pepocasella/Projeto-Mecatronico/Mecânica/Garra/Imagens/s-l1600-1.jpg

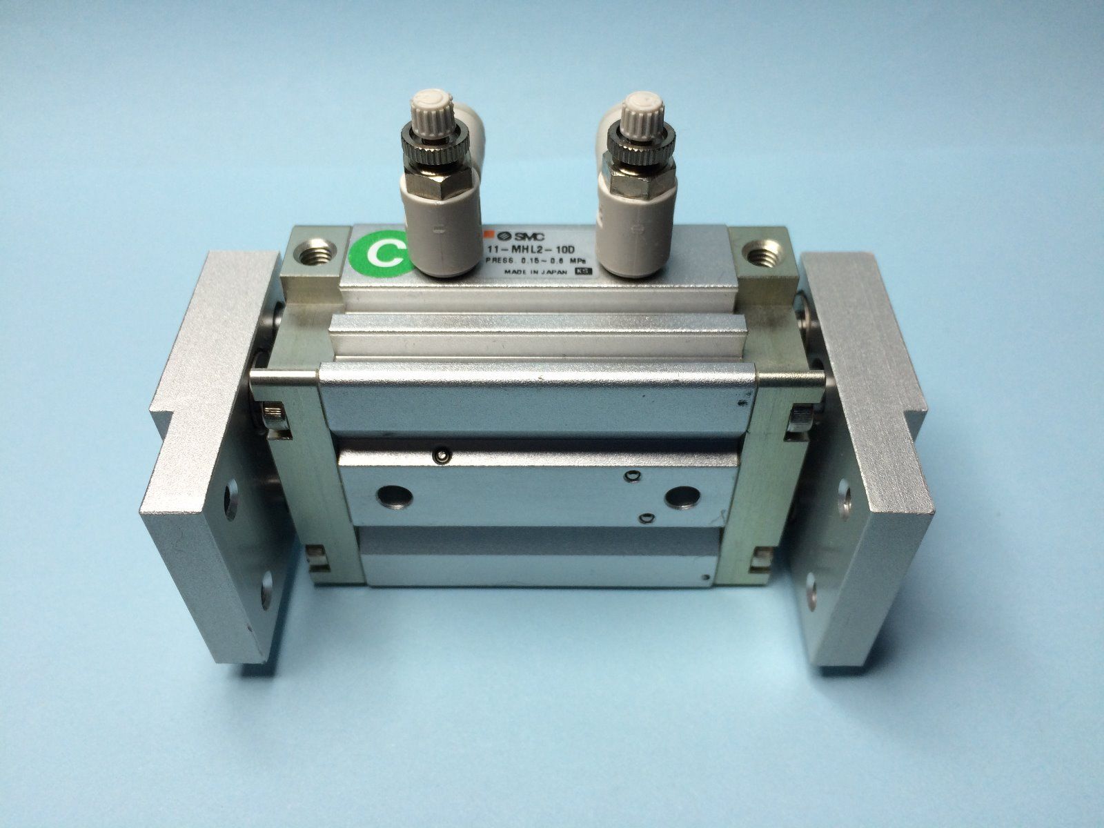
Mecânica/Garra/Imagens/s-l1600-1.jpg
