pepocasella/Projeto-Mecatronico/README.md

# Projeto-Mecatronico
sistema pórtico de eixos X,Y e Z, com função de seleção de peças por meio de certos parâmetros e um mecanismo para posicionamento e captura de peças em posições de pega (Pick) e solta (Place) definidas pelo usuário.


Full Assembly
THE REAL PAULERA v4
