pepocasella/Projeto-Mecatronico/Elétrica/Sensor de Distância/geometria.pptx

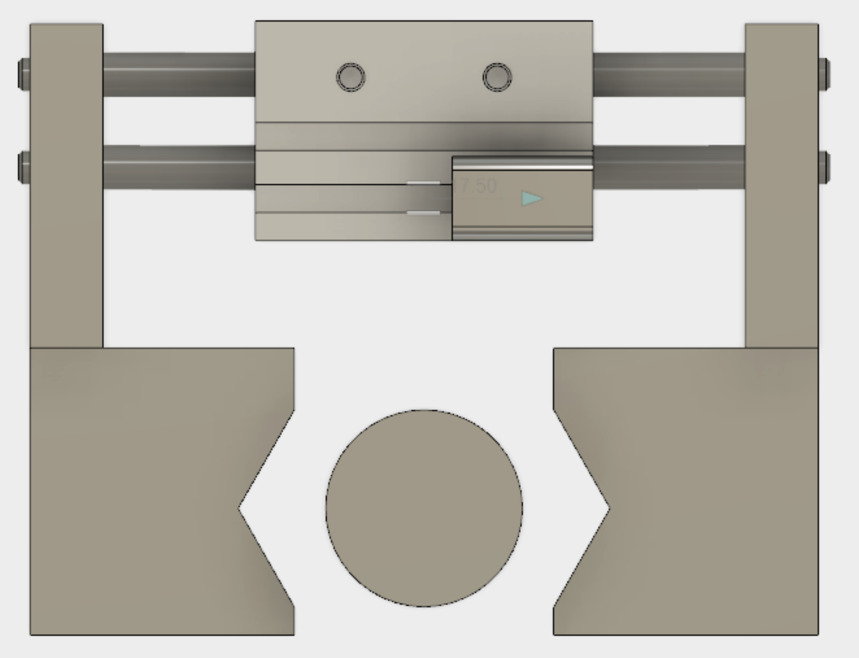
[picture p19: figure]

Bloco Garra

SensorTCRT5000

Haste da garra

Distância_(sensor_(centro))

Distancia_(sensor)

R

cosθ∙D

D

Ө

Centro_(tarugo)

Tarugo de polímero
