pepocasella/Projeto-Mecatronico/Documentos Gerais/Fluxogramas/FluxogramasGrupoDiametro.docx

Fluxogramas dos Algoritmos

Data da criação: 06/06/2017

Data da versão: 10/03/2017

Descrição: Este documento ilustra, por meio de fluxogramas, o funcionamento e as sequências lógicas do dispositivo a ser fabricado pelo grupo. Nele, contém quatro (4) esquemas de fluxogramas, um para cada parte dos algoritmos que serão confeccionados para as partes de: referenciamento; função JOG; capturar e salvar as posições de eixo e posicionamento de eixo.

Fluxograma de Referenciamento

Jog

Pick and Place

Posicionamento de Eixo
