pepocasella/Projeto-Mecatronico/Gates/Gate 1/Ementa GATE1.docx

Ementa GATE #1 21/03/2017

Carlos Magno

- NR aplicada no projeto estar presente no GATE #2;
- Esboço da solução tem que vir depois da matriz de soluções, junto com a interface e os esboços de outras partes do dispositivo;
- Especificar mais a função global;
- “Pegar Peça” na função global;
- Gant: projeto detalhado não tem que ter mais tempo?
- Gant: mais prototipação = menos erros;
- Estrutura de função com “- ruído”. Como minimizar isso?
- Estrutura de funções está confusa.

Arruda

- Estrutura de funções:
  - Traduzir para projeto;
  - Considerar homem-máquina.
- Anotar o budget;
- Gant: colocar tarefas paralelamente e com responsáveis;

Lourenço

- Acentos, gramática.

Sylvio

- Sem variantes = tomamos o risco;
- NR-12 depois, GATE #2;
- Colocar tampa no dispositivo.

Fabio

- Lista de requisitos tem que estar presente;
- Quem falou ruído? (NR, Usuário, etc)
- Ruído tem que virar sub-função;
- Conversar mais com o usuário;
- Função global com cores diferentes, atenção aos verbos e palavras;
- Nós sabemos PDP? TEM QUE ESTAR NA DOCUMENTAÇÃO.
