pepocasella/Projeto-Mecatronico/Gates/Gate 1/Função Global.pptx

Peça

Selecionar Tarugos de Polímero pelo Diâmetro

Peça

Informações

Energia Elétrica

Vibração

Informações

Ruído

Calor
