pepocasella/Projeto-Mecatronico/Mecânica/Guia Linear/GUIA ERRADA/Especificação das Guias Lineares.pdf

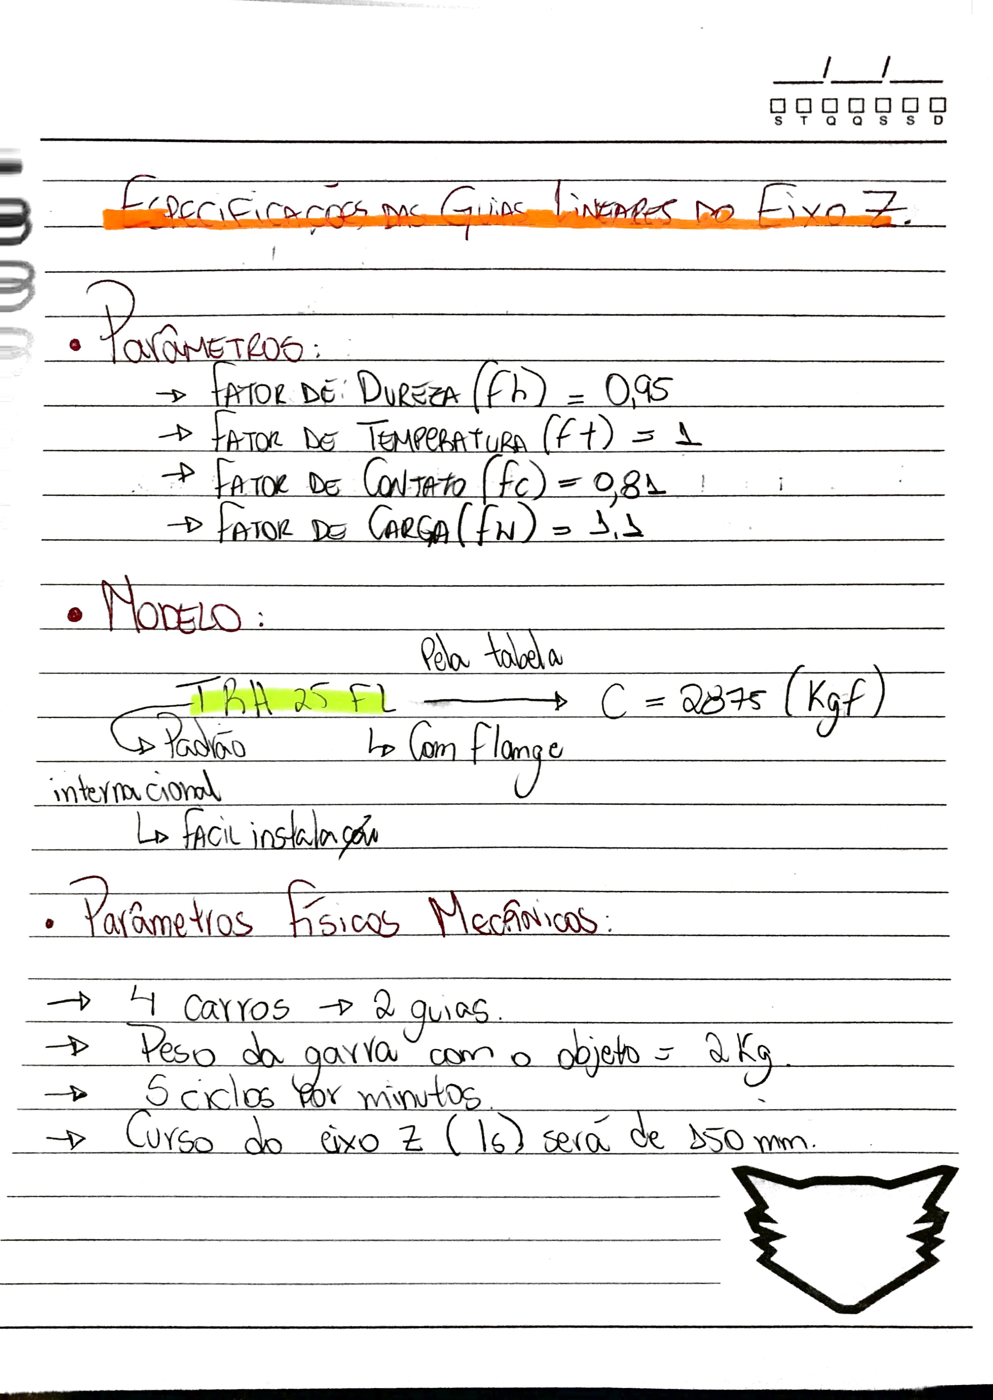
[picture p65: page 1]
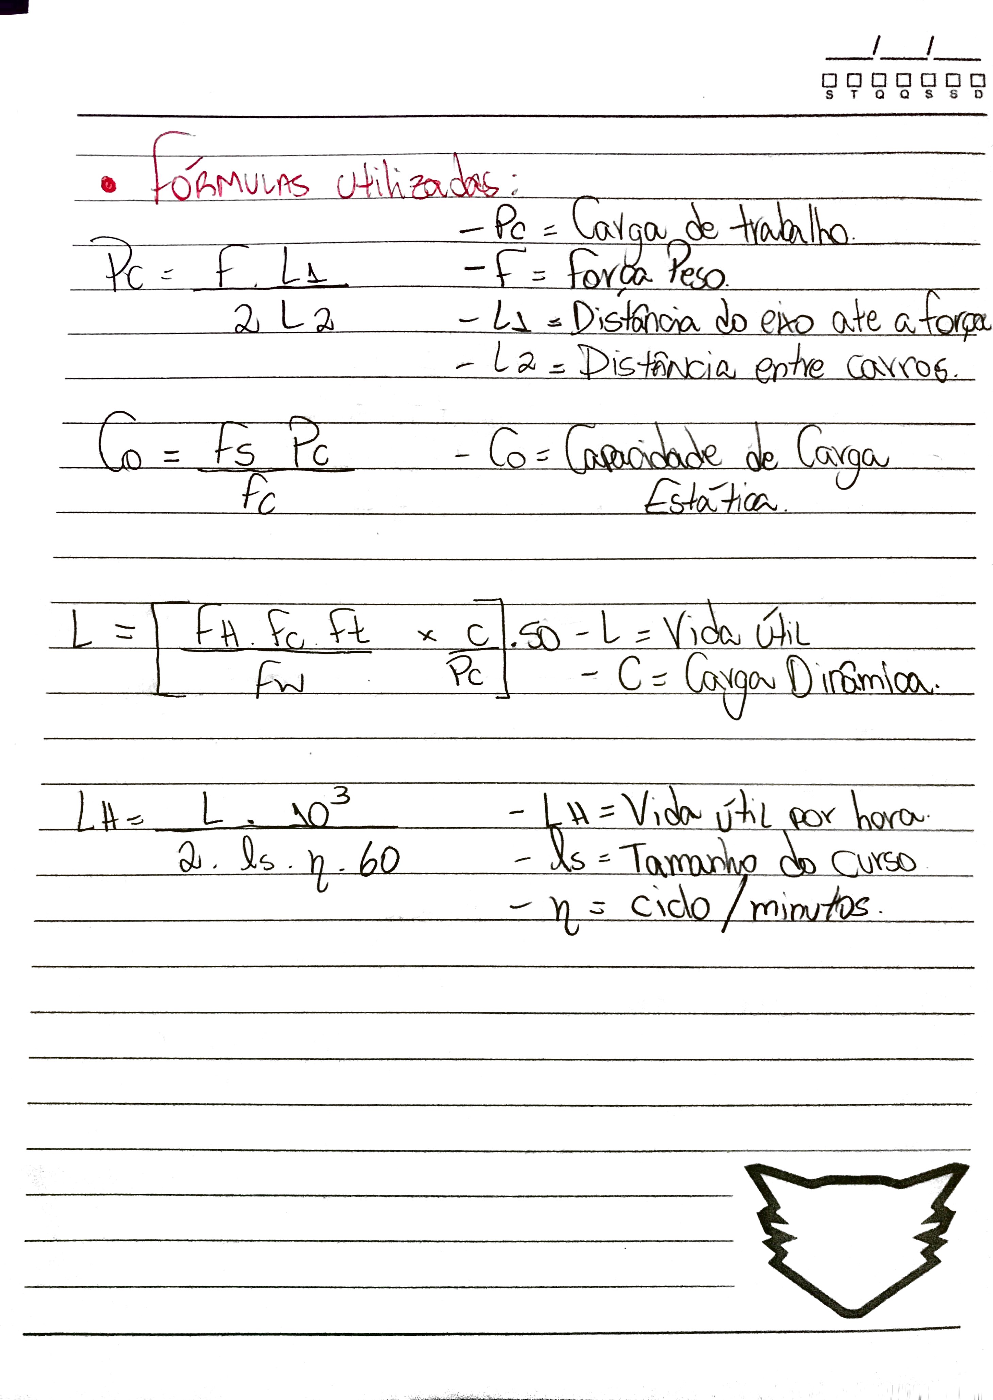
[picture p66: page 2]
