pepocasella/Projeto-Mecatronico/Elétrica/Sensor de Distância/geometria.PNG

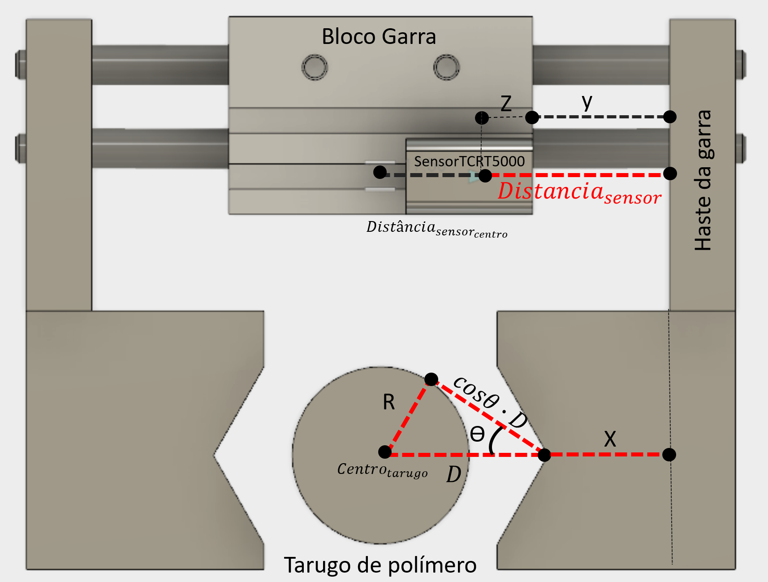
Elétrica/Sensor de Distância/geometria.PNG
