pepocasella/Projeto-Mecatronico/FOTOS_PROJETO_MECAT/20170602_114746.jpg

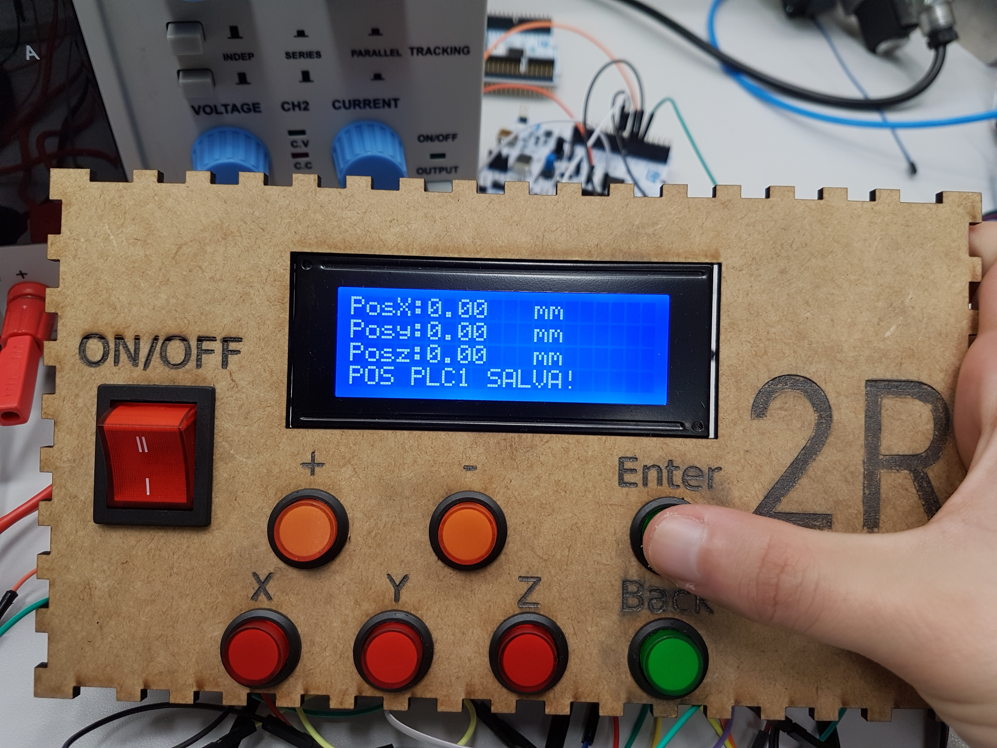
FOTOS_PROJETO_MECAT/20170602_114746.jpg
