pepocasella/Projeto-Mecatronico/FOTOS_PROJETO_MECAT/20170602_114902.jpg

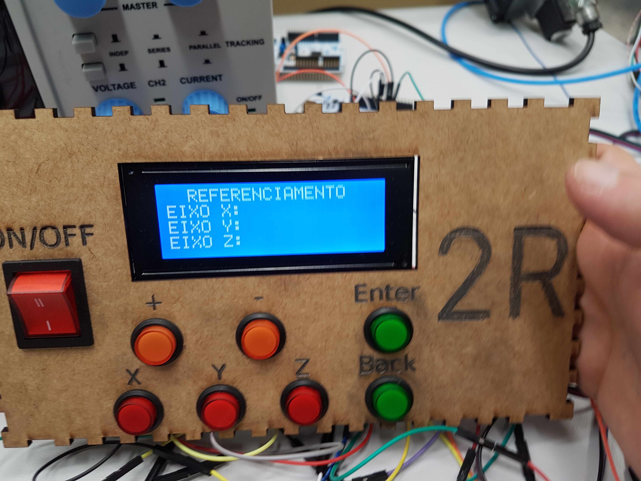
FOTOS_PROJETO_MECAT/20170602_114902.jpg
