pepocasella/Projeto-Mecatronico/FOTOS_PROJETO_MECAT/20170602_114916.jpg

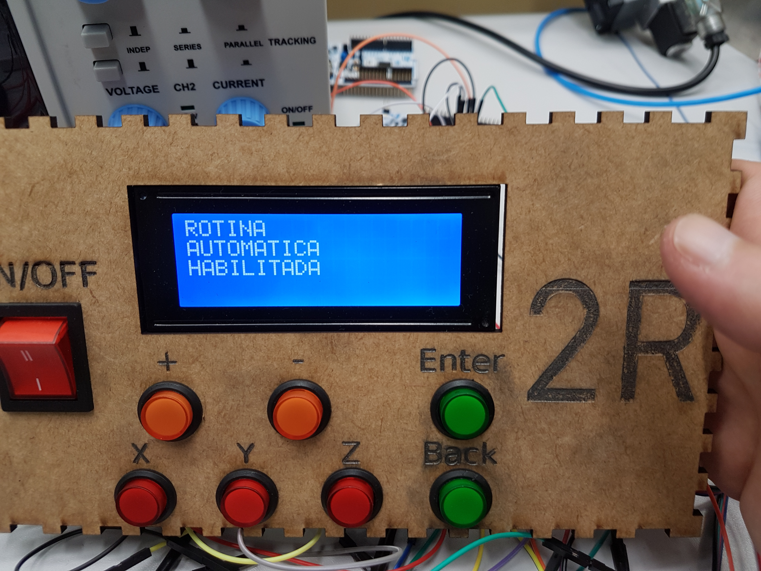
FOTOS_PROJETO_MECAT/20170602_114916.jpg
