pepocasella/Projeto-Mecatronico/FOTOS_PROJETO_MECAT/20170602_114933.jpg

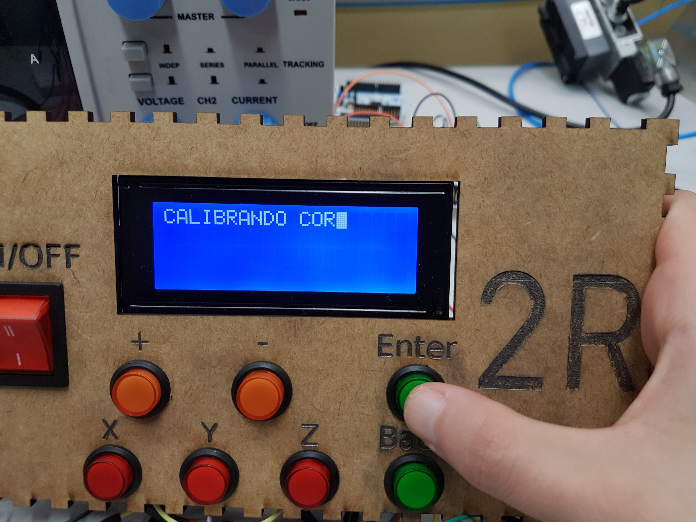
FOTOS_PROJETO_MECAT/20170602_114933.jpg
