pepocasella/Projeto-Mecatronico/FOTOS_PROJETO_MECAT/20170602_115433.jpg

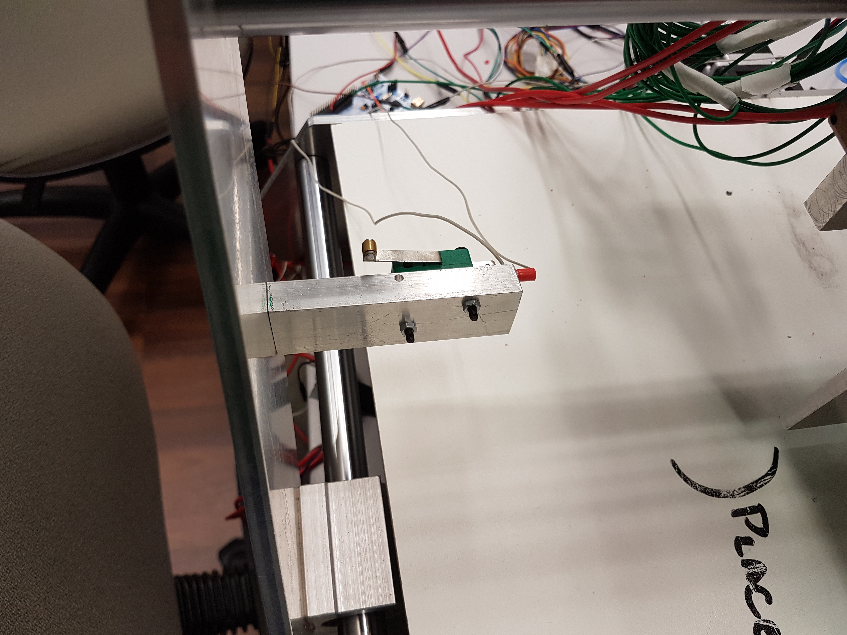
FOTOS_PROJETO_MECAT/20170602_115433.jpg
