pepocasella/Projeto-Mecatronico/FOTOS_PROJETO_MECAT/20170602_115439.jpg

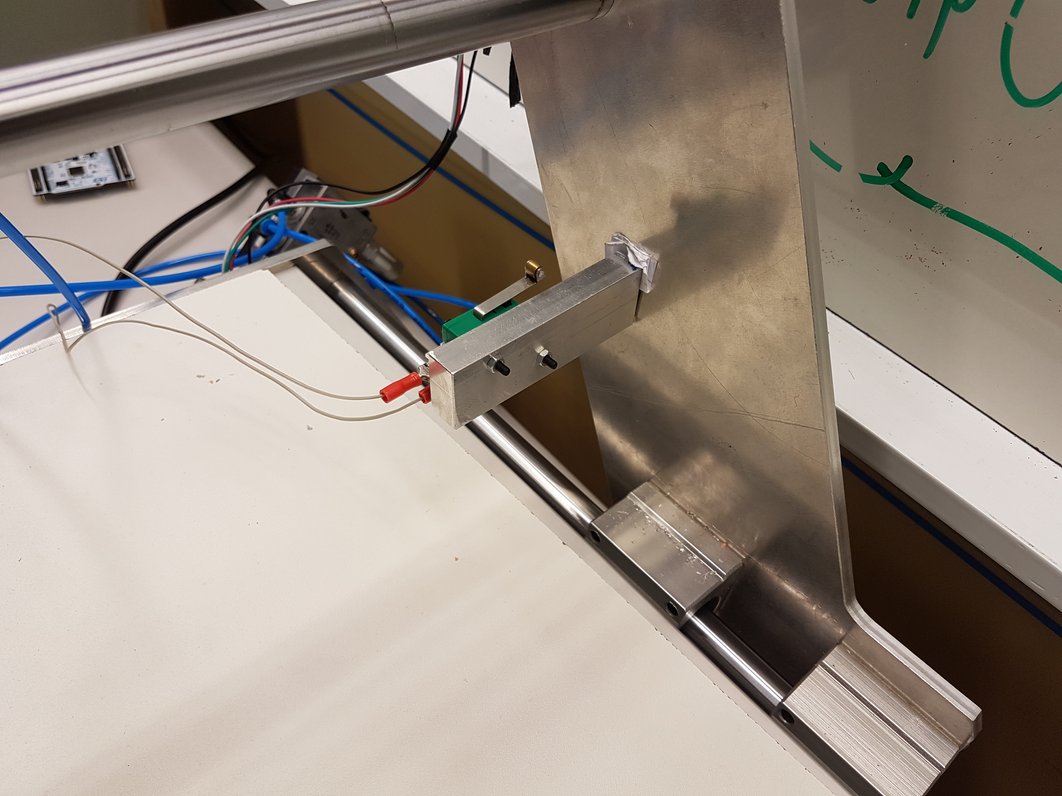
FOTOS_PROJETO_MECAT/20170602_115439.jpg
