pepocasella/Projeto-Mecatronico/FOTOS_PROJETO_MECAT/20170602_115500.jpg

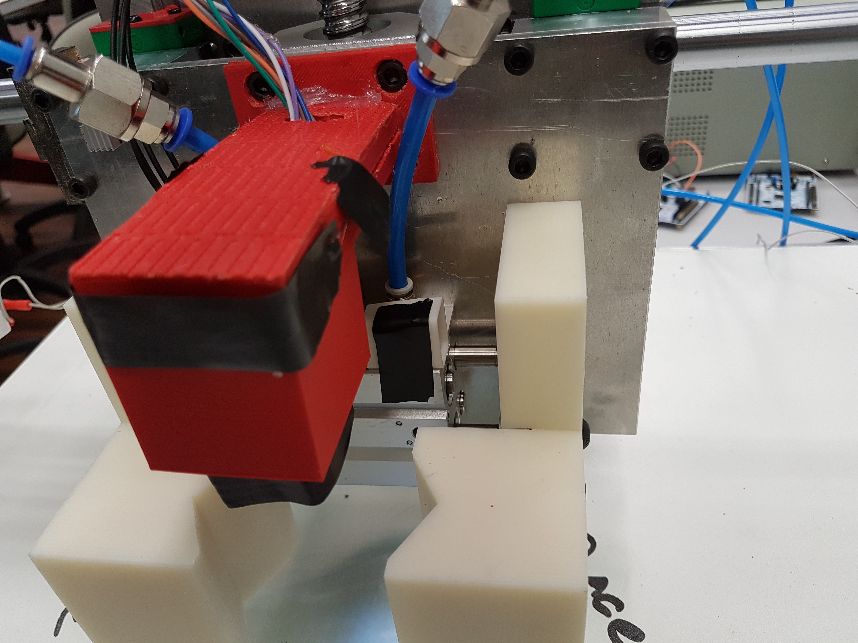
FOTOS_PROJETO_MECAT/20170602_115500.jpg
