pepocasella/Projeto-Mecatronico/FOTOS_PROJETO_MECAT/botao_x_on_off.PNG

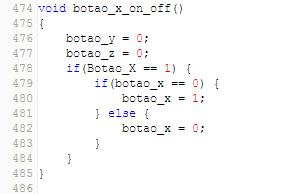
FOTOS_PROJETO_MECAT/botao_x_on_off.PNG
