pepocasella/Projeto-Mecatronico/FOTOS_PROJETO_MECAT/MOVIMENTACAO EIXO NEGATIVA.PNG

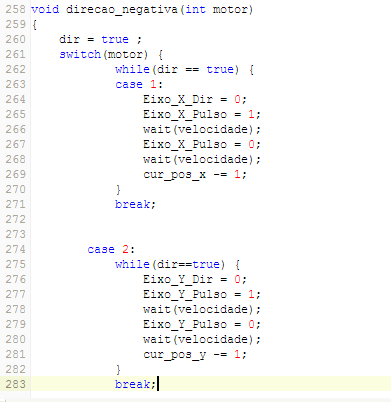
FOTOS_PROJETO_MECAT/MOVIMENTACAO EIXO NEGATIVA.PNG
