pepocasella/Projeto-Mecatronico/FOTOS_PROJETO_MECAT/MOVIMENTACAO EIXO.PNG

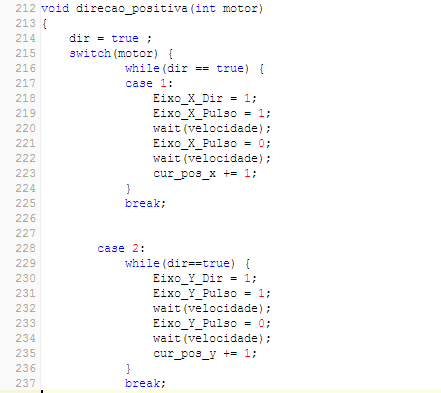
FOTOS_PROJETO_MECAT/MOVIMENTACAO EIXO.PNG
