pepocasella/Projeto-Mecatronico/Gates/Gate 1/Desenho Rascunho 1.jpg

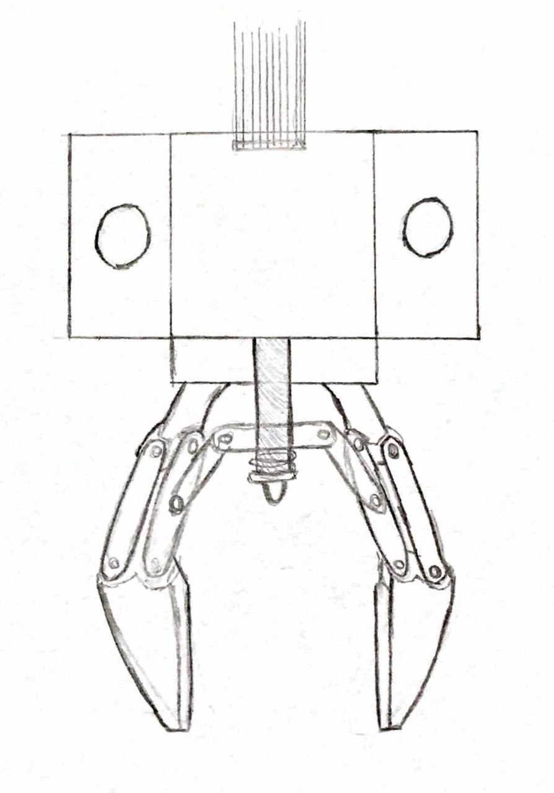
Gates/Gate 1/Desenho Rascunho 1.jpg
