pepocasella/Projeto-Mecatronico/Gates/Gate 1/Desenho Rascunho 2.jpg

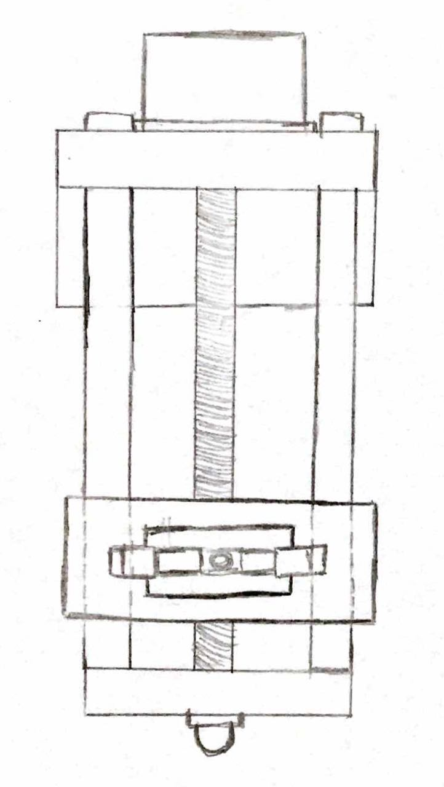
Gates/Gate 1/Desenho Rascunho 2.jpg
