pepocasella/Projeto-Mecatronico/Gates/Gate 1/Estrutura de Funções.jpeg

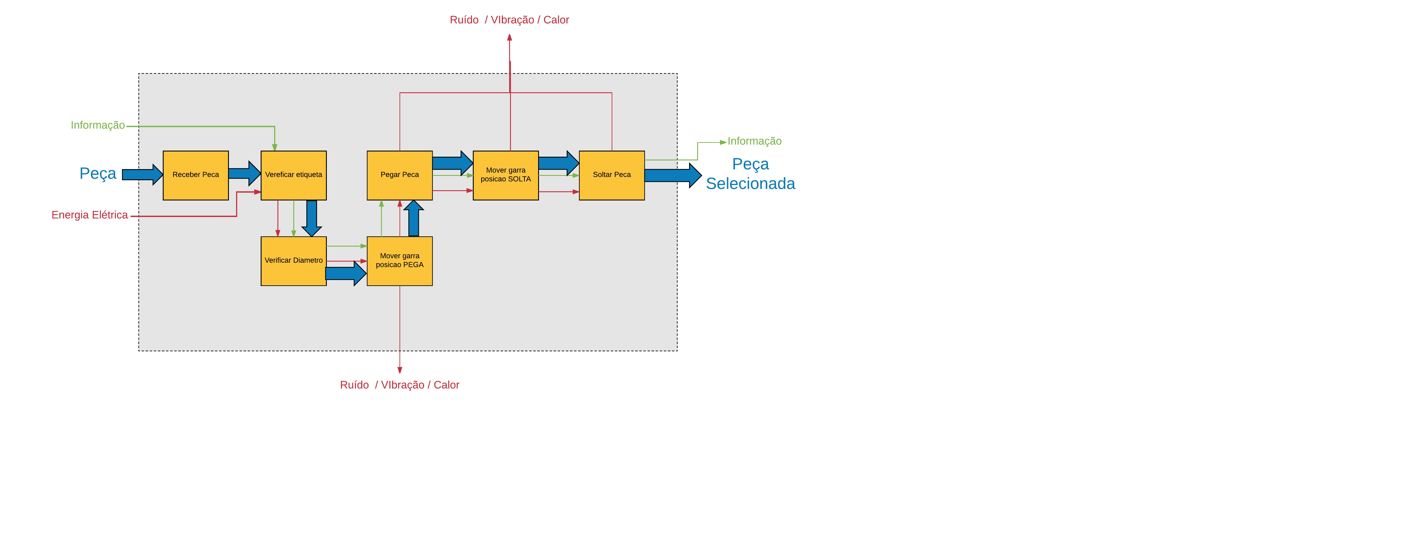
Gates/Gate 1/Estrutura de Funções.jpeg
