pepocasella/Projeto-Mecatronico/Gates/Gate 1/mover garra posiçao.PNG

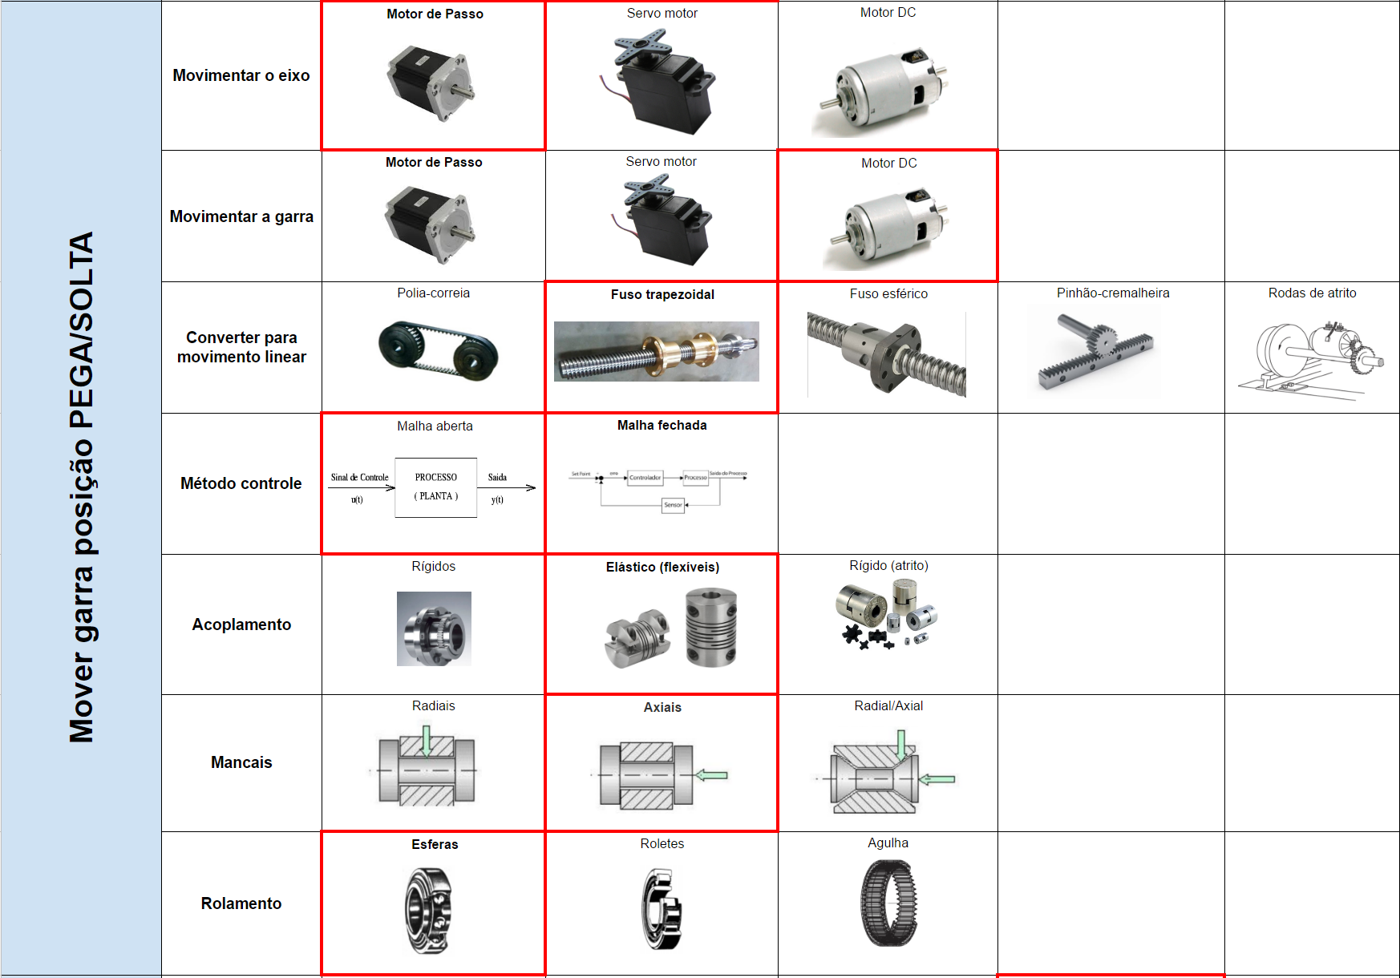
Gates/Gate 1/mover garra posiçao.PNG
