pepocasella/Projeto-Mecatronico/Gates/GATE 2/FOTOS/BF12.PNG

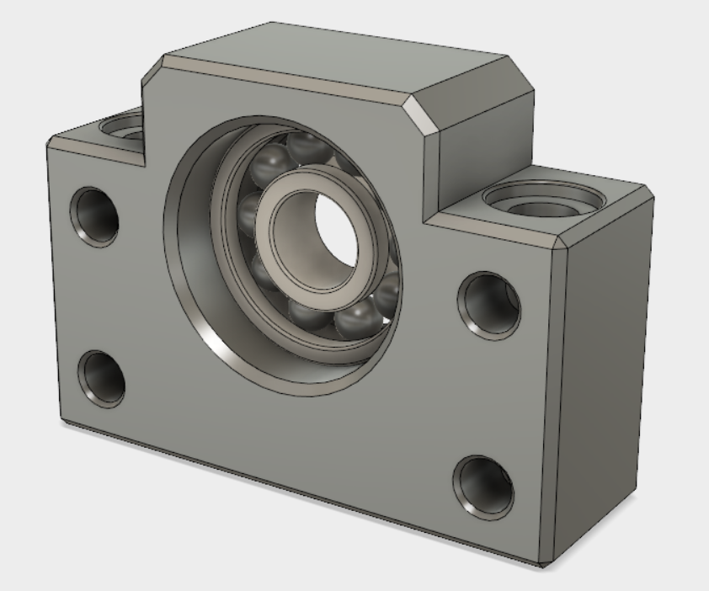
Gates/GATE 2/FOTOS/BF12.PNG
