pepocasella/Projeto-Mecatronico/Gates/GATE 2/FOTOS/BK12.PNG

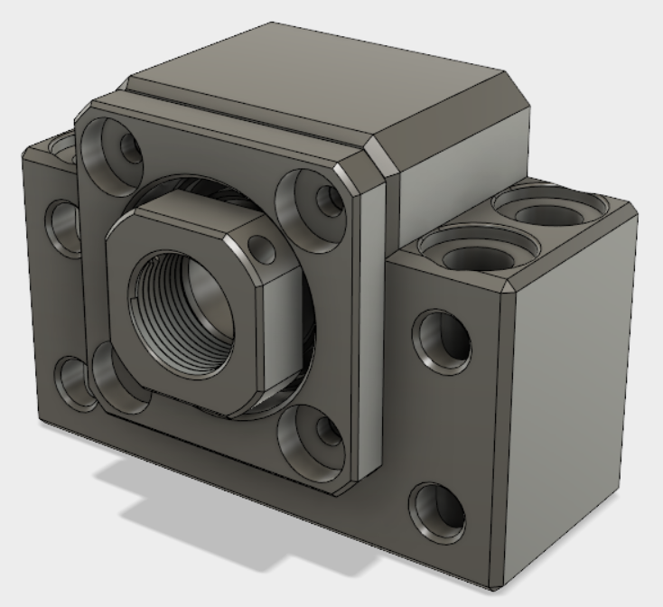
Gates/GATE 2/FOTOS/BK12.PNG
