pepocasella/Projeto-Mecatronico/Gates/GATE 2/FOTOS/Bloco Guia Linear.PNG

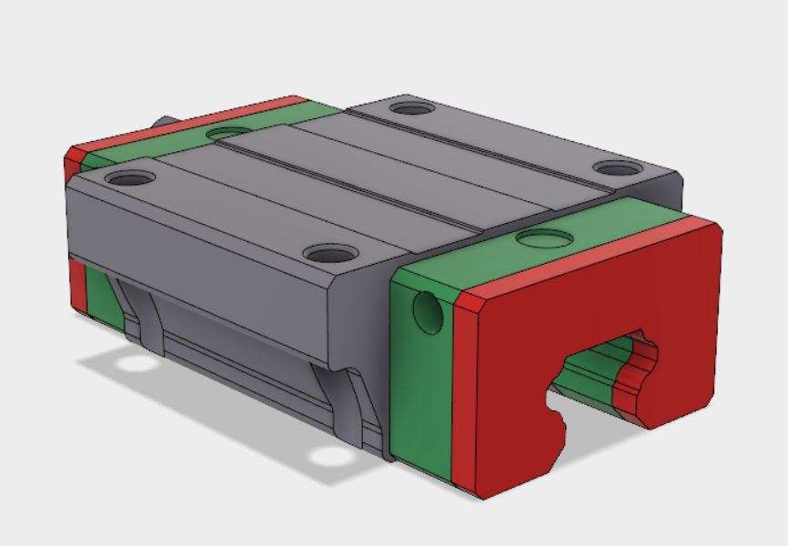
Gates/GATE 2/FOTOS/Bloco Guia Linear.PNG
