pepocasella/Projeto-Mecatronico/Gates/GATE 2/FOTOS/FUSO FINAL.PNG

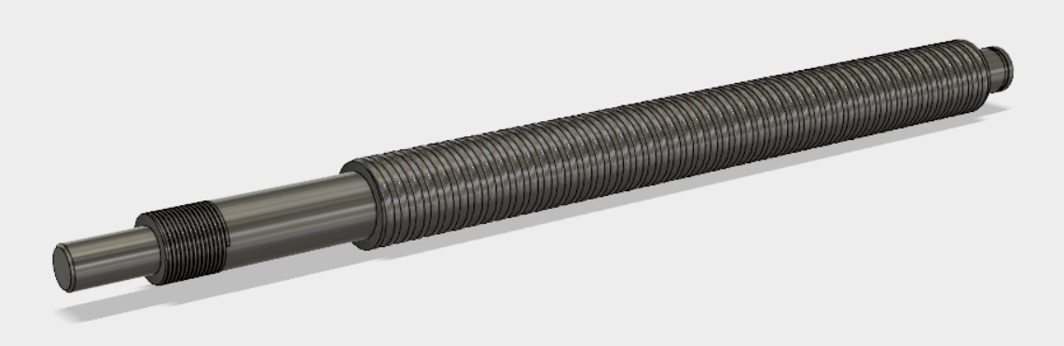
Gates/GATE 2/FOTOS/FUSO FINAL.PNG
