pepocasella/Projeto-Mecatronico/Gates/GATE 2/FOTOS/GARRA + HASTES.PNG

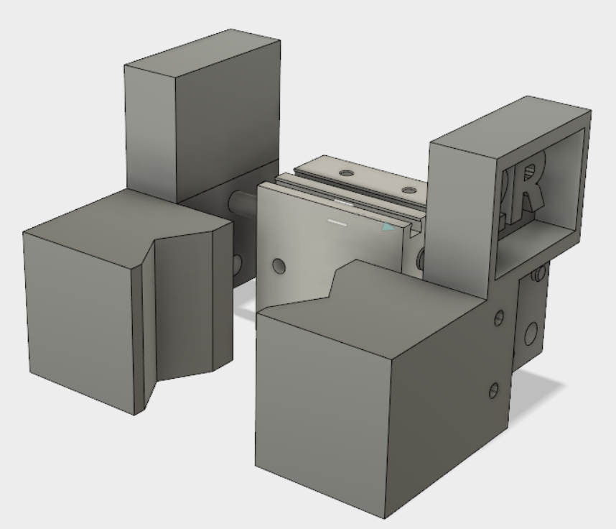
Gates/GATE 2/FOTOS/GARRA + HASTES.PNG
