pepocasella/Projeto-Mecatronico/Gates/GATE 2/FOTOS/Screen Shot 2017-06-05 at 18.27.19.png

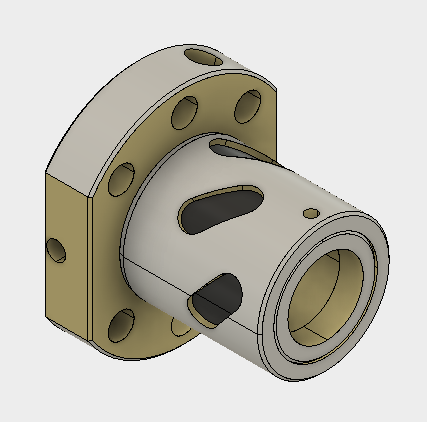
Gates/GATE 2/FOTOS/Screen Shot 2017-06-05 at 18.27.19.png
