pepocasella/Projeto-Mecatronico/Gates/GATE 2/FOTOS/THE REAL PAULERA v4.png

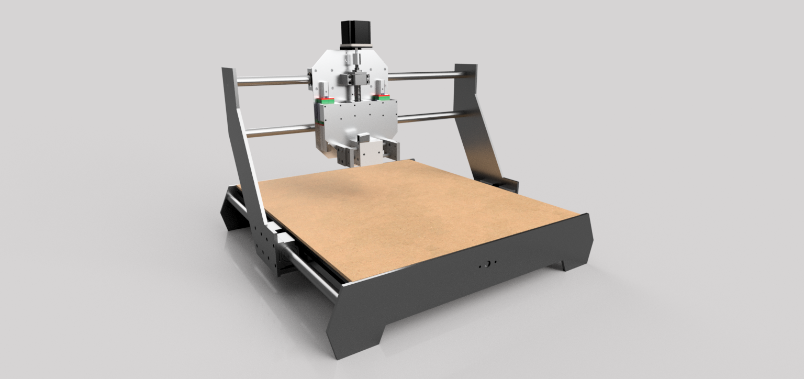
Gates/GATE 2/FOTOS/THE REAL PAULERA v4.png
