pepocasella/Projeto-Mecatronico/Mecânica/CADs/BF12/Renderings/rendering1.png

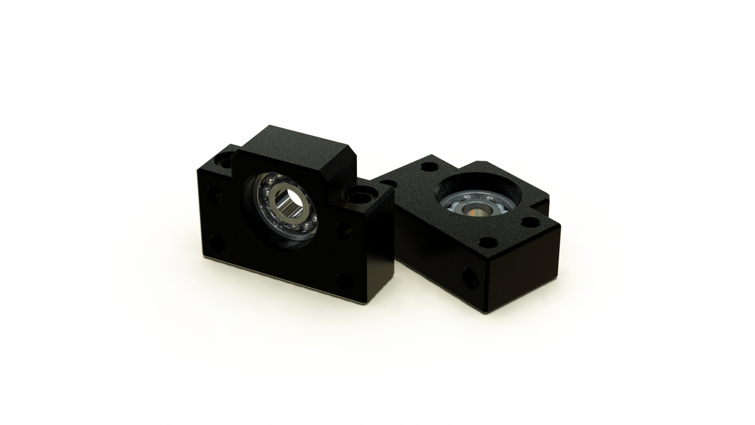
Mecânica/CADs/BF12/Renderings/rendering1.png
