pepocasella/Projeto-Mecatronico/Mecânica/CADs/BF12/Renderings/rendering3.png

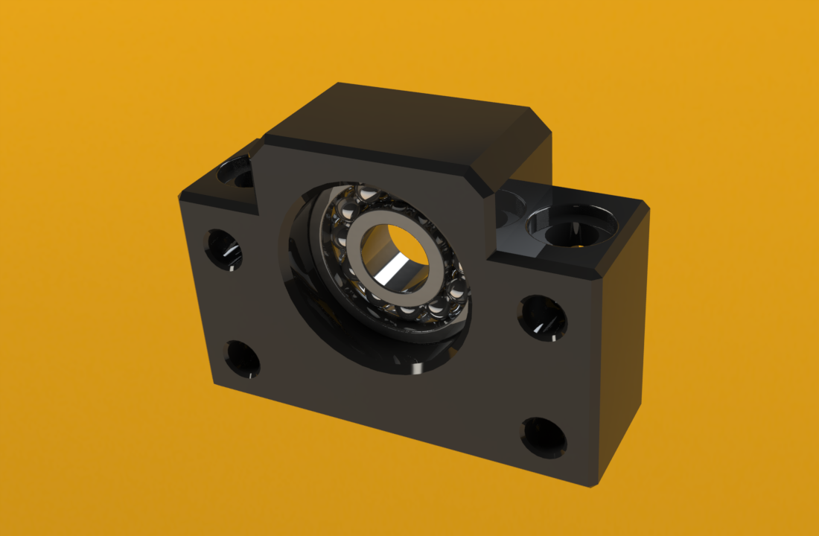
Mecânica/CADs/BF12/Renderings/rendering3.png
