pepocasella/Projeto-Mecatronico/Mecânica/CADs/BF12/Renderings/rendering4.png

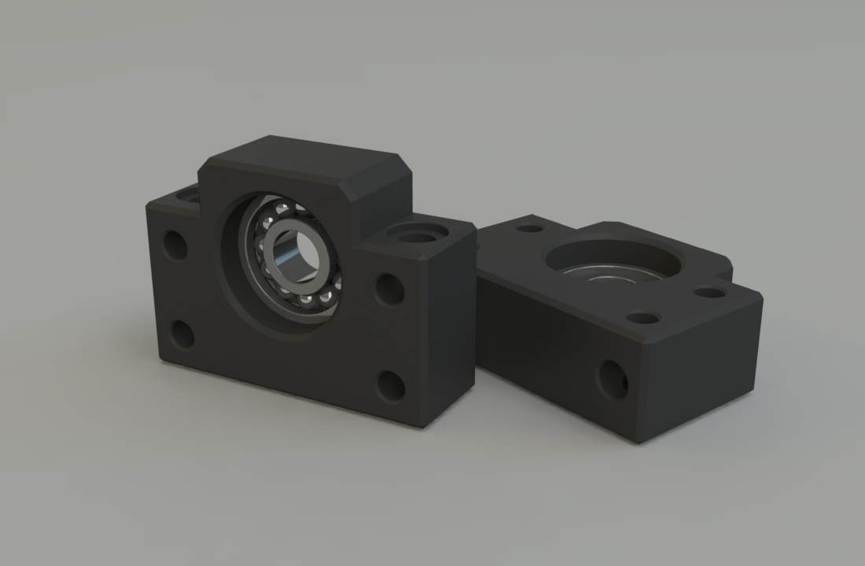
Mecânica/CADs/BF12/Renderings/rendering4.png
