pepocasella/Projeto-Mecatronico/Mecânica/CADs/BF12/Renderings/rendering5.png

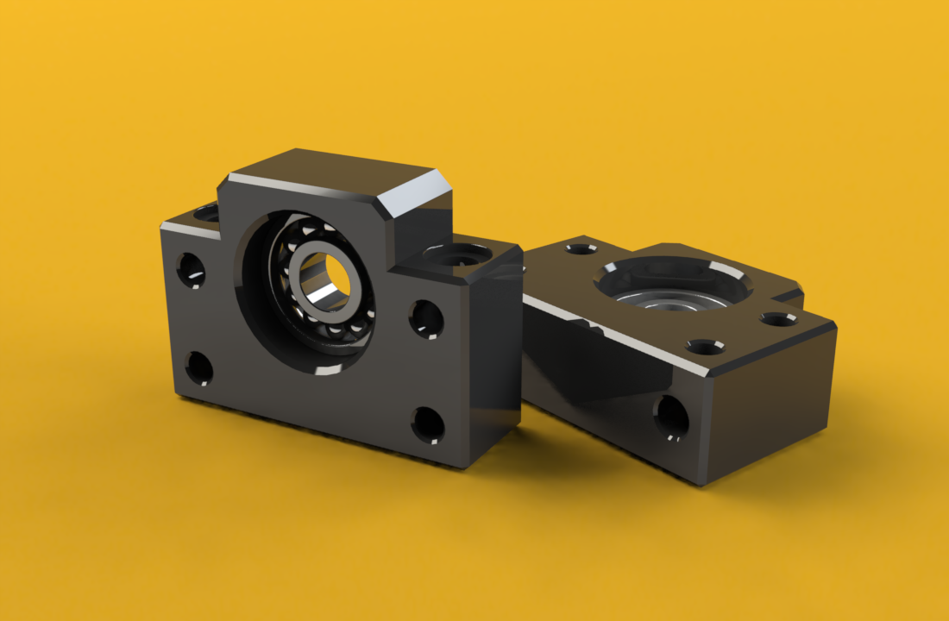
Mecânica/CADs/BF12/Renderings/rendering5.png
