pepocasella/Projeto-Mecatronico/Mecânica/CADs/BF12/Renderings/snapshot1.png

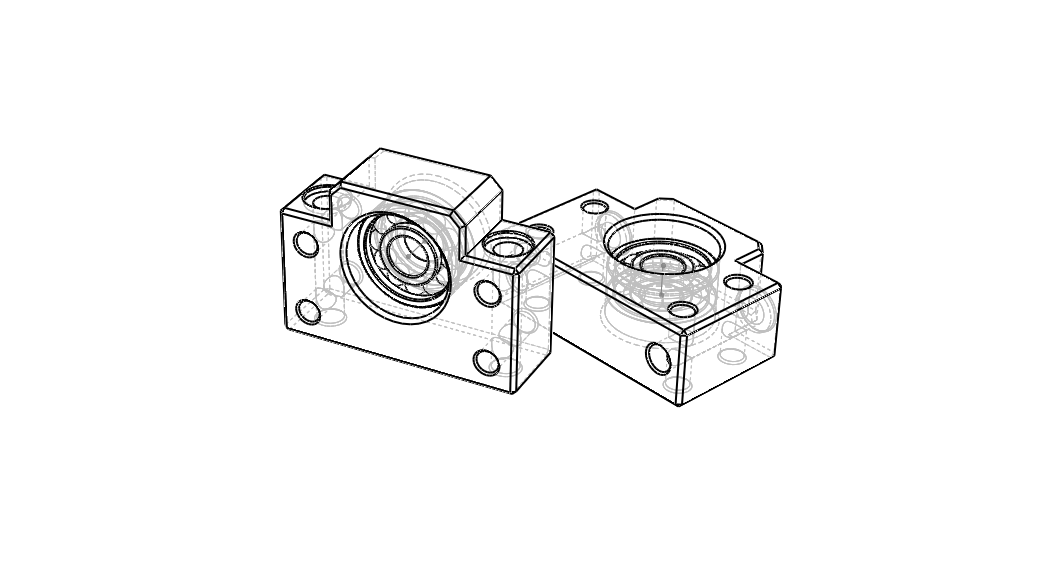
Mecânica/CADs/BF12/Renderings/snapshot1.png
