pepocasella/Projeto-Mecatronico/Mecânica/CADs/BF12/Renderings/snapshot3.png

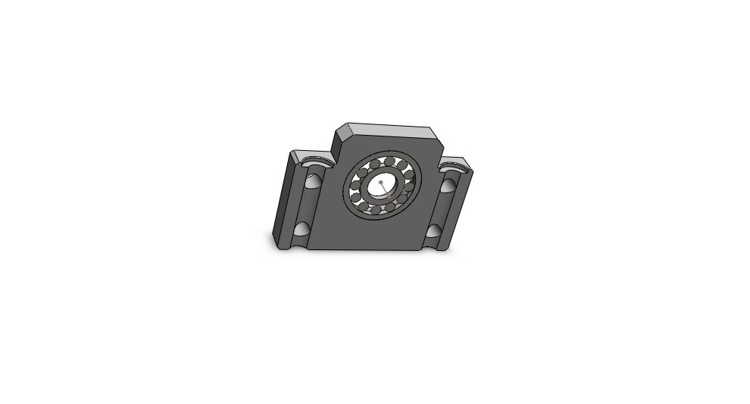
Mecânica/CADs/BF12/Renderings/snapshot3.png
