pepocasella/Projeto-Mecatronico/Mecânica/CADs/Suporte Castanha/render.gif

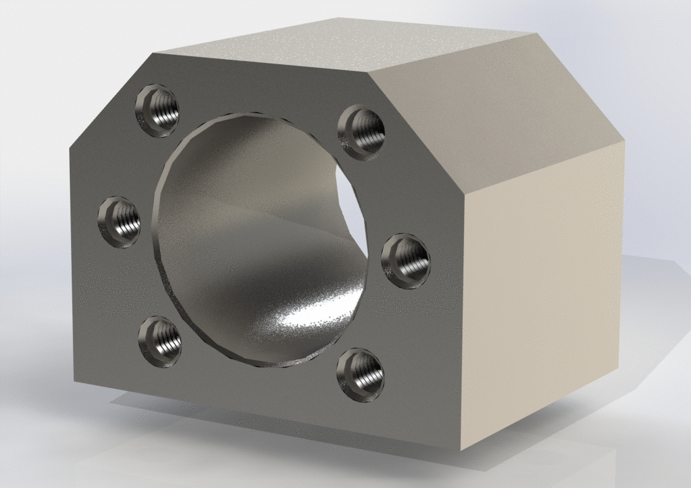
Mecânica/CADs/Suporte Castanha/render.gif
