pepocasella/Projeto-Mecatronico/Mecânica/Garra/Imagens/s-l1600-2.jpg

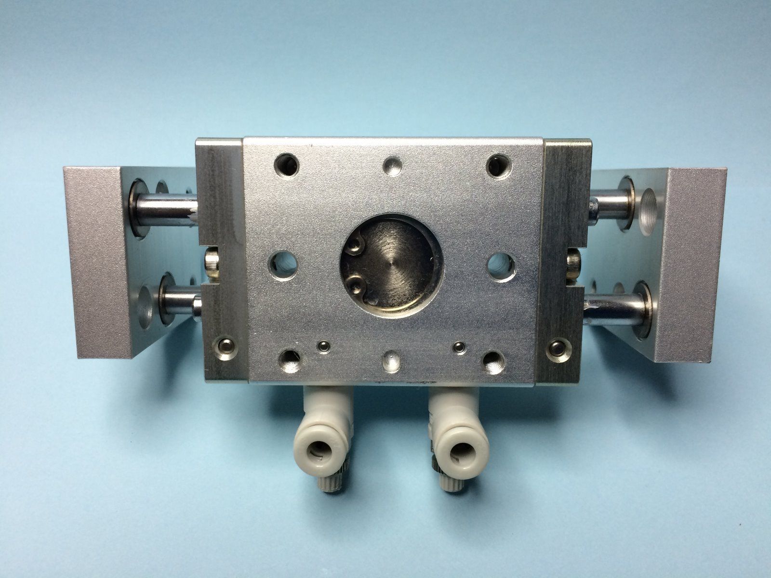
Mecânica/Garra/Imagens/s-l1600-2.jpg
