pepocasella/Projeto-Mecatronico/Mecânica/Garra/Imagens/s-l1600-3.jpg

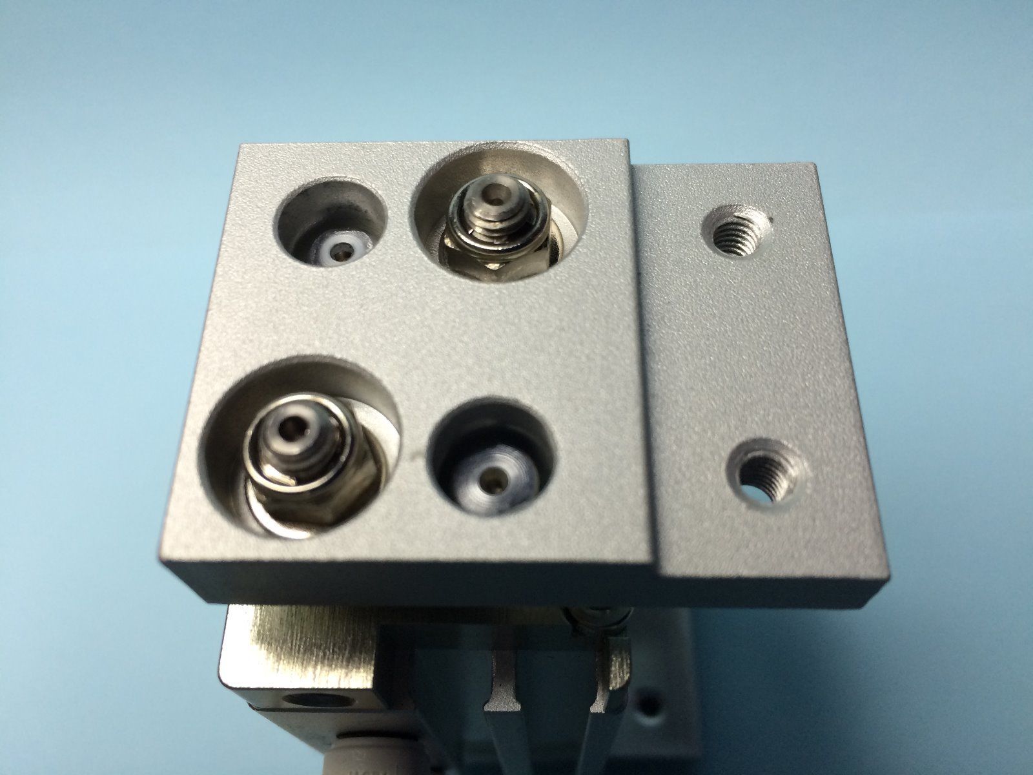
Mecânica/Garra/Imagens/s-l1600-3.jpg
