pepocasella/Projeto-Mecatronico/Mecânica/Garra/Imagens/s-l1600-4.jpg

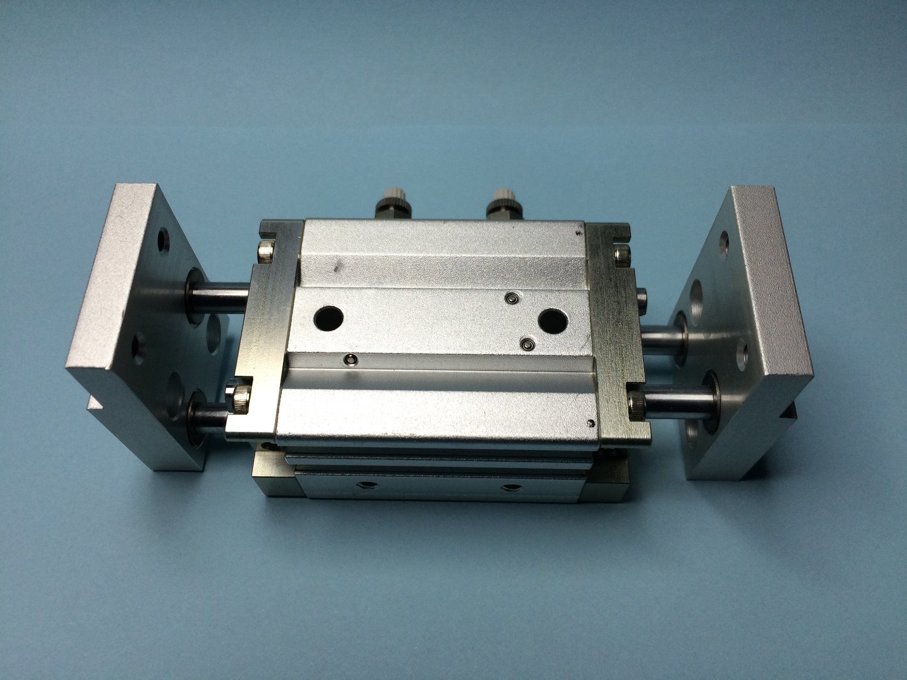
Mecânica/Garra/Imagens/s-l1600-4.jpg
