pepocasella/Projeto-Mecatronico/Mecânica/Orçamentos/Contato Orcamento Mectrol.jpg

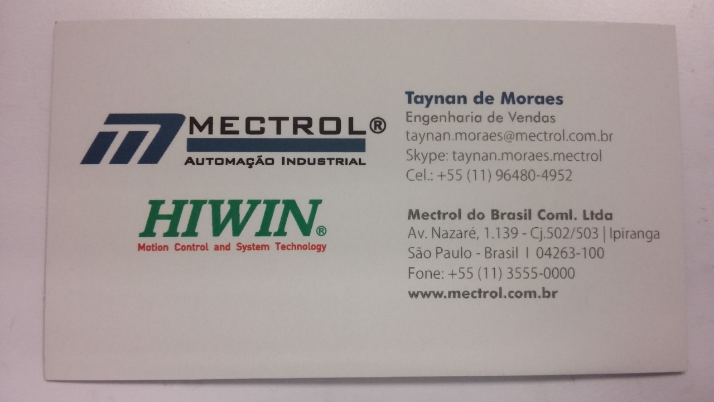
Mecânica/Orçamentos/Contato Orcamento Mectrol.jpg
