pepocasella/Projeto-Mecatronico/Gates/Gate 1/Cópia de Matriz de soluções.xlsx

Sheet: Matriz de soluções
 |  | Grupo | Data de criação: 24/10/2017
 |  |  | Data da versão: 21/03/2017
 |  |  | Versão: 2.0
 |  | Luca Facciolo Avy Pinto Nicolas Fonteyne Gabriel Avy | Resumo: A partir da norma de segurança do trabalho NR-12, este documento destaca os requisitos mínimos que devem ser adotados para garantir a integridade física dos futuros operadores do dispositivo a ser confeccionado na disciplina de Projeto Mecatrônico.
 |  | Função/Solução | Métodos
 |  |  | 1 | 2 | 3 | 4
Receber Peça | A | Zeramento | Chave de fim-de-curso | Sensor indutivo | Sensor capacitivo | Sensor magnético
 | B | Referenciamento de posição | Via software | LVDT | Encoder Absoluto | Potenciometro
Mover a ventosa de sucção para posição PEGA / ESTEIRA | C | Movimentar o eixo | Motor de Passo | Servo motor | Motor DC
 | D | Identificar presença de material | Sensor optico difuso | Ultrassönico | Encoder incremental
Soltar/Segurar Peça | E | Segurar peça | Ventosa de sucção
 | F | Acionamento Sucção | 5/2 Vias | 3/2 vias
 | o

Sheet: Respostas ao formulário 1
Carimbo de data/hora | Untitled Question

Sheet: Faccioli
Receber Peça | Referenciamento de posição relativa | Sensor optico difuso | LVDT | Potenciometro | Encoder incremental | Encoder Absoluto | Ultrassonico
Verificar etiqueta | Identificar cor | RGB sensor
Verificar diâmetro | Identificar as dimensões do objeto | Resolver | Sensor optico | sensor ultrassonico
Referenciamento de posição | Sensor optico difuso | LVDT | Potenciometro | Encoder incremental | Encoder Absoluto | Sensor Ultrassônico
Funcionamento | Emite e recebe um feixe de luz que possibilita o cálculo da distância do objeto refletor | funciona a partir de bobinas eletromagnéticas e a movimentação do objeto interno modifica o campo e consequentemente resulta numa saida analógica diferente de zero | Cada posição corresponde a uma determinada resistência , variada de acordo com o seu deslocamento | Gera pulsos de acordo com seu deslocamento angular | Cada posição do disco corresponde a uma leitura em código binário | Emite uma onda sonora e calcula o tempo de seu retorno
Custo | Baixo-Médio | Muito Alto | Baixo | Médio | Alto | Baixo-Médio
Precisão | Média | Muito Alta | Média | Alta | Muito Alta | Baixa - Alta
Maior Vantagem | Bom custo beneficio | Alta durabilidade e Alta precisão | Excelente custo beneficio | Melhor custo beneficio do que o Encoder Absoluto | Não perde seu referenciamento | Sensores baratos
Maior desvantagem | Limitação de objetos alvo(POUCA PRECISÃO PARA OBJETOS OPACOS) / Distancia de medição baixa | Vibrações e temperatura afetam sua precisão | Durabilidade baixa | Perde seu referenciamento apos desligamento da máquina | Suscetivel a vários tipos de interferencia | Há uma variação muito grande na qualidade destes sensores
Referenciamento da altura | Sensor optico difuso | Sensor Ultrassônico | Sensor indutivo
Funcionamento | Emite e recebe um feixe de luz que possibilita o cálculo da distância do objeto refletor | Emite uma onda sonora e calcula o tempo de seu retorno | Funciona a partir de alterações de campo magnético ao seu redor , o que afeta o seu output
Custo | Baixo-Médio | Baixo-Médio | Baixo
Precisão | Média | Baixa - Alta | Alta
Maior Vantagem | Bom custo beneficio | Sensores baratos | Excelente Custo beneficio
Maior desvantagem | Limitação de objetos alvo(POUCA PRECISÃO PARA OBJETOS OPACOS) / Distancia de medição baixa | Há uma variação muito grande na qualidade destes sensores | Funciona bem só com materiais ferro magneticos
Identificar cor | Sensor de cor RGB
Funcionamento | Cada cor representa uma porta e cada porta tem uma variação em sua tensão de acordo com a cor captada pelo sensor
Custo | Baixo
Precisão | Alta
Maior Vantagem | -
Maior desvantagem | -
Identificar as dimensões do objeto | Resolver | Sensor optico difuso | sensor ultrassonico | Medição pela Garra
Funcionamento | Funcionamento eletromagnético que consegue medir deslocamentos angulares , gerando uma tensão senoidal de acordo com a variação do angulo | Emite e recebe um feixe de luz que possibilita o cálculo da distância do objeto refletor | Emite uma onda sonora e calcula o tempo de seu retorno | -
Custo | Alto | Baixo-Médio | Baixo-Médio | -
Precisão | Alto | Média | Baixa - Alta | -
Maior Vantagem | Durabilidade e precisão | Bom custo beneficio | Sensores baratos | -
Maior desvantagem | Implementação complexa | Limitação de objetos alvo(POUCA PRECISÃO PARA OBJETOS OPACOS) / Distancia de medição baixa | Há uma variação muito grande na qualidade destes sensores | -

Sheet: Rod
Soltar/Pegar Peça | Segurar peça | Garra Pneumática | Pinça mecanica | Ventosa de sucção
 | Abrir e fechar garra | cremalheira | Fuso trapezoidal | Fuso esferico | Ar comprimido ?????
 | Cuidados com a peça (sensores de força) | Sensor piezoeletrico | Sensor com mola | Extensômetro | sensor de corrente
Segurar peça | Garra Pneumática/mecanica | Pinça mecanica | Ventosa de sucção | A pinça mecanica foi a escolhida, apesar dos seus defeitos, pois a sua implementaçao é mais simples que a ventosa. Obs uma garra pneumatica possui é capaz de realziar elevado nuemro de forca e torque, o que nao é necessario nesse peojeto | Ventosa com fole, o tipo mais adequado de ventosa para o sistema estudado
Funcionamento | hastes com parte inferior metálica para medir e parte superior com suporte emborrachadas para aderência | Haste com suporte de borracha para prender a peça, graças ao atrito. | cones que manipulam a pressao do ar para se manter fixado e outras superficies | https://www.passeidireto.com/arquivo/17727552/pneumatica-e-tecnicas-de-comando/19 | https://www.passeidireto.com/arquivo/17727552/pneumatica-e-tecnicas-de-comando/19
Dificuldade na implementacao | media | baixa | grande
Danifica a peça | sim | sim | nao
Baixo custo | nao | sim | sim
velocidade | media | media | alta
Abrir e fechar garra | cremalheira | Fuso trapezoidal | Fuso esferico | Ar comprimido | O fuso de esfera é o mais indicado, pois possui uma alta velocidade, pacuracia, além de ser o que menos consome energia dos tres, o que a longo prazo pode fazer equivaler com seu alto custo. | "Em casos onde precisa de movimentos muito longos, cremalheira é uma ótima opção, mas é claro que, se voce precisa de exatidão digamos centesimal sempre, fuso de esferas passa a ser a melhor opção em detrimento do investimento..."
funcionamento | Transforma movimento angular em movimento linear | Trabalha acoplado a uma porca trapezoidal | Trabalha acoplado a uma porca esferica( angular em angular) | http://lista.mercadolivre.com.br/ | https://www.youtube.com/watch?v=9xSvRSg7VZA | https://www.youtube.com/watch?v=9xSvRSg7VZA
Custo | baixo | medio | alto |  | http://www.guiacnc.com.br/mecanica-geral-207/sistema-de-tracao-comparacao-entre-(fuso-cremalheira-e-polia)/
Velocidade | media | baixa | alta
Acuracia | baixa | media | alta
Rendimento | baixo | baixo | alto
Cuidados com a peça (sensores de força) | Sensor piezoelétrico | Sensor com mola (fim de curso) | Extensômetro | Sensor de corrente | O melhor sensor para essa aplicacao é o sensor de corrente, apesar de nao possuir o melhor preco, é muito facil de ser implementado no circuito |  | AUTO TRAVAMENTO DO MOTOR(PERGUNTAR PARA FABIO)
Funcionamento | algnus materias conseguem transformar deformacao em tensao devido a pressao | A garra vai apertar o material ate as molas estarem 100%comprimidas, quando isso acontecer o circuito "abre" | É um transdutor que converte deformações mecânicas (flexão e/ou torção) em sinais de resistência elétrica proporcionais | Detecta variacoes na corrente, para isso utiliza o efeito hall
Dificuldade de implementacao | media | baixa | media | Baixa
nome | transdutores piezoelétricos | Push-Button | Strain Gage | ACS712
Preco | 2,20, necessario utilizar mais de 1) | 3,20. | 8.99 | 22.87 |  | (http://lista.mercadolivre.com.br/)

Sheet: Pepo
Mover garra posição PEGA/SOLTA | Movimentar o eixo | Motor de passo | Servo motor | Motor DC
 | Converter para movimento linear | Polia-correia | Fuso trapezoidal | Fuso esferico | pinhão-cremalheira | Rodas de atrito
 | Método controle | Malha aberta | Malha fechada
 | Acoplamento | Rígidos | Elástico (flexíveis) | rígido (atrito)
 | Mancais | Radiais (mancal de apoio) | Axiais (mancal de escora) | Radial/Axial
 | Rolamento | Esferas | Roletes | Agulha
 | Movimentar o eixo | Motor de passo | Servo motor | Motor DC (com escova) | Motor Brushless trifasico
 | custo | Médio | Alto | Baixo | Alto
 | manutenção | Baixa | Alto | Alto | Baixo
 | Circuito Driver Complexidade | Baixa | Alta | Alta | Alta
 | Vibração | Média | Baixa | Alta
 | Torque | Alto | Médio | Alto (caixa de redução)
 | Precisão | Alto | Alto | Baixa
 | Velocidade | Baixa (1000-2000rpm) | Média (3000-5000rpm) | Alta (6000-12000rpm)
 | Resolução | Alta | Alta | Baixa
 | Funcionamento | motores de passo são motores elétricos que possuem pólos fixos para precisão e diferente dos motores de corrente contínua não contém escovas e comutadores. E diferente dos motores de corrente contínua e servomotores é que o motores de passo contém precisão e força. | ervomotores são parecidos com motores de passo, porém contém um sistema de controle interno o qual verifica a posição de entrada com a posição de saída e um motor de corrente contínua. E apesar de terem precisão, o servos não tem muita força como motores de passo. | O motor utiliza imã para se movimentar, isto é, utiliza o magnetismo. Ao aplicar uma tensão de corrente contínua, a corrente passa pelas escovas e depois pelo comutador, o qual faz o eixo girar.
 | Converter para movimento linear | Polia-correia | Fuso trapezoidal | Fuso esférico | pinhão-cremalheira | Rodas de atrito
 | custo | baixo | baixo | médio | baixo | alto
 | vibração | baixo | médio | baixa | alto | baixo
 | exatião no posicionamento | média | baixa | alta | baixo | muito alta
 | capacidade de transmissão de torque | baixa | alta | alta | alta | baixa
 | manutenção | alta | média | média | alta | média
 | atrito | baixo | alto | baixa | baixo | alto
 | vida últil | alta | média | alta | média | média
 | Funcionamento |  | conversão de movimento rotacional em linear. É possivel obter um posicionamento bastante preciso. Autotravamento
 | Acoplamento | Rígidos | Elástico (flexíveis) | rígido (atrito) | Obs; acoplamento elastico é necessario uma vez que a compensação de desalinhamento de eixo é indispensavel para aplicaçao de CNC
 | Custo | alto | médio | médio
 | Rigidez | alto | alto | alto
 | Erro de segmento | alto | alto | médio
 | Compensação do desalinhamento | baixo | alto | baixo
 | Funcionamento | acoplar como se fosse uma unica peça | tornam mais suave a transmissão do movimento. Permitem o funcionamento do conjunto com desalinhamento paralelo, angular e axial | acoplar como se fosse uma unica peça
 | Mancais | Radiais (mancal de apoio) | Axiais (mancal de escora) | Radial/Axial | os mancais serao axiais para segurarem o fuso do eixo Z /Obs: mancal radial para inibir movimentaçoes na direçao do raio permitir rotação
 | Custo | baixo | baixo | baixo
 | Direção | segura forças radias e permite rotação entorno do eixo axial | segura forças da direção do eixo axial
 | Rolamento | Esferas | Roletes | Agulha | Linear | Obs: Rolamentos de esferas para os mancais de apoio e rolamentos lineares para movimentaçao da ferramenta
 | Velocidades | Alta | Baixa | Baixa
 | Carga | Baixa | Altas | Alta
 | Custo | Baixo | Baixo | Baixo
 | Método controle | Malha aberta | Malha fechada |  | malha aberta para abaixar bastante os custos
 | Estrutura | Simples | Complexa
 | Controle | Simples | Complexo
 | Ruido do driver | Alto | Baixo
 | Precisão | Baixa | Alta
 | Custo | Baixo | Alto
 | Mover garra posição PEGA/SOLTA | Movimentar o eixo | Motor de passo | Servo motor | Motor DC
 |  | Converter para movimento linear | Polia-correia | Fuso trapezoidal | Fuso esferico | pinhão-cremalheira | Rodas de atrito
 |  | Método controle | Malha aberta | Malha fechada
 |  | Acoplamento | Rígidos | Elástico (flexíveis) | rígido (atrito)
 |  | Mancais | Radiais (mancal de apoio) | Axiais (mancal de escora) | Radial/Axial
 |  | Rolamento | Esferas | Roletes | Agulha

Sheet: matriz_pedro
 |  | Função/Solução | Métodos
 |  |  | 1 | 2 | 3 | 4 | 5 | 6 | 7
Receber Peça | A | Zeramento | Chave de fim-de-curso | Sensor indutivo | Sensor capacitivo | Sensor magnético
 | B | Referenciamento de posição | Sensor optico difuso | LVDT | Potenciometro | Encoder incremental | Encoder Absoluto | Ultrassönico | Via software
Verificar etiqueta | C | Identificar cor | RGB sensor
Verificar diâmetro | D | Identificar as dimensões do objeto | Resolver | Sensor IR | sensor ultrassônico | Medição pela garra
Mover garra posição PEGA/SOLTA | e | Movimentar o eixo Z | Motor de Passo | Servo motor | Motor DC
 | f | Movimentar a garra | Motor de Passo | Servo motor | Compressor | Motor DC
 | g | Converter para movimento linear | Polia-correia | Fuso esférico | Fuso trapezoidal | Pinhão-cremalheira | Rodas de atrito
 | h | Método controle | Malha aberta | Malha fechada
 | i | Acoplamento | Rígidos | Elástico (flexíveis) | Rígido (atrito)
 | j | Mancais | Radiais | Axiais | Radial/Axial
 | k | Rolamento | Esferas | Roletes | Agulha
Soltar/Pegar Peça | l | Segurar peça | Garra mecânica com hastes triangulares | Pinça mecânica | Ventosa de sucção | Garra pneumática
 |  |  |  |  |  |  |  |  |  | ___

Sheet: Fatiole's Matriz de soluções
 |  | Grupo | Data de criação: 19/03/2017
 |  |  | Data da versão: 21/03/2017
 |  |  | Versão: 1.0
 |  | 2R | Resumo: A partir da norma de segurança do trabalho NR-12, este documento destaca os requisitos mínimos que devem ser adotados para garantir a integridade física dos futuros operadores do dispositivo a ser confeccionado na disciplina de Projeto Mecatrônico.
 |  | Função/Solução | Métodos
 |  |  | 1 | 2 | 3 | 4 | 5 | 6 | 7 | Fonte | Preço Unitário(R$) | Quantidade
Receber Peça | A | Zeramento | Chave de fim-de-curso | Sensor indutivo | Sensor capacitivo | Sensor magnético | NÃO TEM |  |  | http://produto.mercadolivre.com.br/MLB-770981682-chave-fim-de-curso-alavanca-reg-c-roldana-me-8108-_JM | 3.25 | 3
 | B | Referenciamento de posição | Sensor optico difuso | LVDT | Potenciometro | Encoder incremental | Encoder Absoluto | Ultrassönico | Via software |  | - | -
Verificar etiqueta | C | Identificar cor | RGB sensor |  |  |  |  |  |  | http://www.baudaeletronica.com.br/sensor-de-cor-tcs3200-dfrobot.html | 20 | 1
Verificar diâmetro | D | Identificar as dimensões do objeto | Resolver | Sensor óptico difuso | sensor ultrassônico | Medição pela garra |  |  |  | http://produto.mercadolivre.com.br/MLB-770020828-sensor-fotoeletrico-optico-difuso-12-24vcc-na-nf-saida-rele-_JM | 355 | 1
Mover garra posição PEGA/SOLTA | e | Movimentar o eixo | Motor de Passo | Servo motor | Motor DC |  |  |  |  | https://www.submarino.com.br/produto/16504045/motor-de-passo-nema-23-12-kgf.cm-2-8a-action?WT.srch=1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 | 134.9 | 3
 | f | Movimentar a garra | Motor de Passo | Servo motor | Motor DC | NAO POSSUI |  |  |  | https://www.submarino.com.br/produto/12712353/micro-motor-dc-12v-18200rpm?WT.srch=1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 | 17.9 | 1
 | g | Converter para movimento linear | Polia-correia | Fuso trapezoidal | Fuso esférico | Pinhão-cremalheira | Rodas de atrito |  |  | http://produto.mercadolivre.com.br/MLB-803873139-fuso-trapezoidal-em-aco-macico-1045-tr20x1000mm-passo-4mm-_JM | 49.9
 | h | Método controle | Malha aberta | Malha fechada |  |  |  |  |  |  | -
 | i | Acoplamento | Rígidos | Elástico (flexíveis) | Rígido (atrito) |  |  |  |  | http://produto.mercadolivre.com.br/MLB-815111217-acoplamento-elastico-tipo-normex-e-67-consulte-outros-_JM | 45 | 1
 | j | Mancais | Radiais | Axiais | Radial/Axial |  |  |  |  | http://produto.mercadolivre.com.br/MLB-702799986-mancal-kp08-para-eixo-8mm-com-rolamento-automaco-cnc-3d-_JM | 18 | 1
 | k | Rolamento | Esferas | Roletes | Agulha |  |  |  |  | http://produto.mercadolivre.com.br/MLB-785935500-rolamento-de-esfera-6201-zz-1-pecas-promocao-_JM | 2.4 | 1
Soltar/Pegar Peça | l | Segurar peça | Garra Pneumática | Pinça mecânica | Ventosa de sucção | Garra mecânica com hastes triangulares |  |  |  | http://produto.mercadolivre.com.br/MLB-711373003-garra-robotica-em-aluminio-com-2-servos-mg995-arduino-_JM | 270 | 1
 | m | Abrir e fechar garra | Cremalheira | Fuso trapezoidal | Fuso esférico | NAO POSSUI |  |  |  | http://produto.mercadolivre.com.br/MLB-803873139-fuso-trapezoidal-em-aco-macico-1045-tr20x1000mm-passo-4mm-_JM | 129 | 1
 | n | Cuidados com a peça (sensores de força) | Sensor de corrente | Sensor com mola | Extensômetro | Sensor de corrente | Circuito Analógico | Via Software | NAO POSSUI |  | - | 0
 | o | Compressor de ar | PERGUNTAR PARA O FABIO QUAL COMPRESSOR O INSPER VAI DISPONIBILIZAR
 |  |  |  |  |  |  |  |  |  | SOMA | 1045.35
 |  |  |  |  |  |  |  |  |  |  |  |  |  |  | ___
V2 | a5 | b5 | c1 | d2 | e1 | f1 | g2 | h1 | i2 | j2 | k1 | l2 | m2 | n2

Sheet: Orcamento
Componentes | Fonte | Preço Unitário(R$) | Quantidade
Chave fim de curso | http://produto.mercadolivre.com.br/MLB-770981682-chave-fim-de-curso-alavanca-reg-c-roldana-me-8108-_JM | 3.25 | 3
Sensor RGB | http://www.baudaeletronica.com.br/sensor-de-cor-tcs3200-dfrobot.html | 20 | 1
Sensor Optico Difuso | http://produto.mercadolivre.com.br/MLB-770020828-sensor-fotoeletrico-optico-difuso-12-24vcc-na-nf-saida-rele-_JM | 355 | 1
Motor de Passo | https://www.submarino.com.br/produto/16504045/motor-de-passo-nema-23-12-kgf.cm-2-8a-action?WT.srch=1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 | 134.9 | 3
Motor DC | https://www.submarino.com.br/produto/12712353/micro-motor-dc-12v-18200rpm?WT.srch=1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 | 17.9 | 1
Fuso Trapezoidal | http://produto.mercadolivre.com.br/MLB-803873139-fuso-trapezoidal-em-aco-macico-1045-tr20x1000mm-passo-4mm-_JM | 49.9
Acoplmemnto elastico | http://produto.mercadolivre.com.br/MLB-815111217-acoplamento-elastico-tipo-normex-e-67-consulte-outros-_JM | 45 | 1
Mancal Axial | http://produto.mercadolivre.com.br/MLB-702799986-mancal-kp08-para-eixo-8mm-com-rolamento-automaco-cnc-3d-_JM | 18 | 1
Rolamento Esferico | http://produto.mercadolivre.com.br/MLB-785935500-rolamento-de-esfera-6201-zz-1-pecas-promocao-_JM | 2.4 | 1
Garra pneumatica(o compressor sera dado pelo insper) | http://produto.mercadolivre.com.br/MLB-711373003-garra-robotica-em-aluminio-com-2-servos-mg995-arduino-_JM | 270 | 1
Fuso trapezoidal | http://produto.mercadolivre.com.br/MLB-803873139-fuso-trapezoidal-em-aco-macico-1045-tr20x1000mm-passo-4mm-_JM | 129 | 1
 | SOMA | 1045.35

Sheet: Cópia de Orcamento
Componentes | Fonte | Preço Unitário(R$) | Quantidade
Chave fim de curso | http://produto.mercadolivre.com.br/MLB-770981682-chave-fim-de-curso-alavanca-reg-c-roldana-me-8108-_JM | 3.25 | 3
Sensor RGB | http://www.baudaeletronica.com.br/sensor-de-cor-tcs3200-dfrobot.html | 20 | 1
Sensor Optico Difuso | http://produto.mercadolivre.com.br/MLB-770020828-sensor-fotoeletrico-optico-difuso-12-24vcc-na-nf-saida-rele-_JM | 355 | 1
Motor de Passo | https://www.submarino.com.br/produto/16504045/motor-de-passo-nema-23-12-kgf.cm-2-8a-action?WT.srch=1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 | 134.9 | 3
Motor DC | https://www.submarino.com.br/produto/12712353/micro-motor-dc-12v-18200rpm?WT.srch=1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 | 17.9 | 1
Fuso Trapezoidal | http://produto.mercadolivre.com.br/MLB-803873139-fuso-trapezoidal-em-aco-macico-1045-tr20x1000mm-passo-4mm-_JM | 49.9
Acoplmemnto elastico | http://produto.mercadolivre.com.br/MLB-815111217-acoplamento-elastico-tipo-normex-e-67-consulte-outros-_JM | 45 | 1
Mancal Axial | http://produto.mercadolivre.com.br/MLB-702799986-mancal-kp08-para-eixo-8mm-com-rolamento-automaco-cnc-3d-_JM | 18 | 1
Rolamento Esferico | http://produto.mercadolivre.com.br/MLB-785935500-rolamento-de-esfera-6201-zz-1-pecas-promocao-_JM | 2.4 | 1
Garra pneumatica(o compressor sera dado pelo insper) | http://produto.mercadolivre.com.br/MLB-711373003-garra-robotica-em-aluminio-com-2-servos-mg995-arduino-_JM | 270 | 1
Fuso trapezoidal | http://produto.mercadolivre.com.br/MLB-803873139-fuso-trapezoidal-em-aco-macico-1045-tr20x1000mm-passo-4mm-_JM | 129 | 1
 | SOMA | 1045.35
