pepocasella/Projeto-Mecatronico/Mecânica/Orçamentos/COTAÇÃO GABRIEL 04.05.2017(12).xlsx

 |  |  | C
 |  |  | Comércio e Acessórios Industriais Ltda.
 |  | FUSOS E
 |  | GUIAS
Cliente: |  | GABRIEL
Telefone: |  | 99676-7933
Contato: |  | GABRIEL |  | Data | 04.05.2017
Proposta: |  | COTAÇÃO 04/2017
ITEM | QUANT | DESCRIÇÃO |  | UNITARIO R$ | TOTAL R$ | IPI
1 | 1 | Conjunto fuso de esferas R16-5-300-300-0,05+ |  | 600.00 | 600.00 | 0%
2 |  | Castanha R16-5T3-FSI - Sem usinagem |  |  | 0.00 | 0%
3 | 4 | Guia linear Bloco HGW15 CC com aba |  | 170.00 | 680.00 | 0%
4 | 2 | Guia linear Trilho HGH15CA |  |  |  | 0%
5 |  |  |  |  | 0.00 | 0%
6 | 1 | Mancal BK12 |  | 200.00 | 200.00 | 0% | vendasp@mectrol.com.br
7 | 1 | Mancal BF12 |  | 500.00 | 500.00 | 0%
8 |  |  |  |  | 0.00 | 0%
9 |  |  |  |  | 0.00 | 0%
10 |  |  |  |  | 0.00 | 0%
11 |  |  |  |  | 0.00 | 0%
12 |  | IPI 0% |  |  | 0.00 | 0%
13 |  | Condição de pagamento 28 DD |  |  | 0.00 | 0%
14 |  | Prazo de entrega: Imediato |  |  | 0.00 | 0%
15 |  |  |  |  | 0.00 | 0%
16 |  |  |  |  | 0.00 | 0%
17 |  |  |  |  | 0.00 | 0%
18 |  |  |  |  | 0.00 | 0%
19 |  |  |  |  | 0.00 | 0%
20 |  |  |  |  | 0.00 | 0%
 |  |  | TOTAL |  | R$1980.00
ESTOQUE SUJEITO A CONFIRMAÇÃO
COND. PGTO: |  |  | FRETE:
ENTREGA: |  |  | TRANP:
Minimo para faturamento R$200,00 |  |  | PREÇOS LÍQUIDOS
Atenciosamente,
Henrique Azevedo - Depto Comercial
Pabx: (11) 3429-0600
Direto: (11) 3429-0602
Email: henrique@tinkroll.com.br
Skype: henriqueazevedoo
Visite nosso site: www.tinkroll.com.br
CNPJ: 65.074.932/0001-24 - IE: 113.012.059.112
