pepocasella/Projeto-Mecatronico/Mecânica/CADs/BF12/BF12/BF12.SLDASM

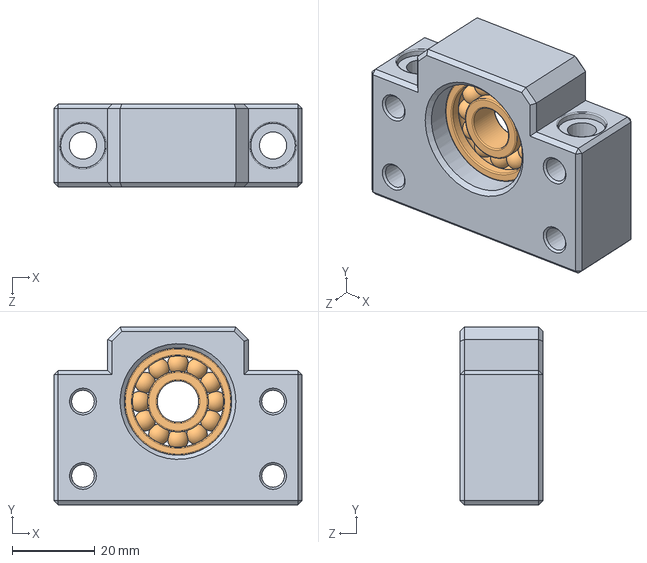
[picture p110: CAD file, 2019-07-07]
Mecânica/CADs/BF12/BF12/BF12.SLDASM
60.0 x 43.0 x 20.0 mm
BF12-1
6000-Bearing
