pepocasella/Projeto-Mecatronico/Elétrica/Sensor de Distância/Suporte Sensor TCRT.stl

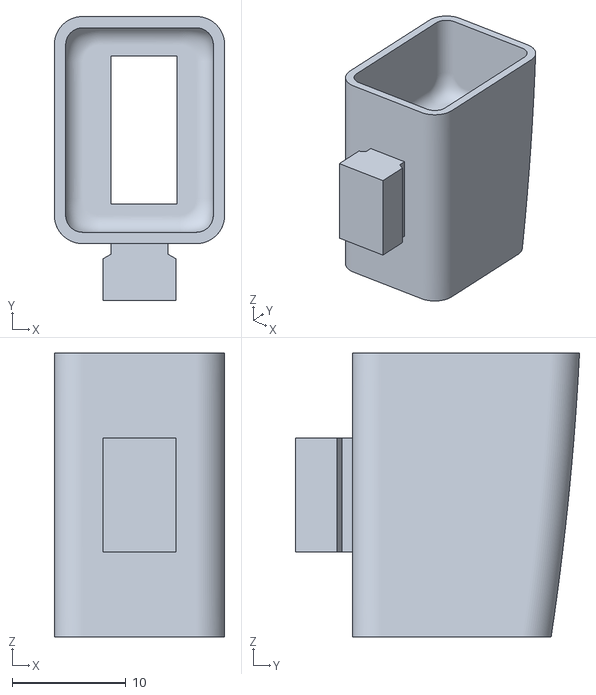
[picture p111: CAD file, 2019-07-07]
Elétrica/Sensor de Distância/Suporte Sensor TCRT.stl
15.0 x 25.0 x 25.0
