pepocasella/Projeto-Mecatronico/Mecânica/CADs/base2.stl

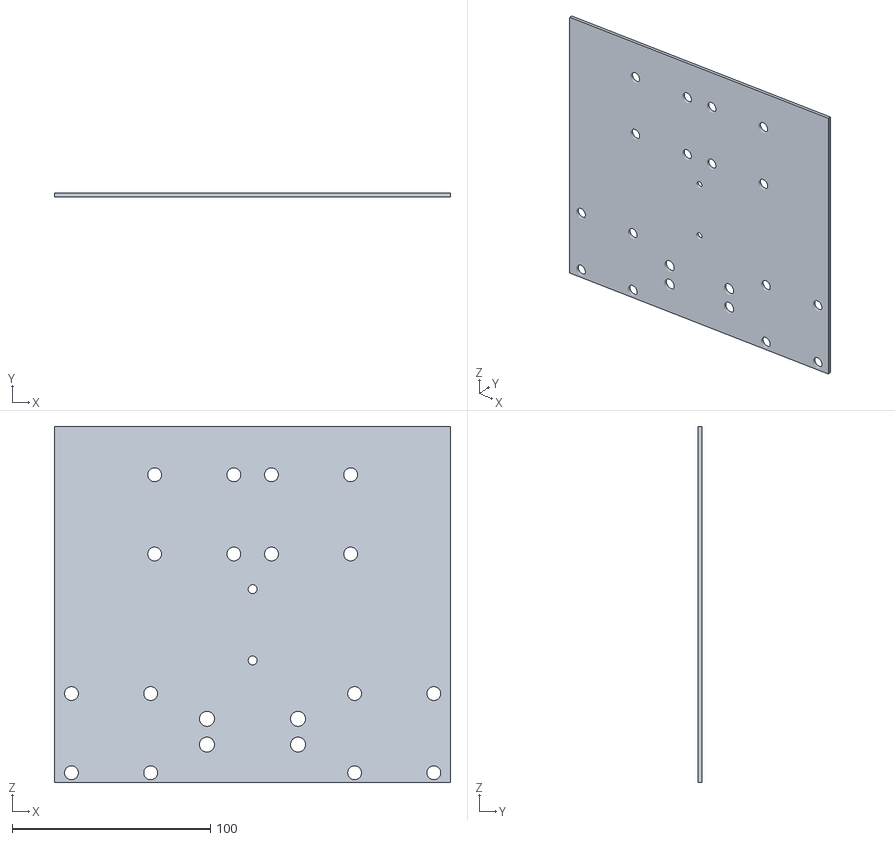
[picture p112: CAD file, 2019-07-07]
Mecânica/CADs/base2.stl
200.0 x 2.00 x 180.0
