pepocasella/Projeto-Mecatronico/Mecânica/CADs/BF12/BF12/6000 Bearing/6000-Bearing.SLDPRT

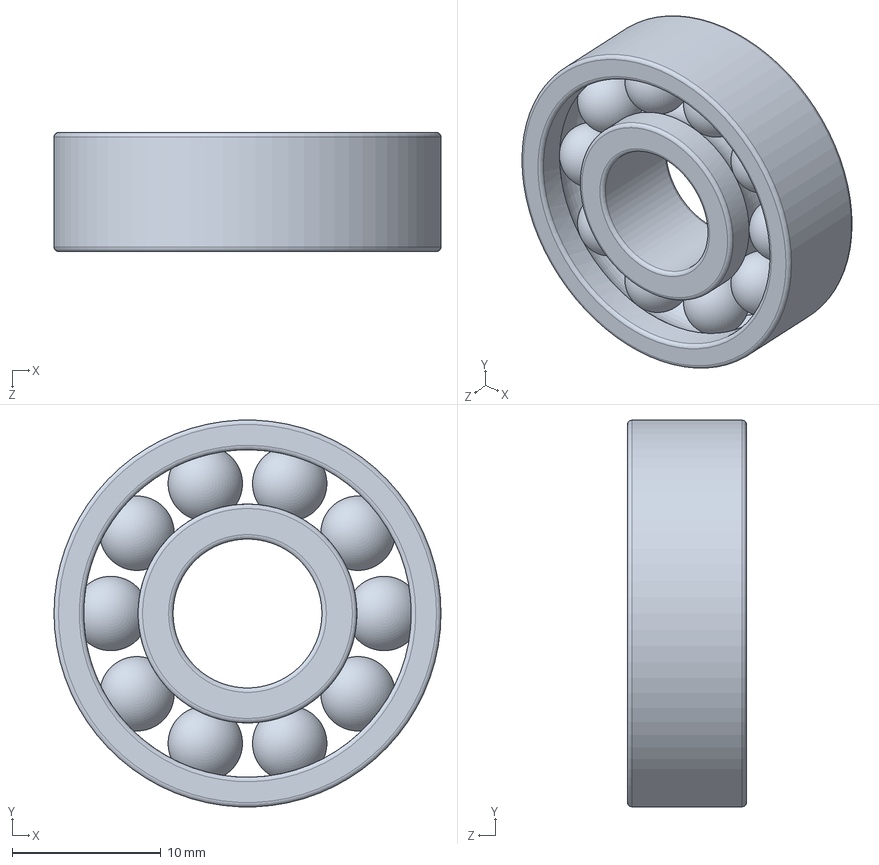
[picture p113: CAD file, 2019-07-07]
Mecânica/CADs/BF12/BF12/6000 Bearing/6000-Bearing.SLDPRT
26.0 x 26.0 x 8.00 mm
