pepocasella/Projeto-Mecatronico/Mecânica/CADs/BF12/BF12/parts/BF12-1.SLDPRT

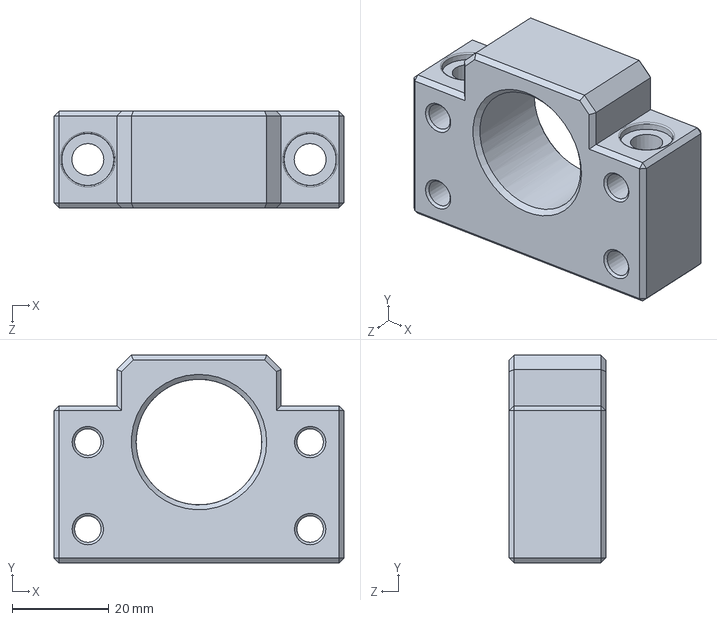
[picture p114: CAD file, 2019-07-07]
Mecânica/CADs/BF12/BF12/parts/BF12-1.SLDPRT
60.0 x 43.0 x 20.0 mm
