pepocasella/Projeto-Mecatronico/Mecânica/CADs/BK12/BF12.SLDPRT

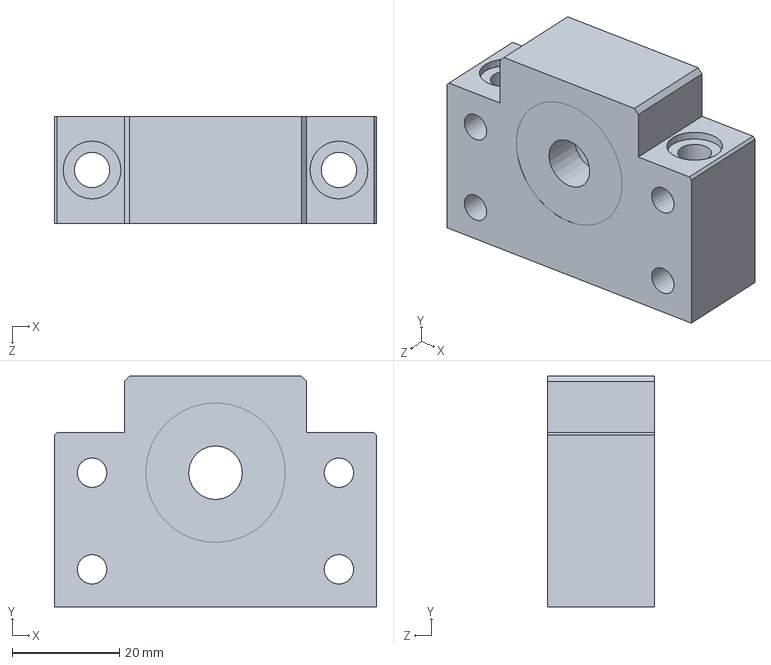
[picture p115: CAD file, 2019-07-07]
Mecânica/CADs/BK12/BF12.SLDPRT
60.0 x 43.0 x 20.0 mm
