pepocasella/Projeto-Mecatronico/Mecânica/CADs/R16-5T3-FSI/HIWIN Corporation-R16-5T3-FSI.SLDPRT

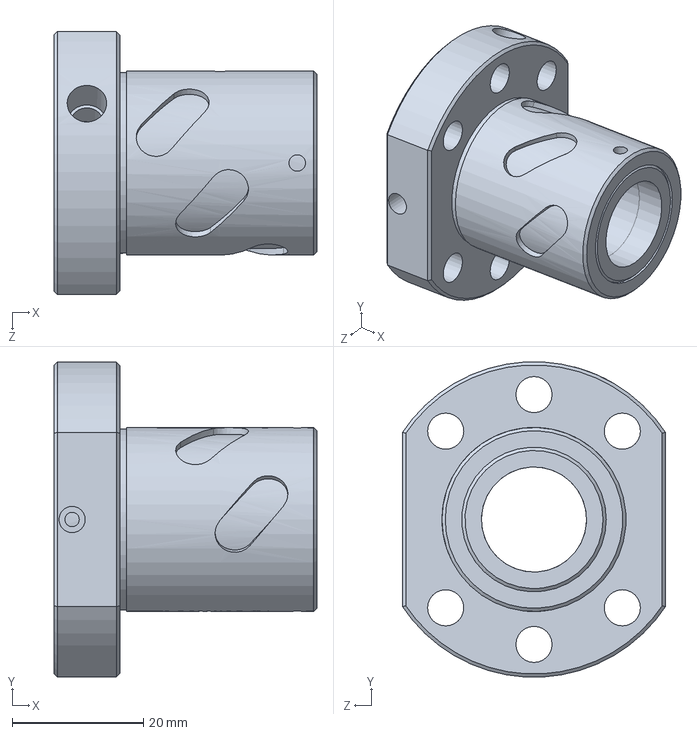
[picture p116: CAD file, 2019-07-07]
Mecânica/CADs/R16-5T3-FSI/HIWIN Corporation-R16-5T3-FSI.SLDPRT
40.0 x 47.9 x 40.0 mm
