pepocasella/Projeto-Mecatronico/Mecânica/CADs/Suporte Castanha/Bracket DSG50H.STEP

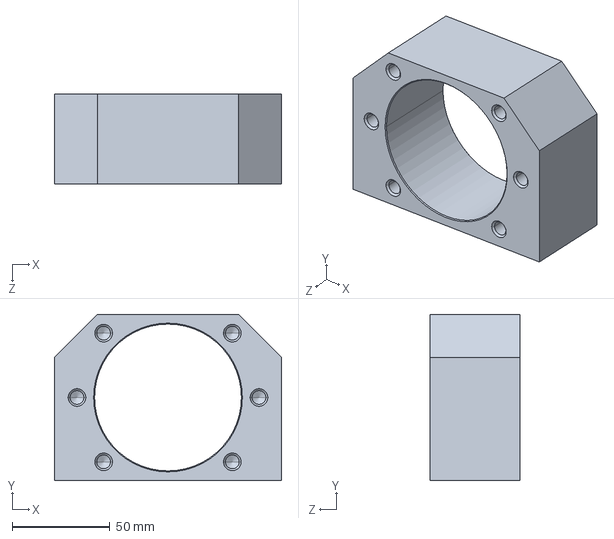
[picture p117: CAD file, 2019-07-07]
Mecânica/CADs/Suporte Castanha/Bracket DSG50H.STEP
116.0 x 85.0 x 46.0 mm
