pepocasella/Projeto-Mecatronico/Elétrica/Sensor de Distância/Haste esq.stl

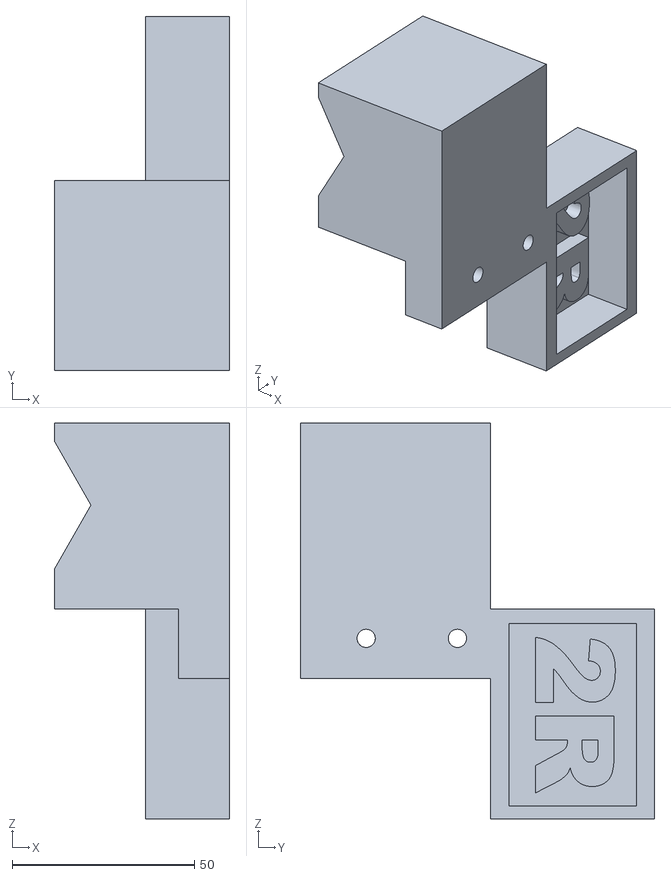
[picture p118: CAD file, 2019-07-07]
Elétrica/Sensor de Distância/Haste esq.stl
48.0 x 97.0 x 108.5
