pepocasella/Projeto-Mecatronico/Mecânica/CADs/Base.stl

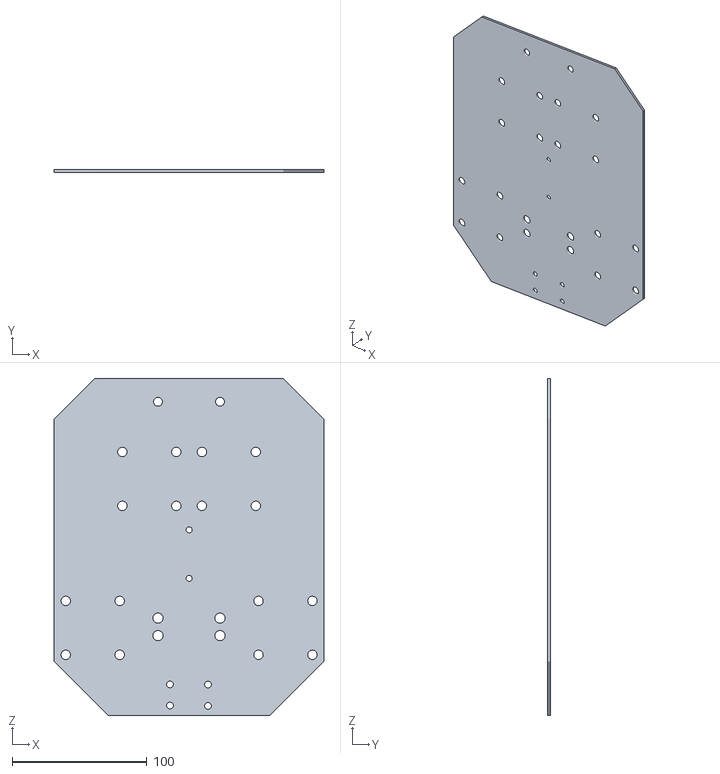
[picture p119: CAD file, 2019-07-07]
Mecânica/CADs/Base.stl
200.0 x 2.00 x 250.0
