pepocasella/Projeto-Mecatronico/Mecânica/CADs/BK12/BK12.SLDPRT

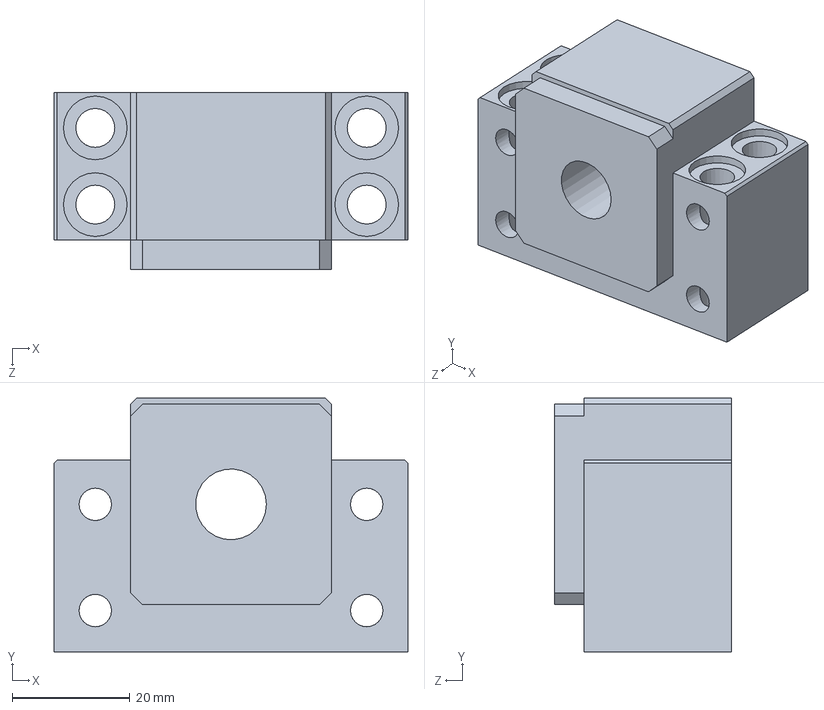
[picture p120: CAD file, 2019-07-07]
Mecânica/CADs/BK12/BK12.SLDPRT
60.0 x 43.0 x 30.0 mm
