pepocasella/Projeto-Mecatronico/Mecânica/CADs/Suporte Castanha/Bracket DSG2020.STEP

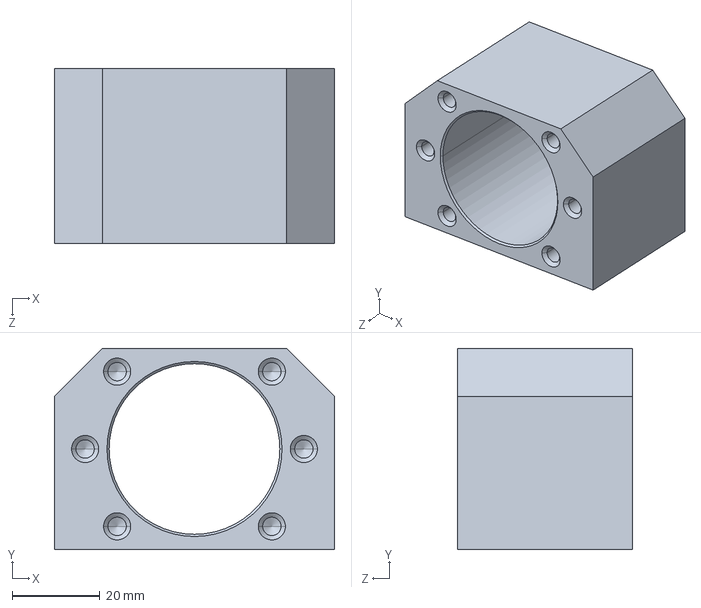
[picture p121: CAD file, 2019-07-07]
Mecânica/CADs/Suporte Castanha/Bracket DSG2020.STEP
64.0 x 46.0 x 40.0 mm
