pepocasella/Projeto-Mecatronico/Mecânica/CADs/Suporte Castanha/Bracket DSG2525.STEP

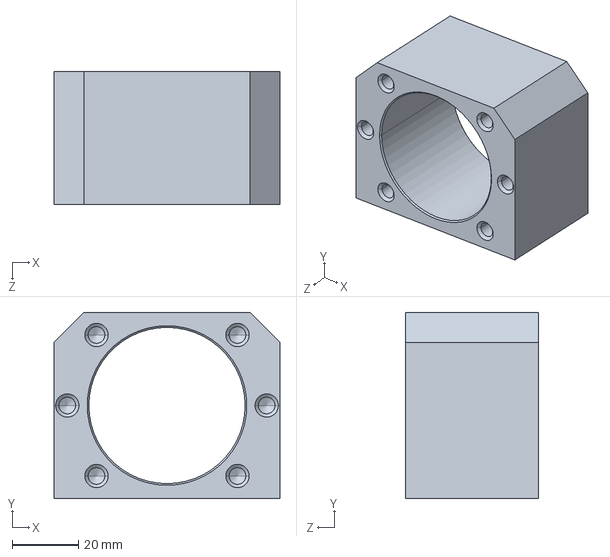
[picture p122: CAD file, 2019-07-07]
Mecânica/CADs/Suporte Castanha/Bracket DSG2525.STEP
68.0 x 56.0 x 40.0 mm
