pepocasella/Projeto-Mecatronico/Elétrica/Sensor de Distância/suporte_motor_passo.stl

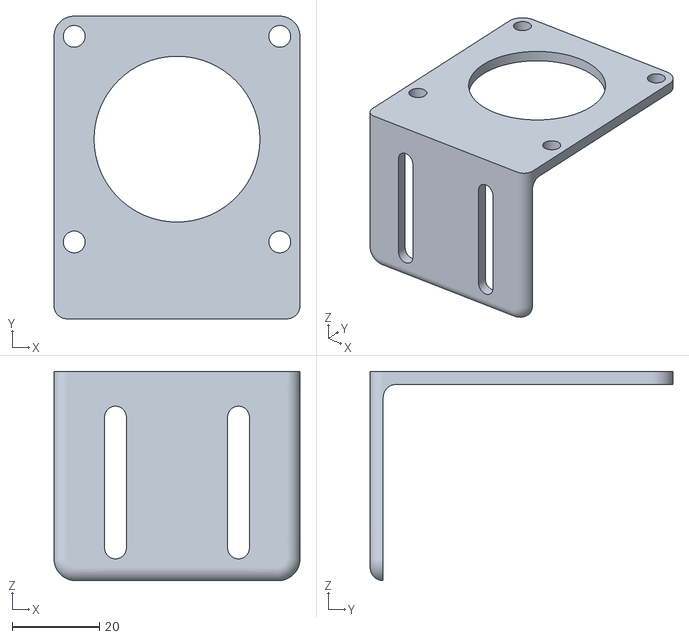
[picture p123: CAD file, 2019-07-07]
Elétrica/Sensor de Distância/suporte_motor_passo.stl
56.4 x 69.4 x 48.0
