pepocasella/Projeto-Mecatronico/Mecânica/CADs/Suporte Castanha/Bracket DSG20H.STEP

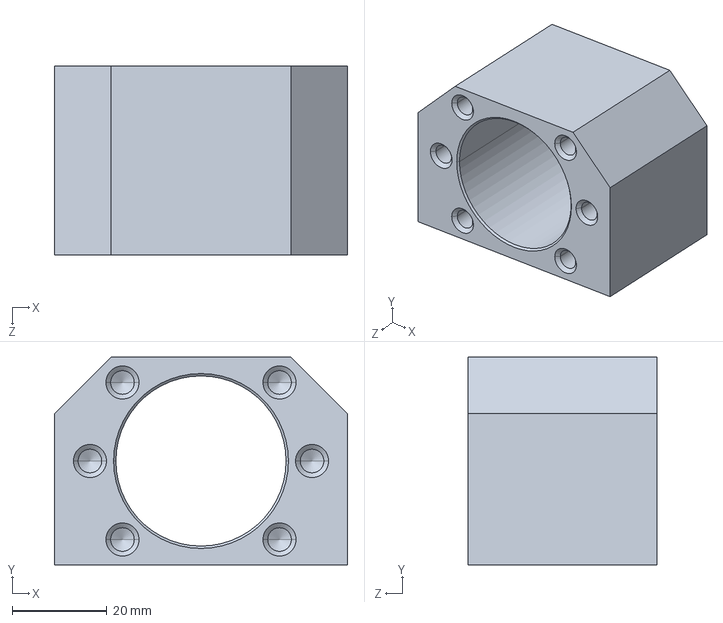
[picture p124: CAD file, 2019-07-07]
Mecânica/CADs/Suporte Castanha/Bracket DSG20H.STEP
62.0 x 44.0 x 40.0 mm
