pepocasella/Projeto-Mecatronico/Mecânica/CADs/Suporte Castanha/Bracket DSG16H.STEP

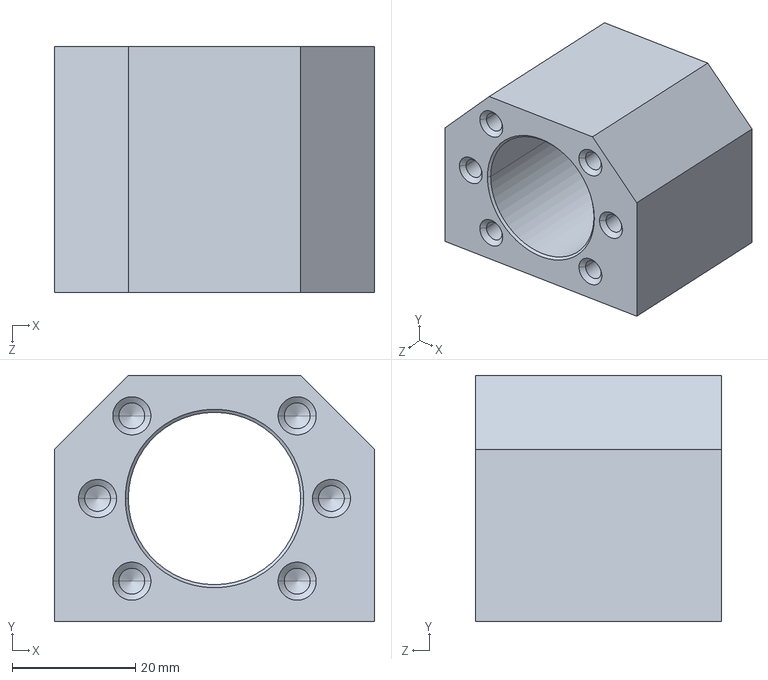
[picture p125: CAD file, 2019-07-07]
Mecânica/CADs/Suporte Castanha/Bracket DSG16H.STEP
52.0 x 40.0 x 40.0 mm
