pepocasella/Projeto-Mecatronico/Mecânica/CADs/Suporte Castanha/Bracket DSG25H.STEP

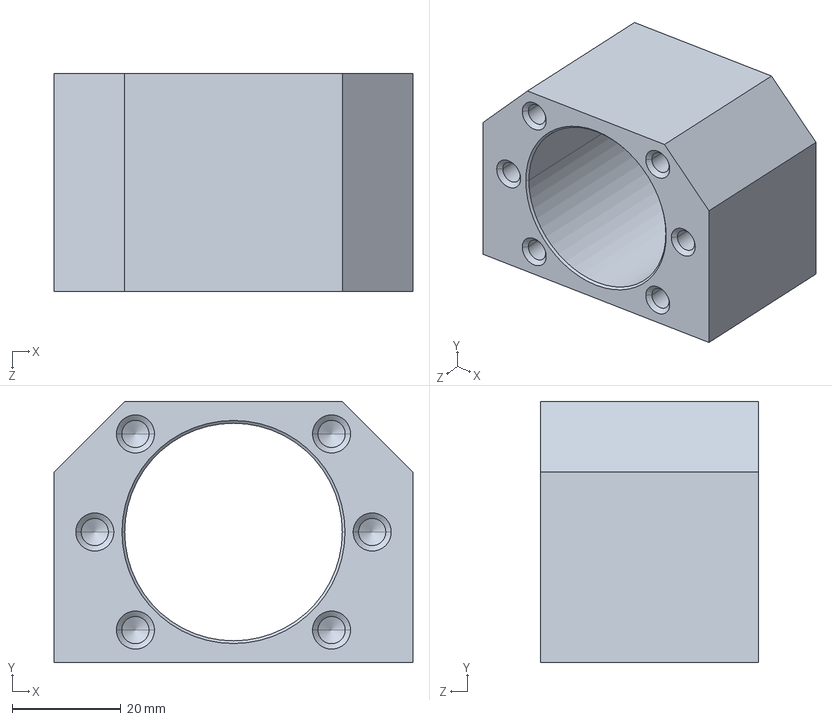
[picture p126: CAD file, 2019-07-07]
Mecânica/CADs/Suporte Castanha/Bracket DSG25H.STEP
66.0 x 48.0 x 40.0 mm
