pepocasella/Projeto-Mecatronico/Mecânica/CADs/Suporte Castanha/Bracket DSG1616.STEP

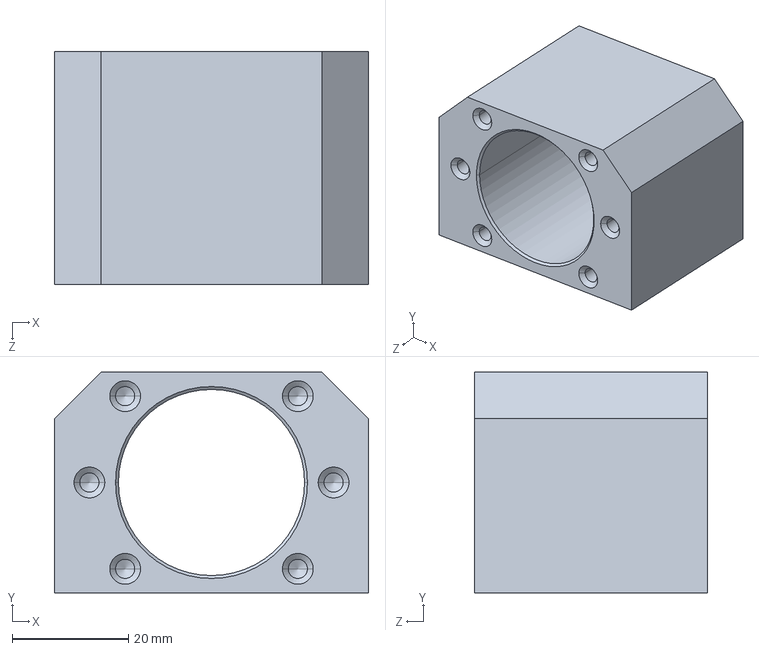
[picture p127: CAD file, 2019-07-07]
Mecânica/CADs/Suporte Castanha/Bracket DSG1616.STEP
54.0 x 38.0 x 40.0 mm
