pepocasella/Projeto-Mecatronico/Mecânica/CADs/Suporte Castanha/Bracket DSG32H.STEP

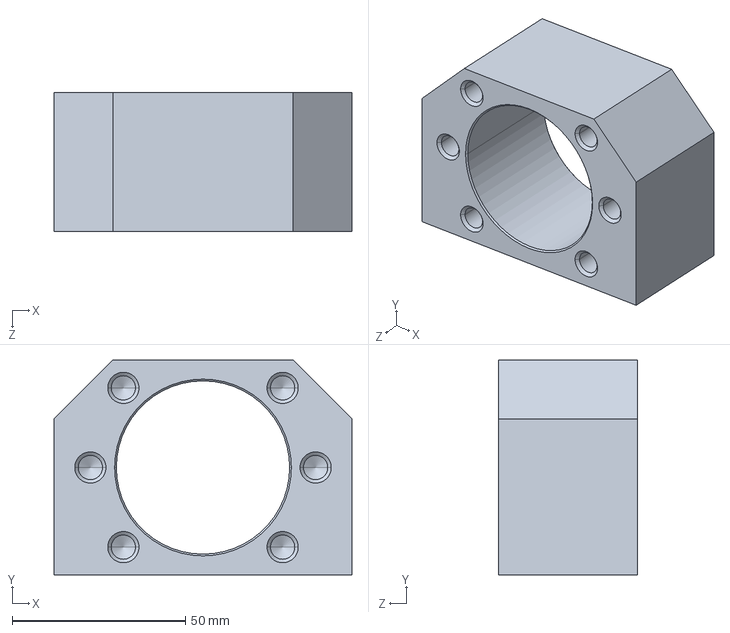
[picture p128: CAD file, 2019-07-07]
Mecânica/CADs/Suporte Castanha/Bracket DSG32H.STEP
86.0 x 62.0 x 40.0 mm
