pepocasella/Projeto-Mecatronico/Mecânica/CADs/Suporte Castanha/Bracket DSG40H.STEP

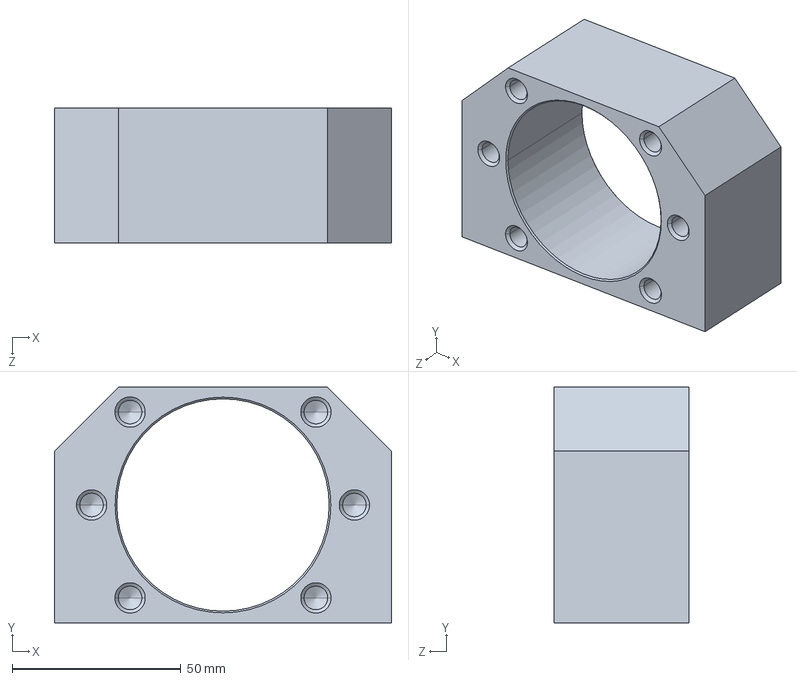
[picture p129: CAD file, 2019-07-07]
Mecânica/CADs/Suporte Castanha/Bracket DSG40H.STEP
100.0 x 70.0 x 40.0 mm
