pepocasella/Projeto-Mecatronico/(list of files, cad)

Other CAD files:
Mecânica/CADs/R16-5T3-FSI/HIWIN Corporation-R16-5T3-FSI-DEFAULT.IGS
Elétrica/Sensor de Distância/Haste dir.stl
