pepocasella/Projeto-Mecatronico/Gates/GATE 2/FOTOS/Full Assembly.PNG

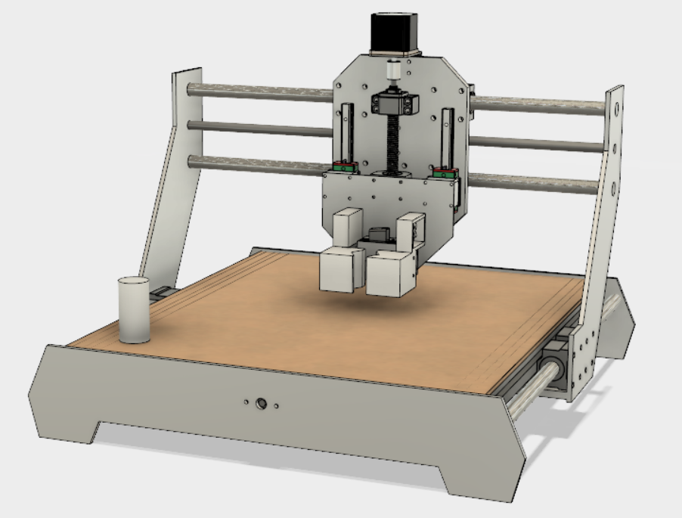
Gates/GATE 2/FOTOS/Full Assembly.PNG
