pepocasella/Projeto-Mecatronico/Elétrica/Sensor de Distância/impressão_calibracao.pptx

## Calibração Sensor de Distância

Sensor Óptico Reflexivo TCRT5000

## Slide 2

Dados de para o levantamento da curva de resposta do sensor óptico reflexivo

Faixa de % do bit com grande variação

Faixa boa
de atuação

## Slide 3

Tabela de dados da resposta do sensor para cada mílimitro (15mm – 30mm)

## Slide 4

Região Linear da resposta do sensor

Faixa Calibrada
(Span/Range calibrado)

## Slide 5

Ajuste da curva do sensor (Método dos Mínimos Quadrados)

y(x)= a0 + a1x
