pepocasella/Projeto-Mecatronico/Elétrica/Sensor de Distância/curva_calibracao_TCRT5000_final (Salvo automaticamente).xlsx

Sheet: método crazy
Distancia | Max | Min | Média | pop stdev: | unbias stdev:
40.00 | 970.18 | 970.78 | 970.4426 | 0.1309 | 0.1331
45.00 | 982.86 | 982.38 | 982.5599 | 0.1203 | 0.1234
50.00 | 990.86 | 990.36 | 990.646 | 0.1144 | 0.1174
55.00 | 995.96 | 995.5 | 995.7451 | 0.1122 | 0.1151
60.00 | 998.36 | 988.68 | 998.5241 | 0.0939 | 0.0964
65.00 | 1002.06 | 1001.56 | 1001.813 | 0.1336 | 0.1371
70.00 | 1003.46 | 1003.08 | 1003.243 | 0.1184 | 0.1214
75.00 | 1005.22 | 1004.82 | 1004.9771 | 0.1284 | 0.1318
80.00 | 1006.68 | 1006.14 | 1006.3692 | 0.1273 | 0.1206
85.00 | 1007.74 | 1007.26 | 1007.4749 | 0.1288 | 0.1321
90.00 | 1008.74 | 100824 | 1008.52 | 0.1186 | 0.1216
 | Função 1 | Delta 1 | Função 2 | Delta 2 | Função 3 | Delta 3 | Função 4 | Delta 4 | bits | mm
40.00 | 984.4 | 13.9574 | 972.416 | 1.9734 | 971.618 | 1.1754 | 972.7 | 2.2574 | 12.68
45.00 | 1004.37375 | 21.81385 | 984.72225 | 2.16235 | 983.890625 | 1.330725 | 985.838375 | 3.278475 | 8
50.00 | 1023.38 | 32.734 | 993.636 | 2.99 | 992.152 | 1.506 | 995.233 | 4.587 | 5.1
55.00 | 1043.29375 | 47.54865 | 1000.13225 | 4.38715 | 997.564625 | 1.819525 | 1001.971375 | 6.226275 | 998.36
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
