pepocasella/Projeto-Mecatronico/Elétrica/Sensor de Distância/excel_calibração_final.xlsx

Sheet: Plan1
 |  |  |  |  |  |  |  |  |  |  |  |  |  |  |  |  |  |  | 0.749939 | 0.749939 |  | 0.744567 | 0.753846 | 0.753114
 |  |  |  |  |  |  |  |  |  |  |  |  |  |  |  |  |  |  | 1.499145 | 0.749206 |  | 0.741392 | 0.753114 | 0.751648
 |  |  |  |  |  |  |  |  |  |  |  |  |  |  |  |  |  |  | 2.247863 | 0.748718 |  | 0.739194 | 0.75409 | 0.749206
mm | 0 | 1 | 15 | 20 | 25 | 30 | 35 | 40 | 45 | 50 | 55 | 60 | 65 | 70 | 75 | 80 |  |  | 2.998046 | 0.750183 |  | 0.739927 | 0.754335 | 0.751404
 | 0.132357 | 0.1733 | 0.457631 | 0.62906 | 0.723565 | 0.78486 | 0.823932 | 0.853724 | 0.871795 | 0.887912 | 0.897924 | 0.90696 | 0.913797 | 0.918437 | 0.922589 | 0.926007 |  |  | 3.748230 | 0.750184 |  | 0.740904 | 0.752625 | 0.749206
 | 0.135775 | 0.173871 | 0.457875 | 0.628083 | 0.725275 | 0.783639 | 0.823932 | 0.852259 | 0.872039 | 0.886935 | 0.898169 | 0.90696 | 0.913797 | 0.918193 | 0.923565 | 0.926007 |  |  | 4.496703 | 0.748473 |  | 0.738462 | 0.752137 | 0.750672
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
