pepocasella/Projeto-Mecatronico/Mecânica/Desenhos Técnicos/Supp Motor de passo Drawing v2.pdf

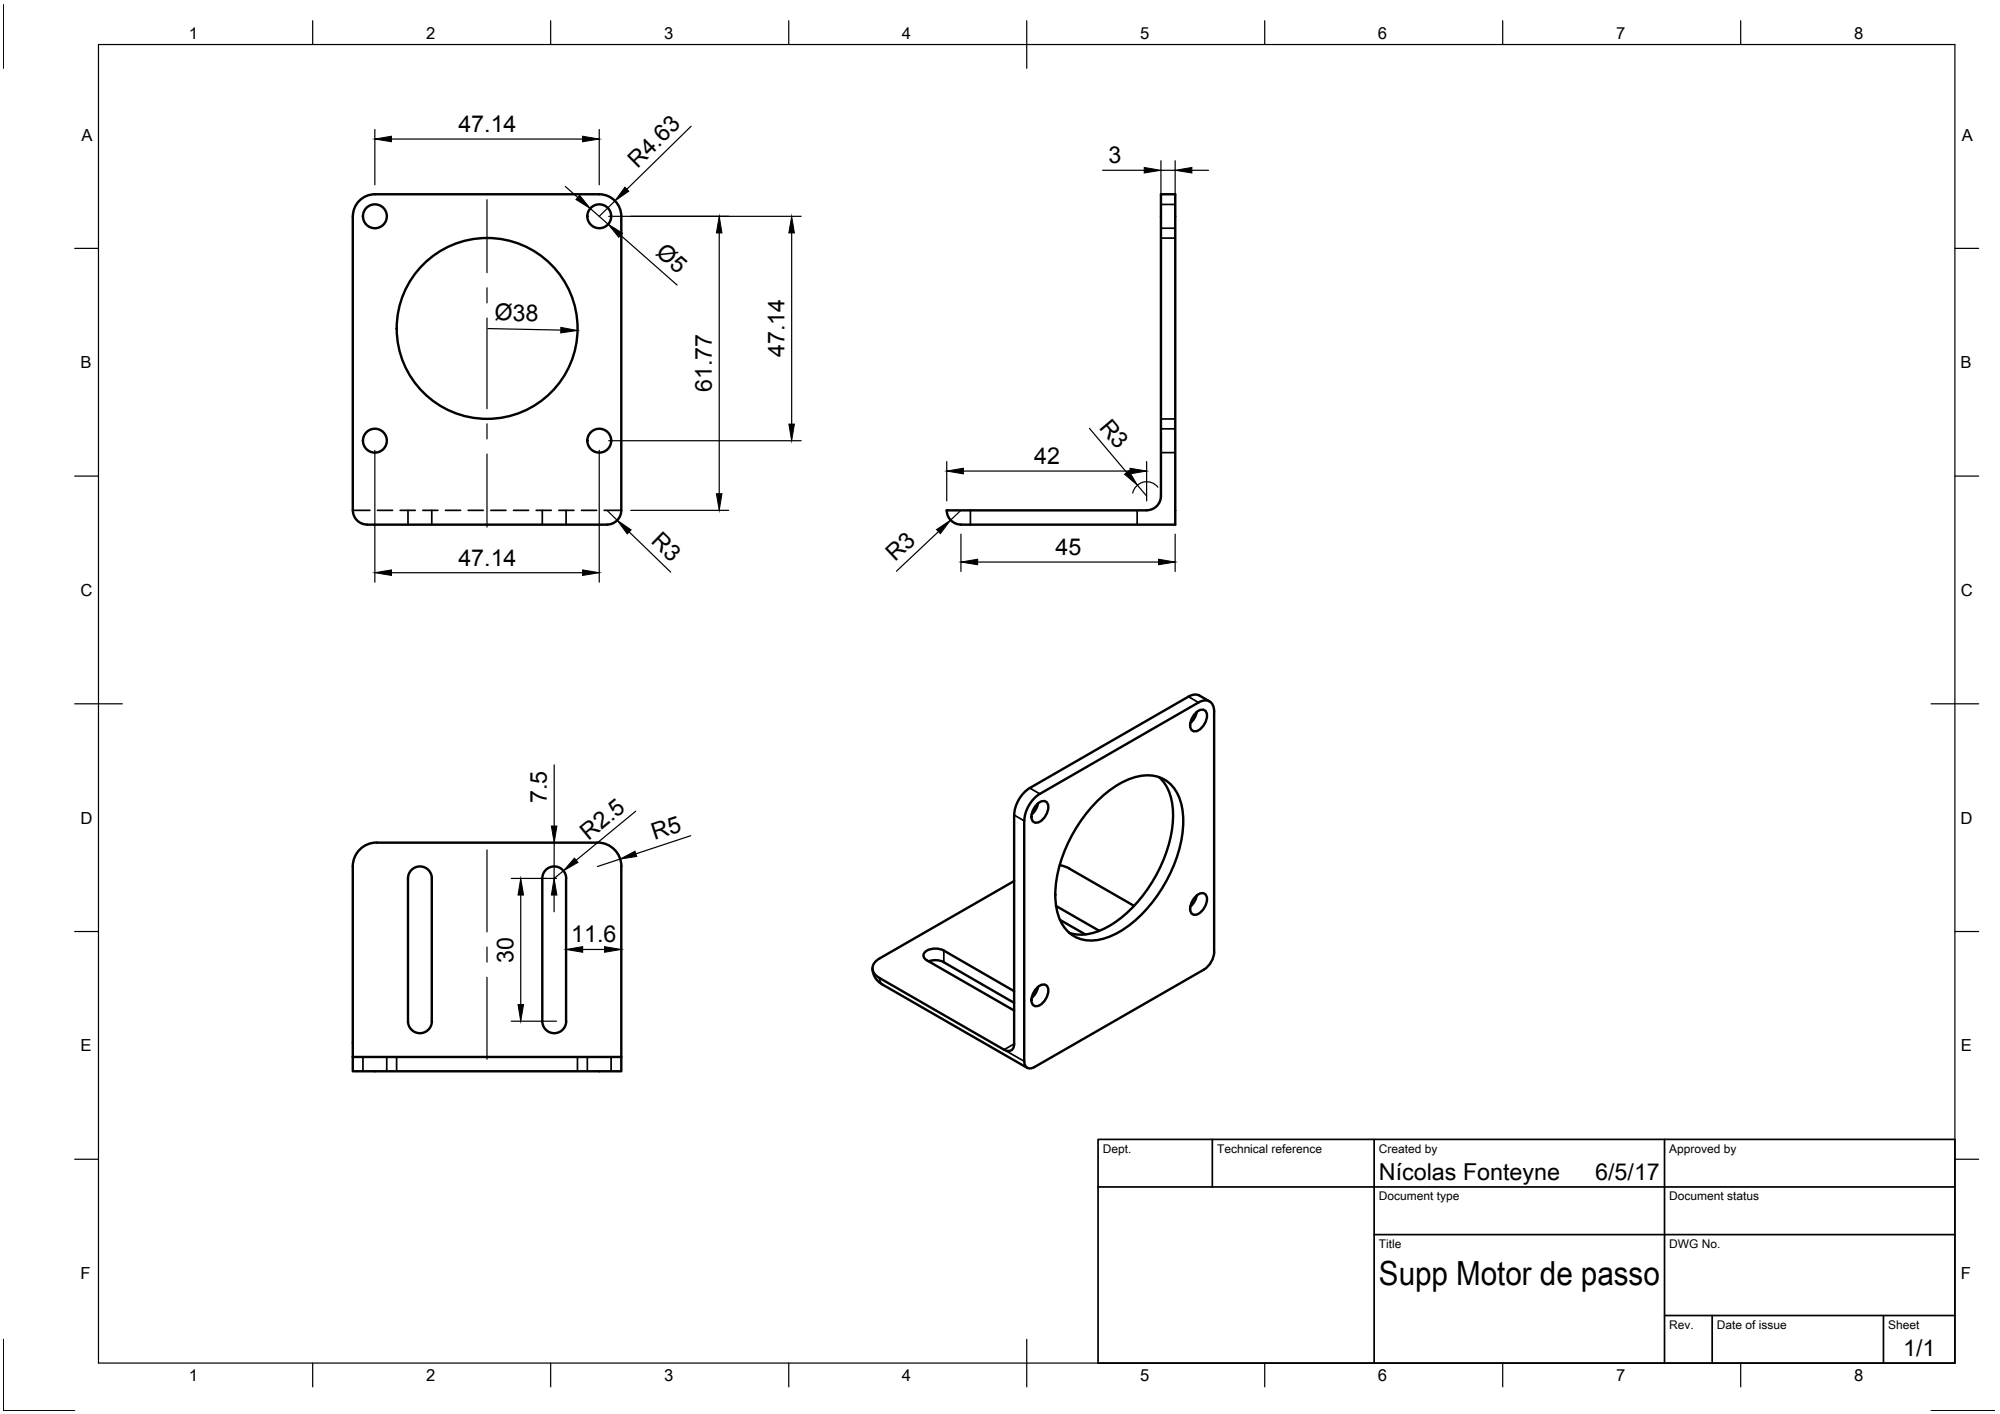
[picture p131: page 1]

Dept. | Technical reference | Created by Nícolas Fonteyne 6/5/17 | Approved by

Document type | Document status

Title Supp Motor de passo | DWG No.

Rev. | Date of issue | Sheet 1/1
