pepocasella/Projeto-Mecatronico/Gates/GATE 2/Cronograma Final.pdf

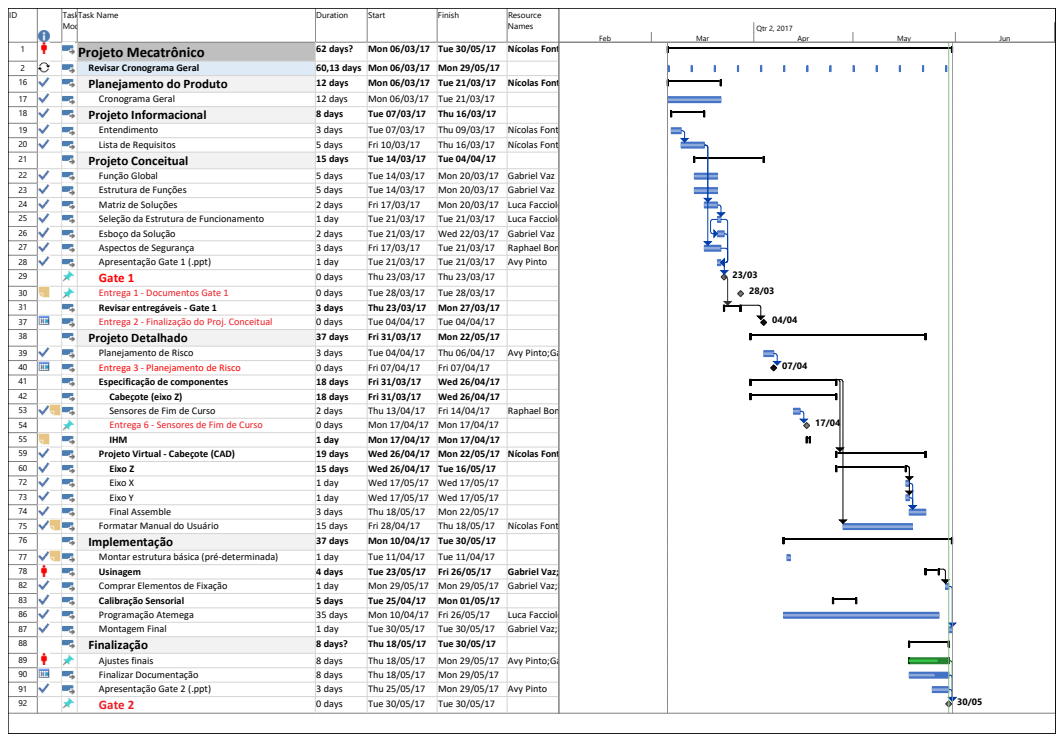
[picture p132: page 1]
Task; Mode; Task Name; Duration; Start; Finish; Resource; Names; Projeto Mecatrônico; 62 days?; Mon 06/03/17; Tue 30/05/17; Nícolas Fonteyne;Avy Pinto;Gabriel Vaz;Luca Facciolo;Pedro Casella;Raphael Bomeisel;Rodolpho Benini; Entendimento; 3 days; Tue 07/03/17; Thu 09/03/17; Nícolas Fonteyne;Pedro Casella;Avy Pinto;Gabriel Vaz;Luca Facciolo;Raphael Bomeisel;Rodolpho Benini; Matriz de Soluções; 2 days; Fri 17/03/17; Mon 20/03/17; Luca Facciolo;Pedro Casella;Rodolpho Benini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

2 | Revisar Cronograma Geral | 60,13 days | Mon 06/03/17 | Mon 29/05/17
16 | Planejamento do Produto | 12 days | Mon 06/03/17 | Tue 21/03/17 | Nícolas Fonteyne
17 | Cronograma Geral | 12 days | Mon 06/03/17 | Tue 21/03/17
18 | Projeto Informacional | 8 days | Tue 07/03/17 | Thu 16/03/17

20 | Lista de Requisitos | 5 days | Fri 10/03/17 | Thu 16/03/17 | Nícolas Fonteyne
21 | Projeto Conceitual | 15 days | Tue 14/03/17 | Tue 04/04/17
22 | Função Global | 5 days | Tue 14/03/17 | Mon 20/03/17 | Gabriel Vaz
23 | Estrutura de Funções | 5 days | Tue 14/03/17 | Mon 20/03/17 | Gabriel Vaz

26 | Esboço da Solução | 2 days | Tue 21/03/17 | Wed 22/03/17 | Gabriel Vaz
27 | Aspectos de Segurança | 3 days | Fri 17/03/17 | Tue 21/03/17 | Raphael Bomeisel
28 | Apresentação Gate 1 (.ppt) | 1 day | Tue 21/03/17 | Tue 21/03/17 | Avy Pinto
29 | Gate 1 | 0 days | Thu 23/03/17 | Thu 23/03/17
30 | Entrega 1 - Documentos Gate 1 | 0 days | Tue 28/03/17 | Tue 28/03/17
31 | Revisar entregáveis - Gate 1 | 3 days | Thu 23/03/17 | Mon 27/03/17
37 | Entrega 2 - Finalização do Proj. Conceitual | 0 days | Tue 04/04/17 | Tue 04/04/17
38 | Projeto Detalhado | 37 days | Fri 31/03/17 | Mon 22/05/17
39 | Planejamento de Risco | 3 days | Tue 04/04/17 | Thu 06/04/17 | Avy Pinto;Gabriel Vaz
40 | Entrega 3 - Planejamento de Risco | 0 days | Fri 07/04/17 | Fri 07/04/17
41 | Especificação de componentes | 18 days | Fri 31/03/17 | Wed 26/04/17
42 | Cabeçote (eixo Z) | 18 days | Fri 31/03/17 | Wed 26/04/17
53 | Sensores de Fim de Curso | 2 days | Thu 13/04/17 | Fri 14/04/17 | Raphael Bomeisel
54 | Entrega 6 - Sensores de Fim de Curso | 0 days | Mon 17/04/17 | Mon 17/04/17
55 | IHM | 1 day | Mon 17/04/17 | Mon 17/04/17

60 | Eixo Z | 15 days | Wed 26/04/17 | Tue 16/05/17
72 | Eixo X | 1 day | Wed 17/05/17 | Wed 17/05/17
73 | Eixo Y | 1 day | Wed 17/05/17 | Wed 17/05/17
74 | Final Assemble | 3 days | Thu 18/05/17 | Mon 22/05/17

76 | Implementação | 37 days | Mon 10/04/17 | Tue 30/05/17
77 | Montar estrutura básica (pré-determinada) | 1 day | Tue 11/04/17 | Tue 11/04/17

90 | Finalizar Documentação | 8 days | Thu 18/05/17 | Mon 29/05/17
91 | Apresentação Gate 2 (.ppt) | 3 days | Thu 25/05/17 | Mon 29/05/17 | Avy Pinto
92 | Gate 2 | 0 days | Tue 30/05/17 | Tue 30/05/17
