pepocasella/Projeto-Mecatronico/Mecânica/Desenhos Técnicos/Bloco de elevacao Drawing v2.pdf

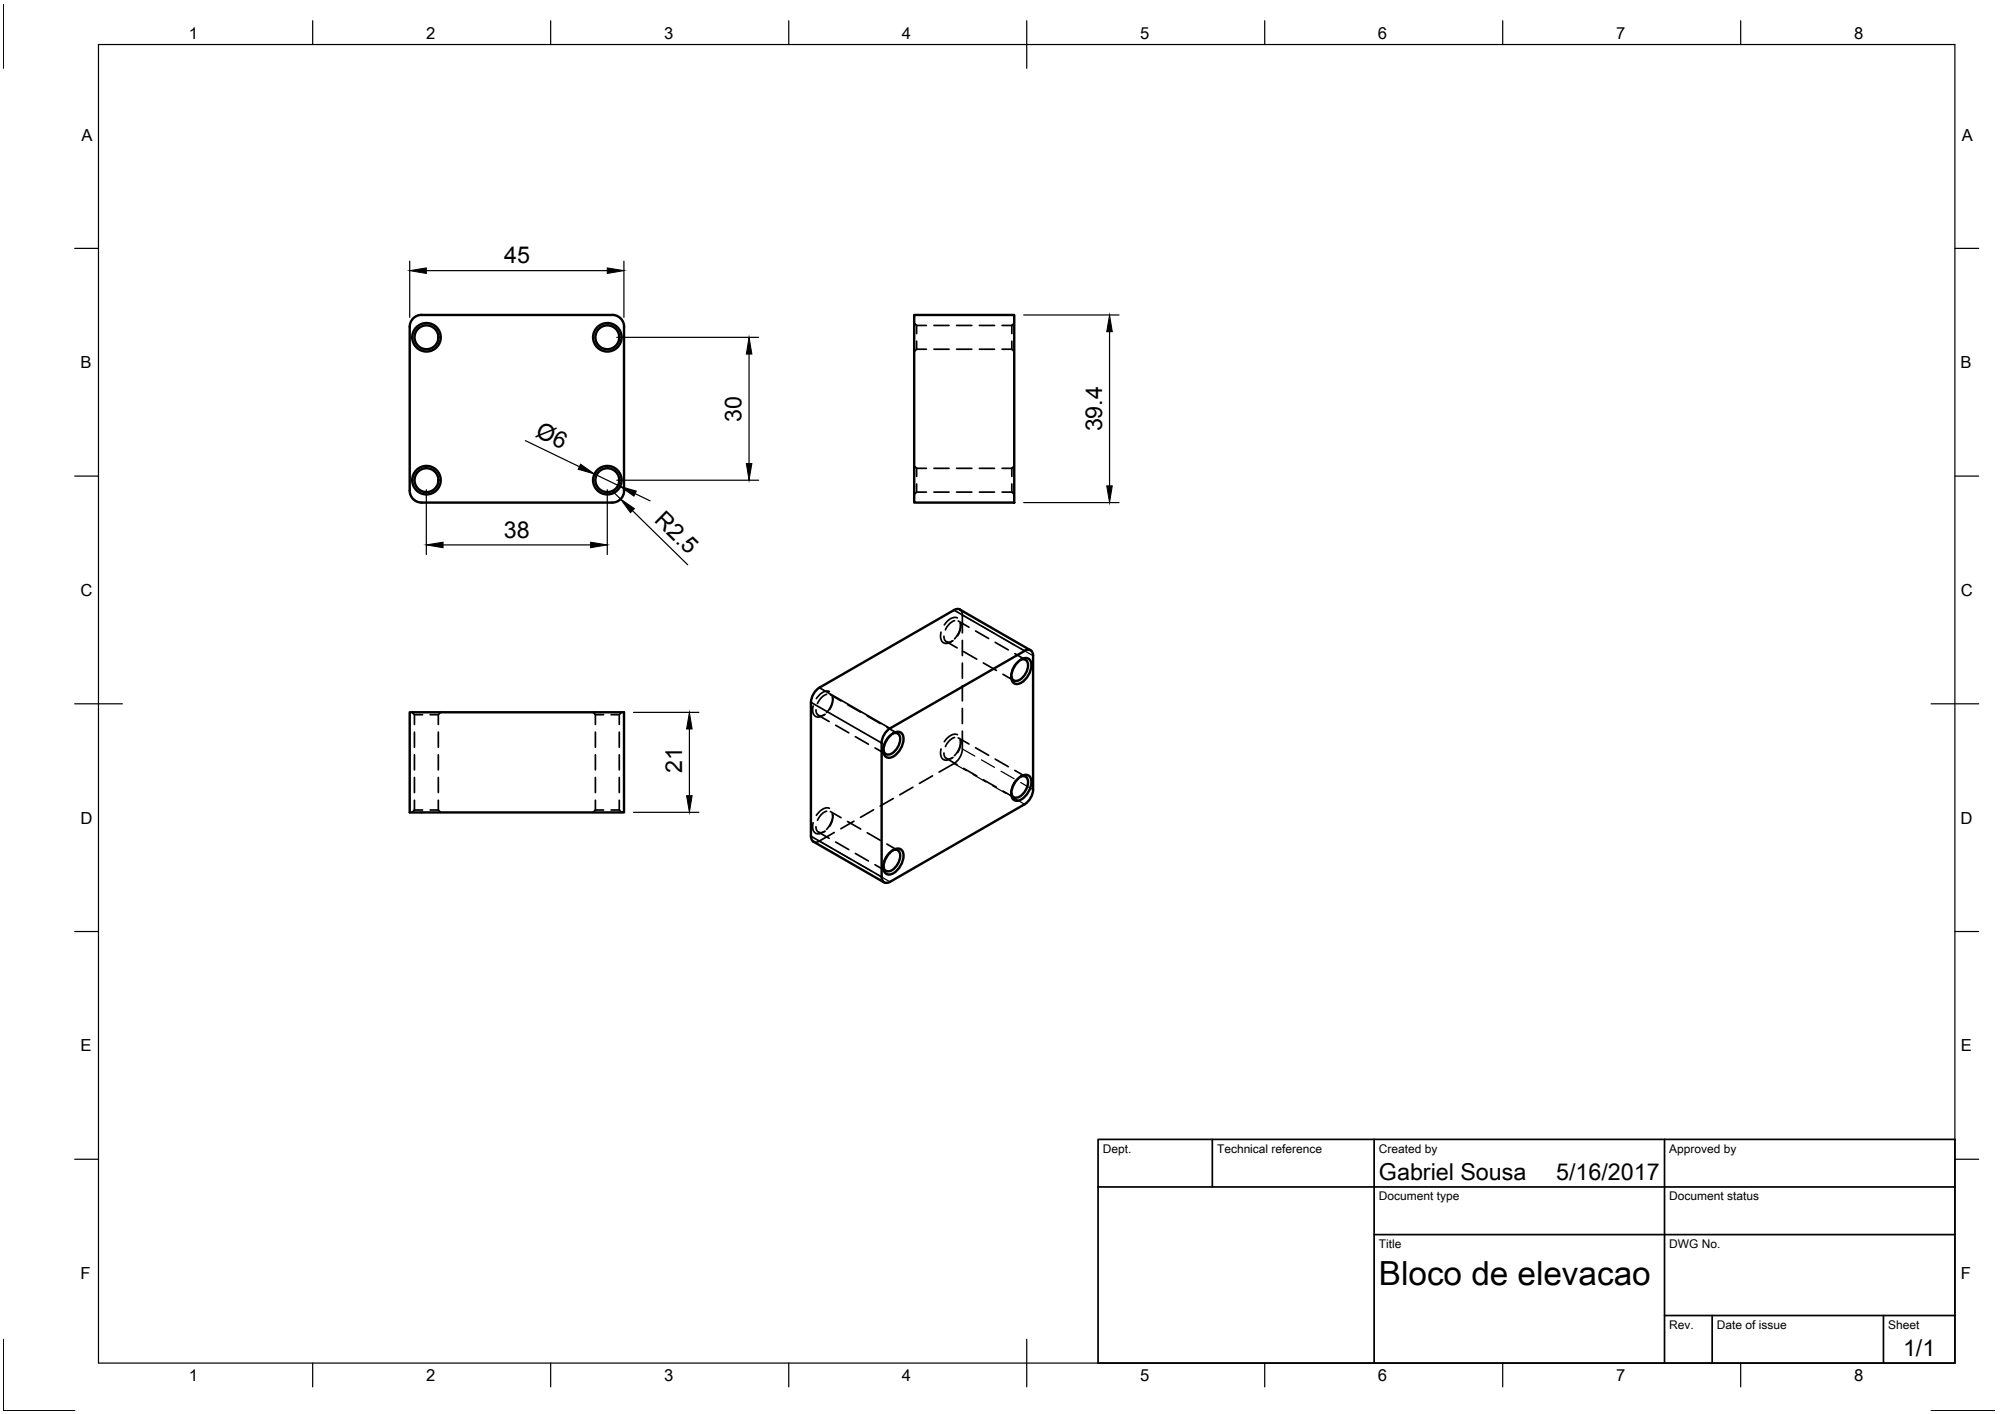
[picture p133: page 1]

Dept. | Technical reference | Created by Gabriel Sousa 5/16/2017 | Approved by

Document type | Document status

Title Bloco de elevacao | DWG No.

Rev. | Date of issue | Sheet 1/1
