pepocasella/Projeto-Mecatronico/Mecânica/Desenhos Técnicos/DESENHO TECNICO DETALHADO BASE v5.pdf

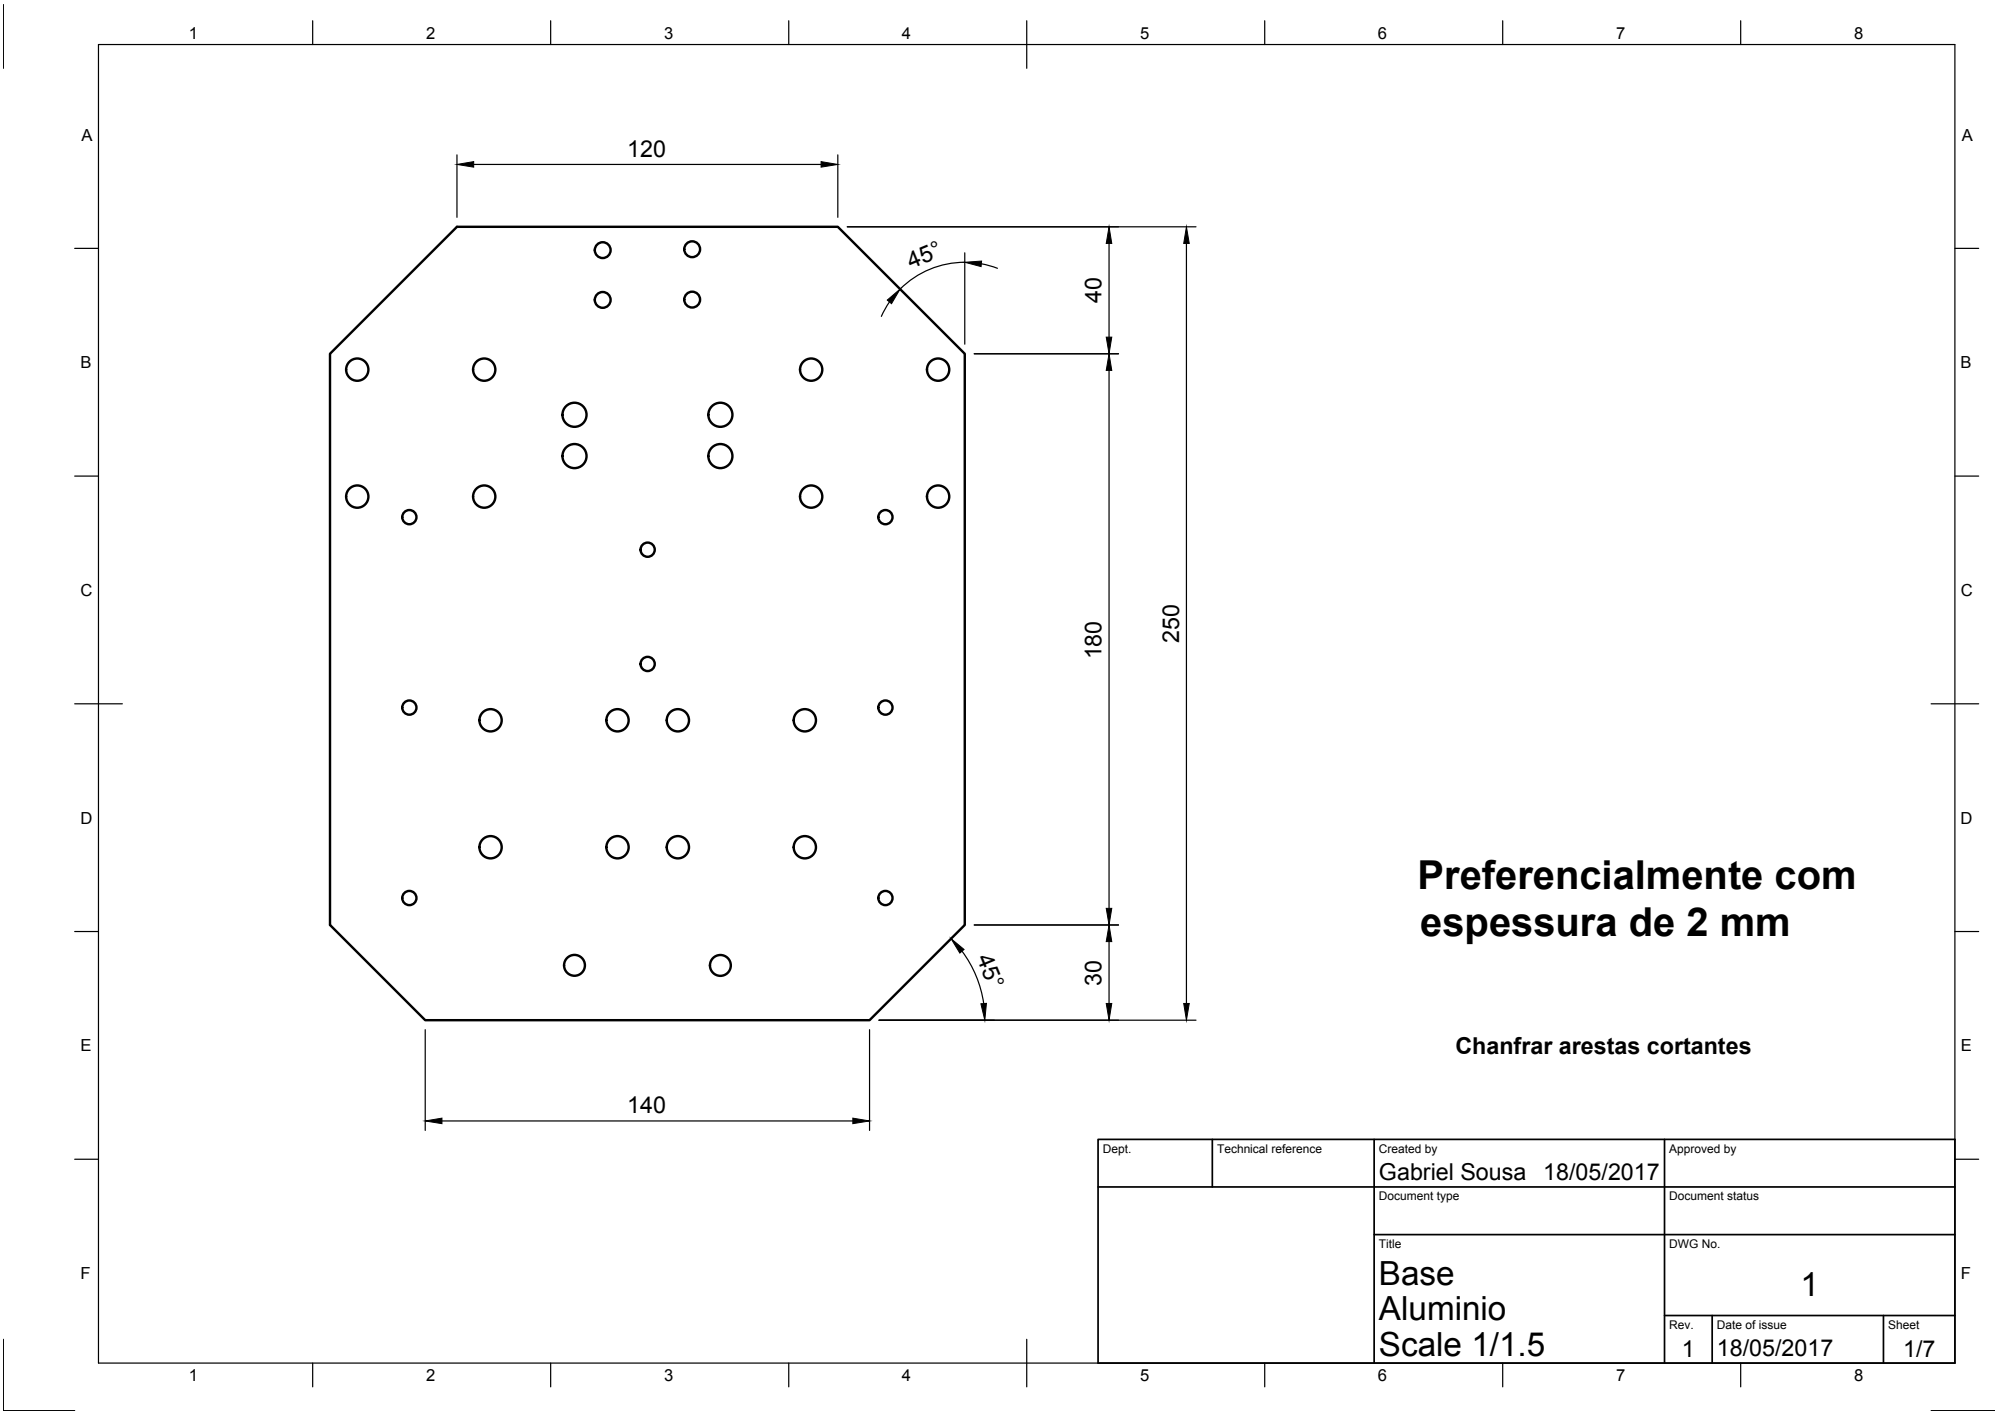
[picture p134: page 1]

Preferencialmente com
espessura de 2 mm

Chanfrar arestas cortantes

Dept. | Technical reference | Created by Gabriel Sousa 18/05/2017 | Approved by

Document type | Document status

Title Aluminio Scale 1/1.5 | DWG No. 1 Base

Rev. 1 | Date of issue 18/05/2017 | Sheet

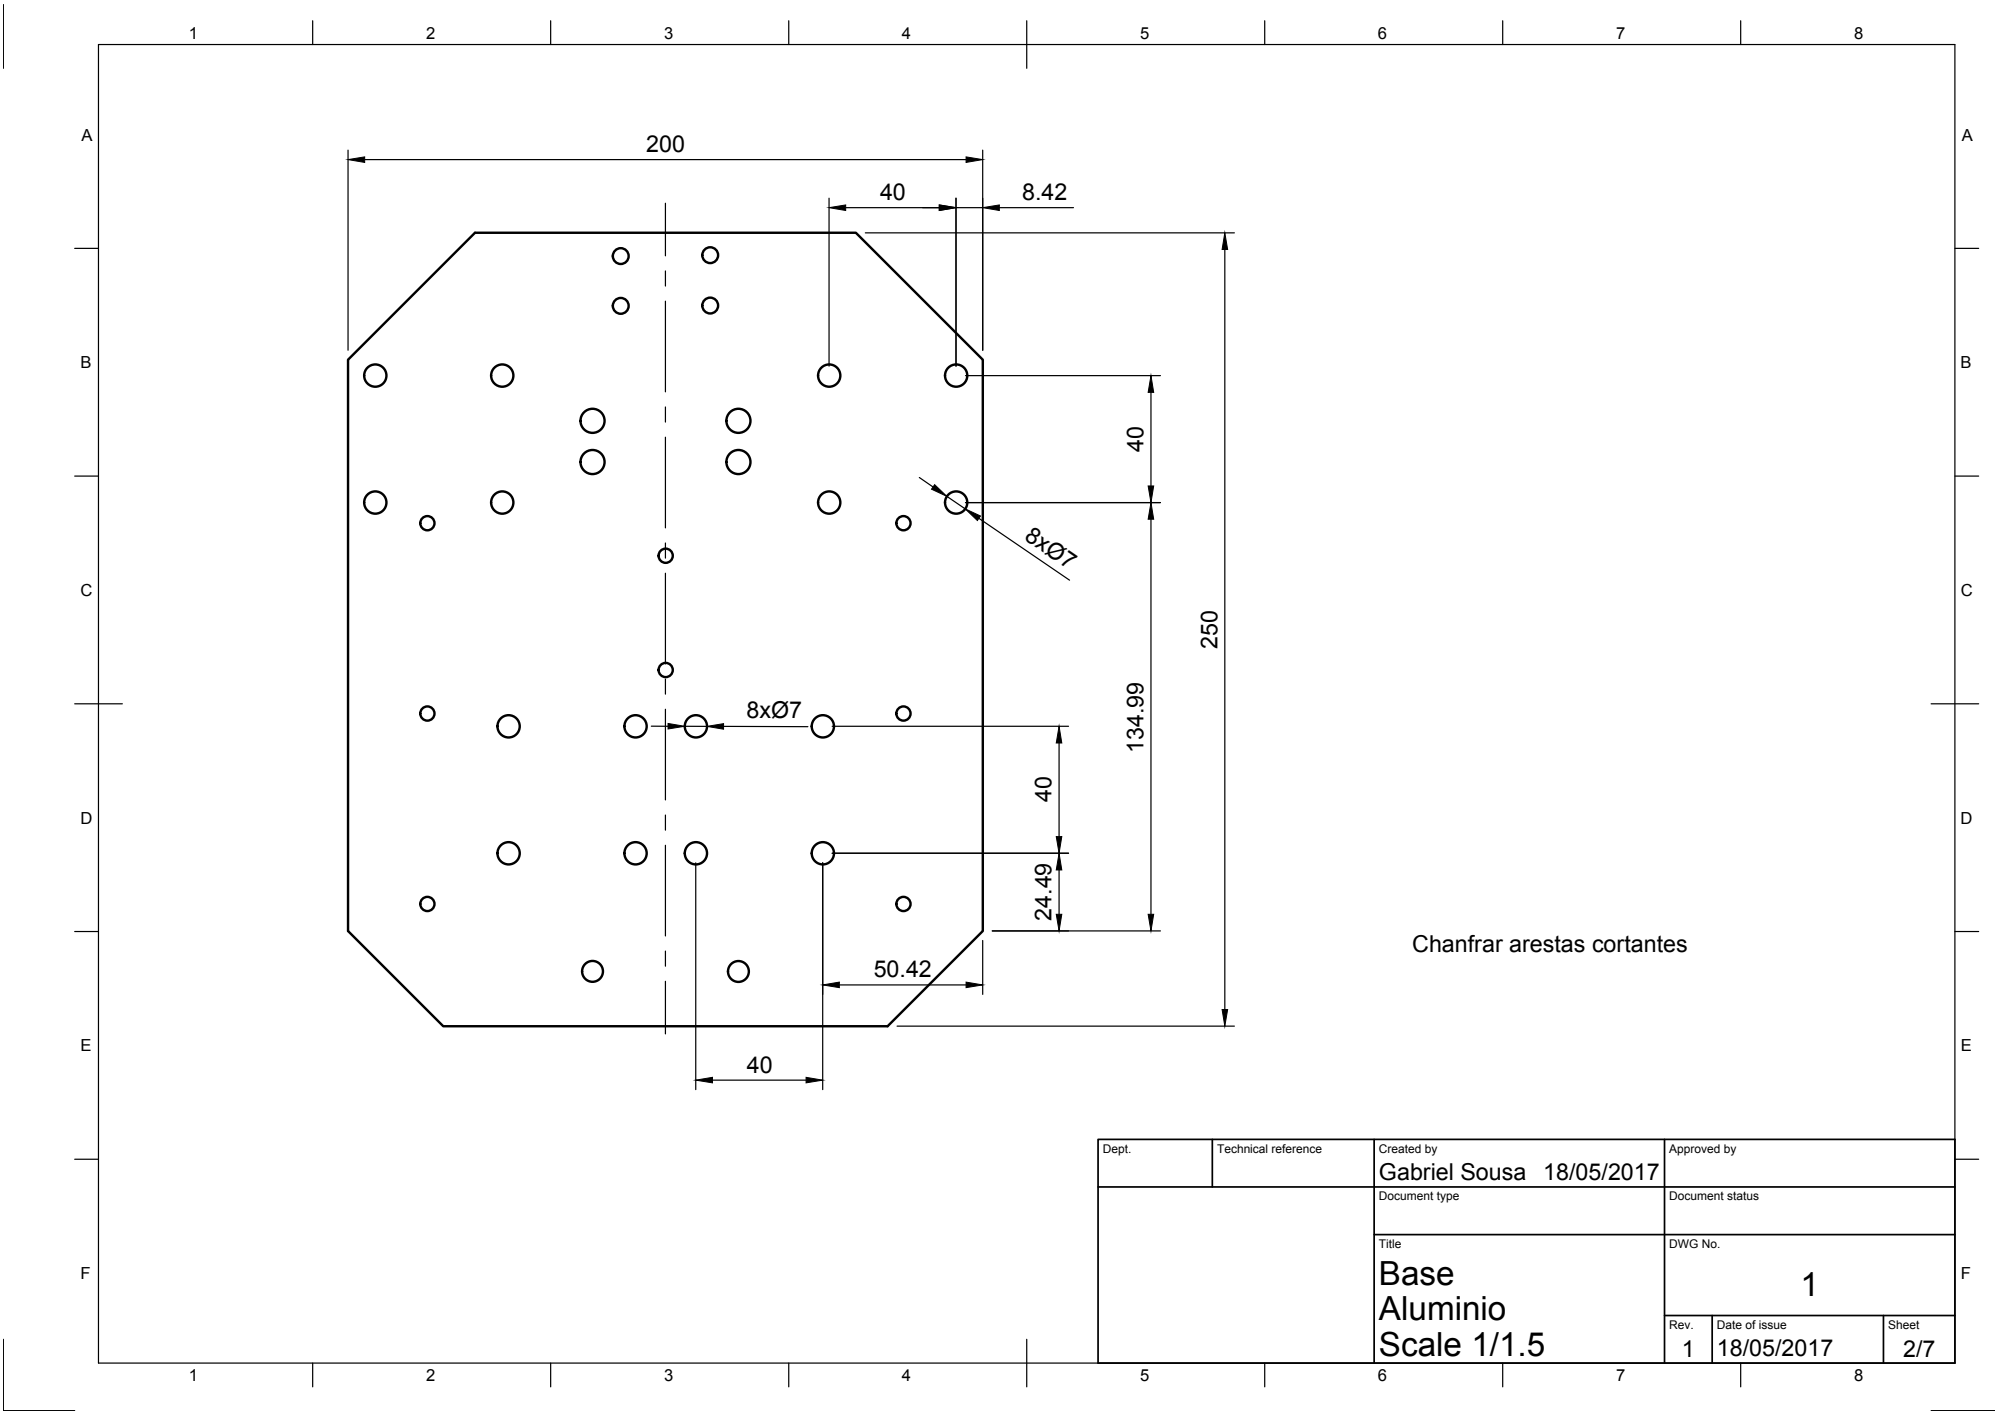
[picture p135: page 2]

Chanfrar arestas cortantes

Dept. | Technical reference | Created by Gabriel Sousa 18/05/2017 | Approved by

Document type | Document status

Title | DWG No. 1 Base

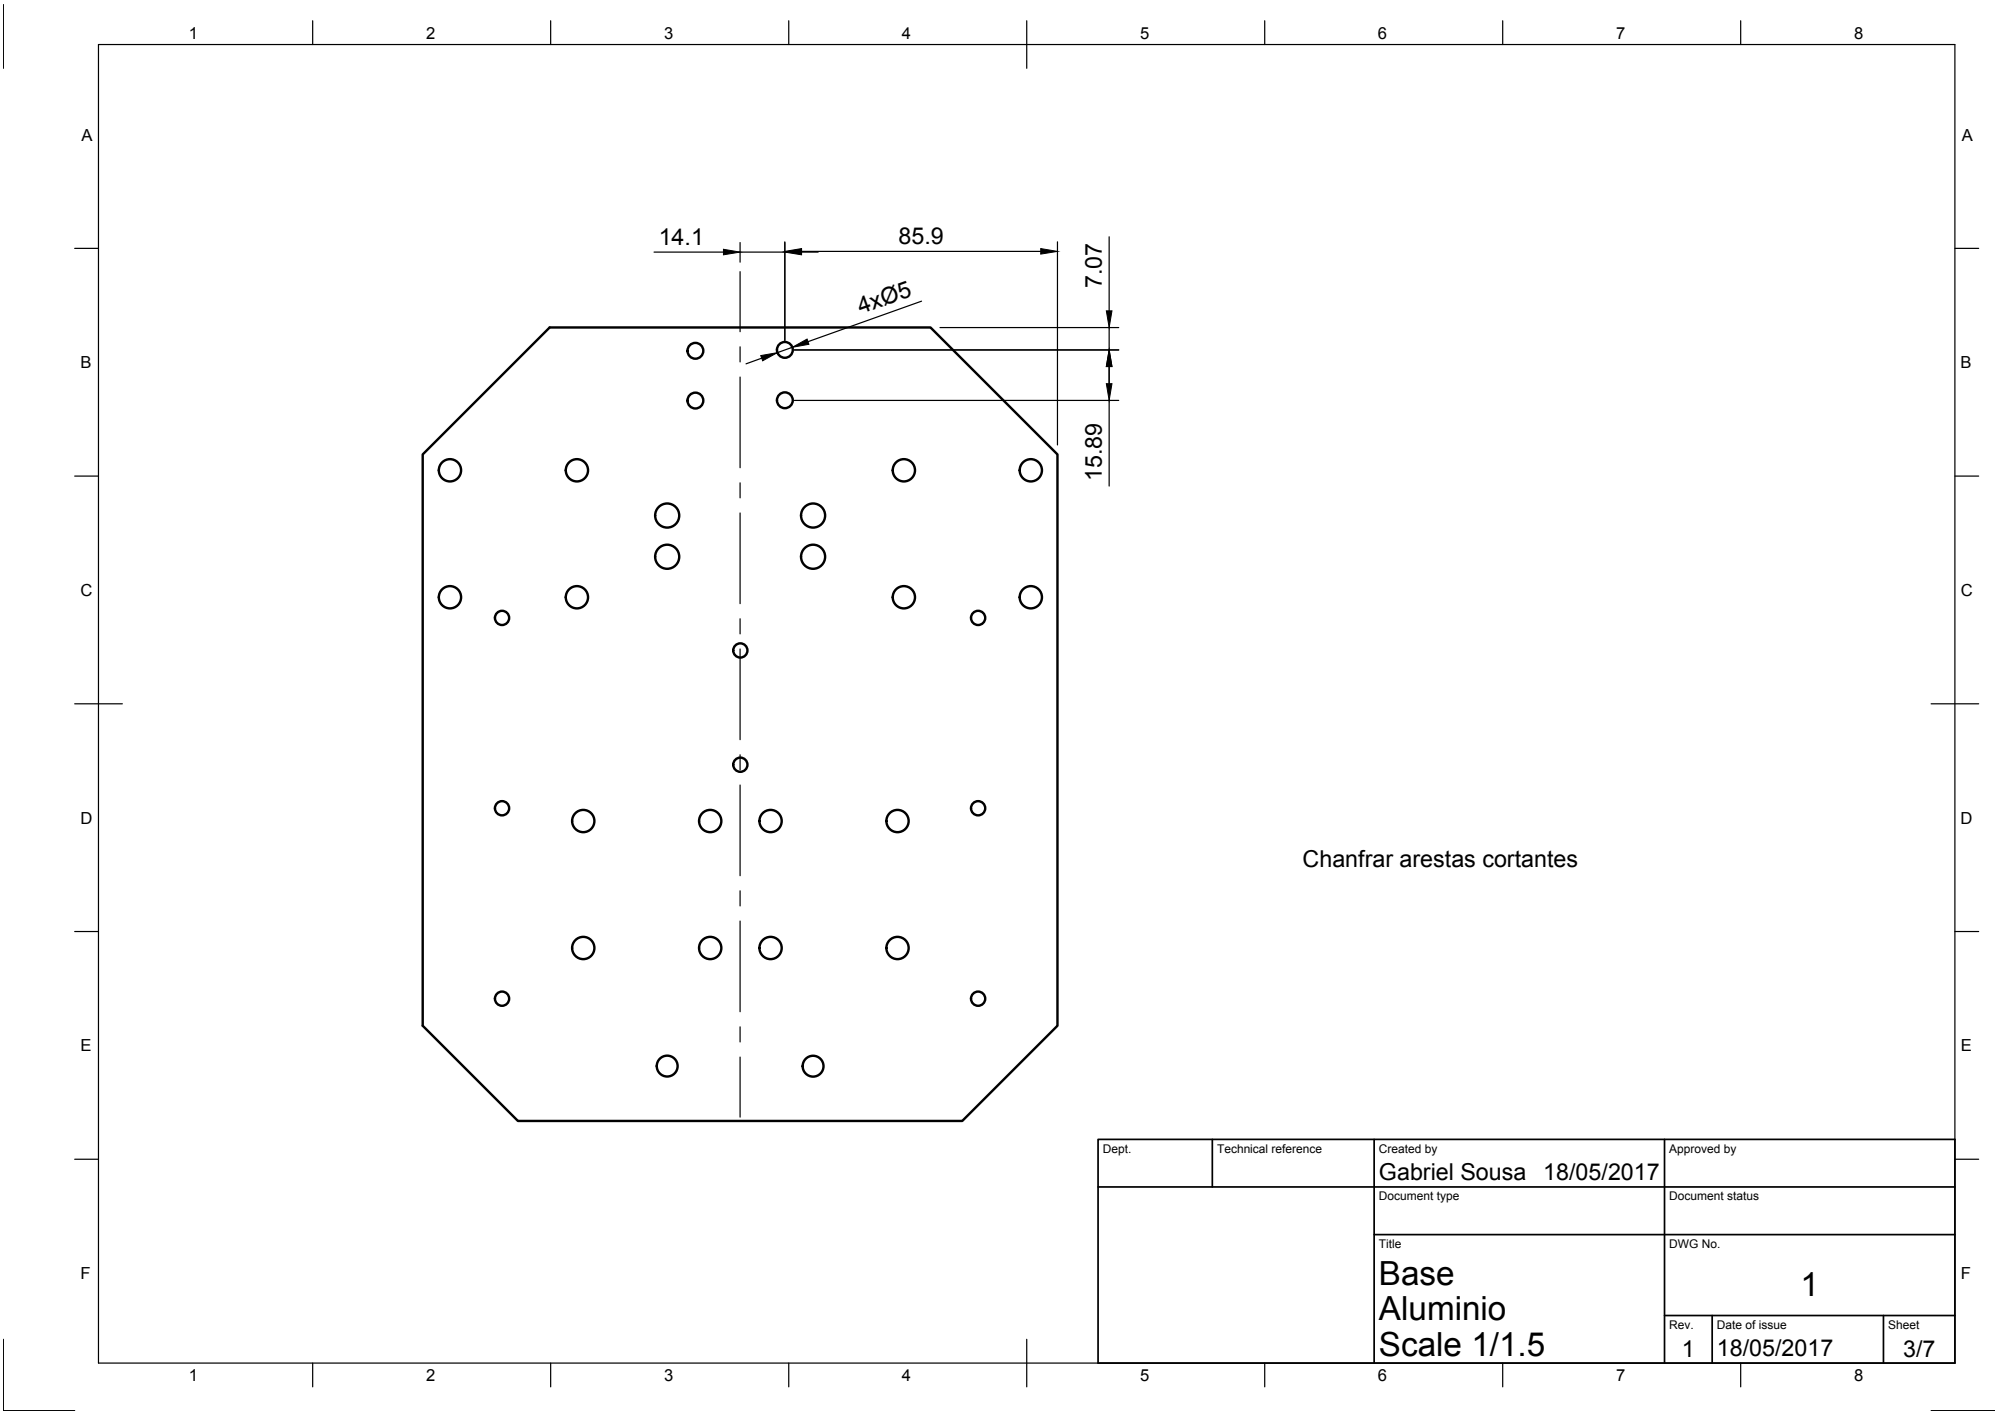
[picture p136: page 3]

Chanfrar arestas cortantes

Dept. | Technical reference | Created by Gabriel Sousa 18/05/2017 | Approved by

Document type | Document status

Title | DWG No. 1 Base

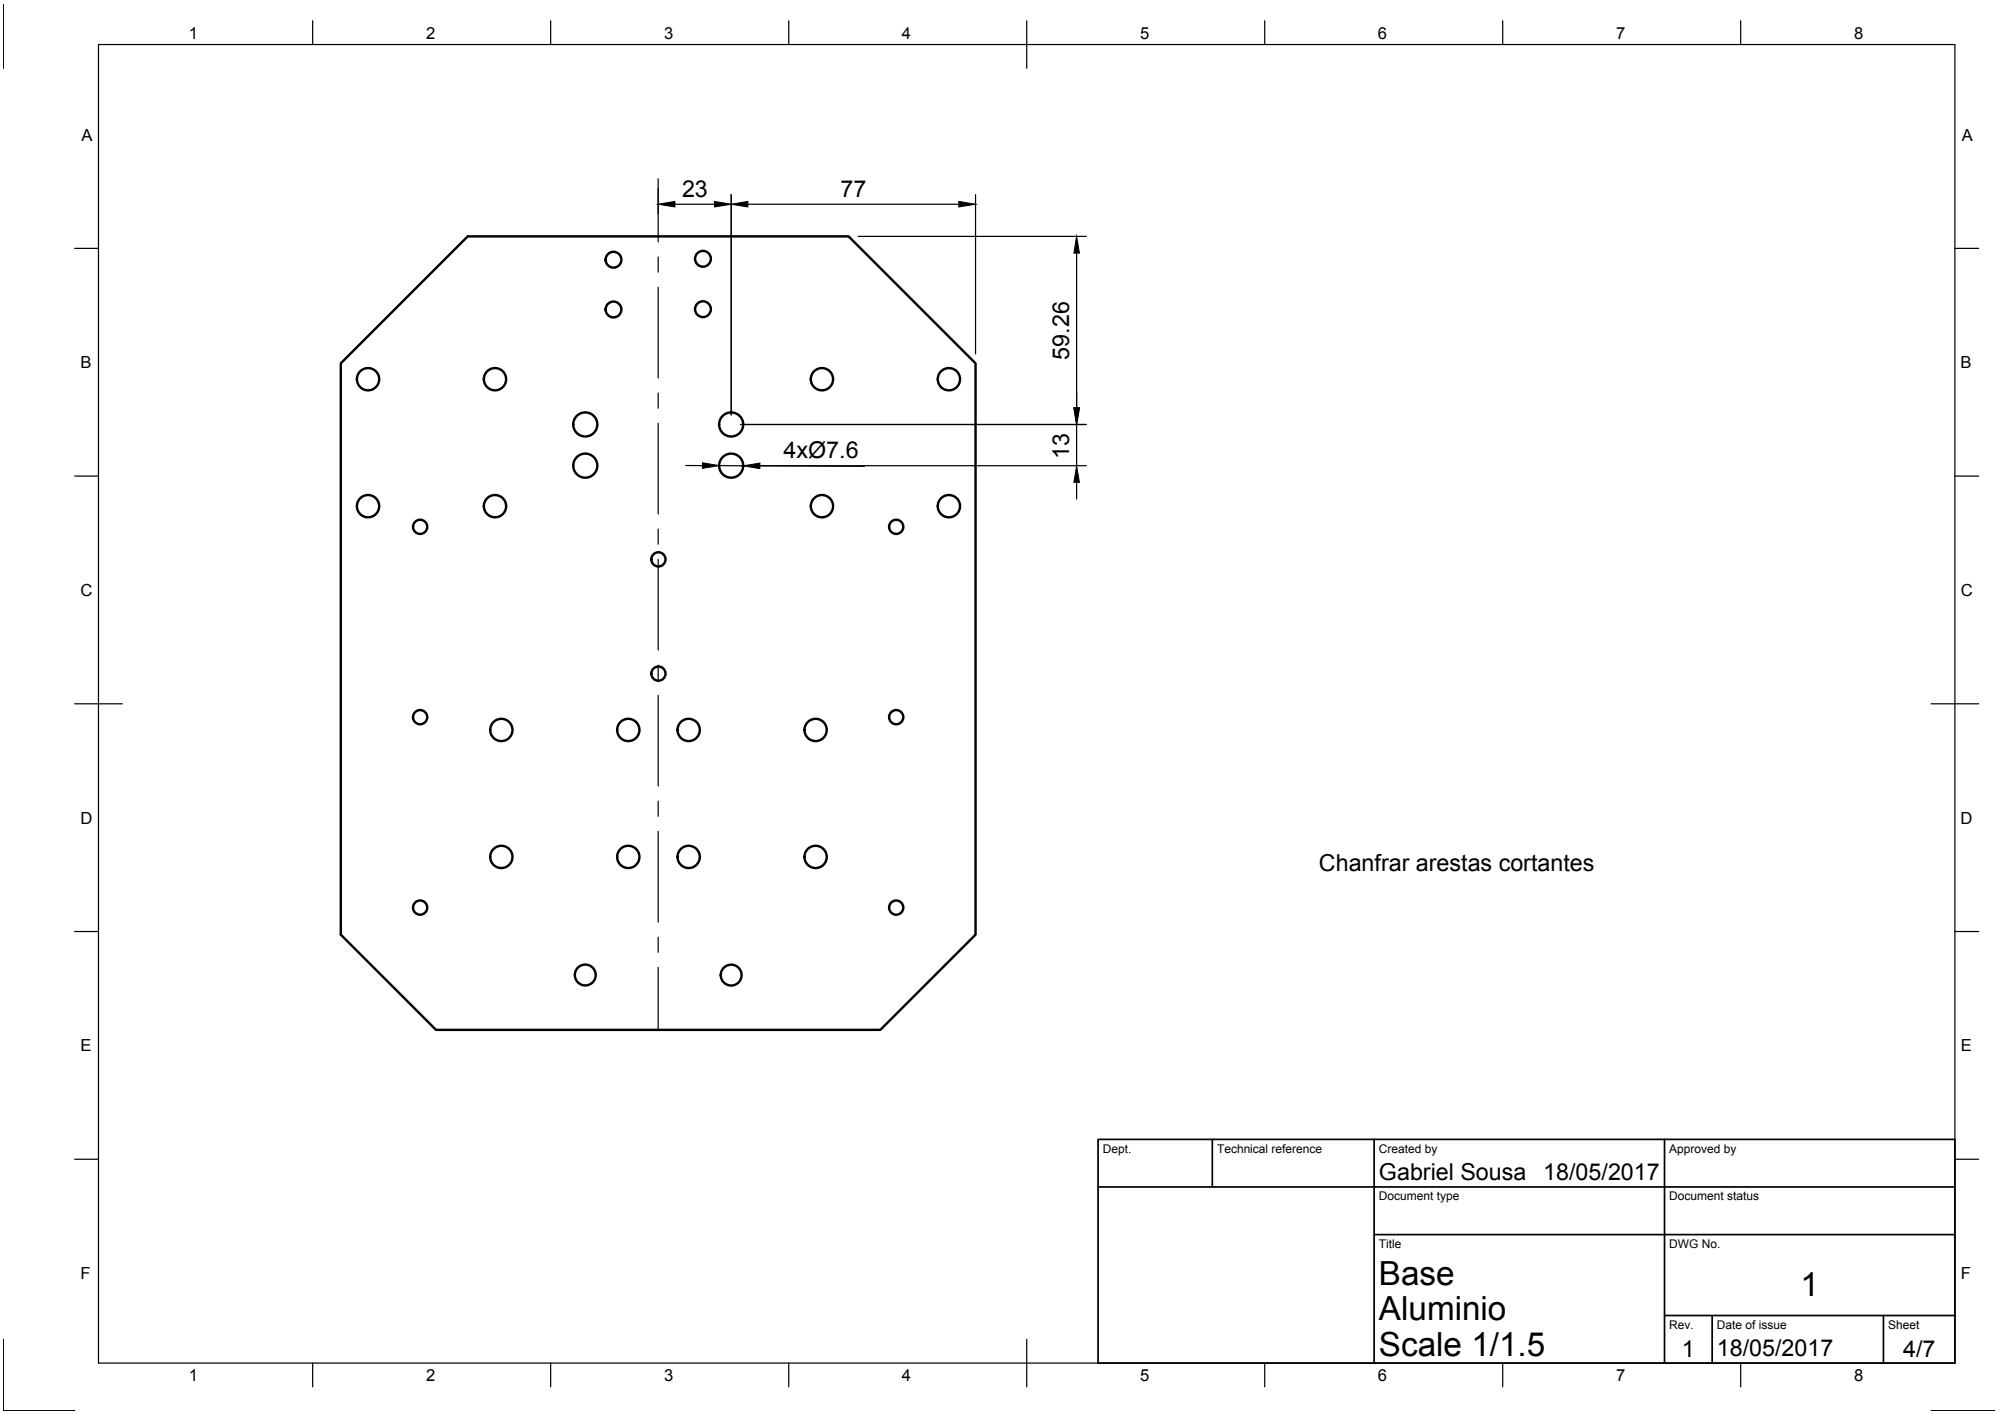
[picture p137: page 4]
Gabriel Sousa 13 59.26

Chanfrar arestas cortantes

Dept. | Technical reference | Created by 18/05/2017 | Approved by

Document type | Document status

Title | DWG No. 1 Base

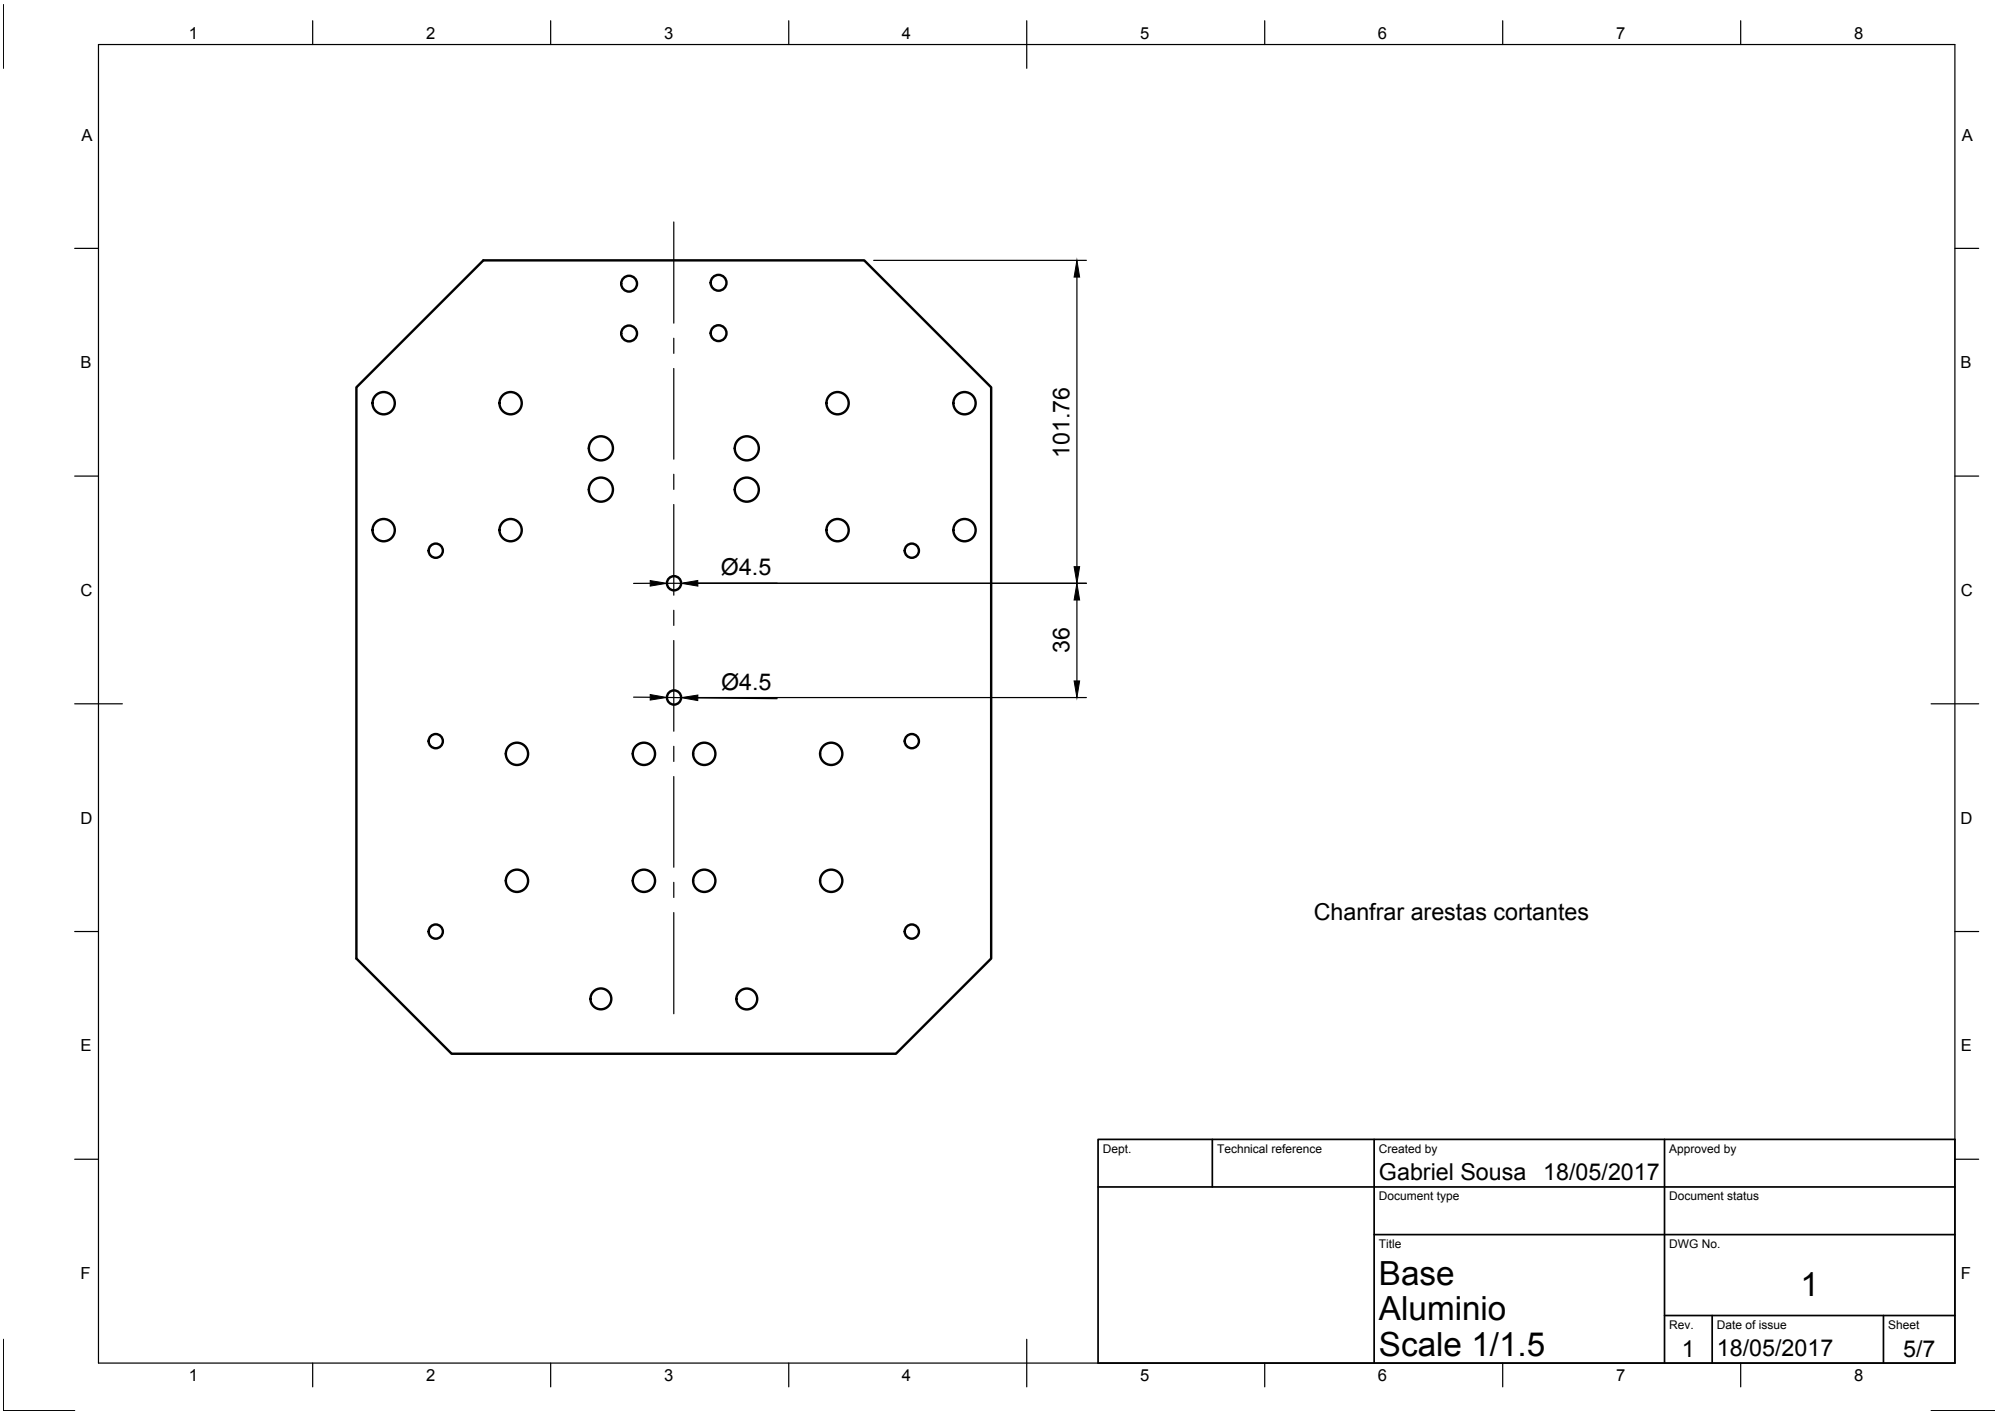
[picture p138: page 5]

Chanfrar arestas cortantes

Dept. | Technical reference | Created by Gabriel Sousa 18/05/2017 | Approved by

Document type | Document status

Title | DWG No. 1 Base

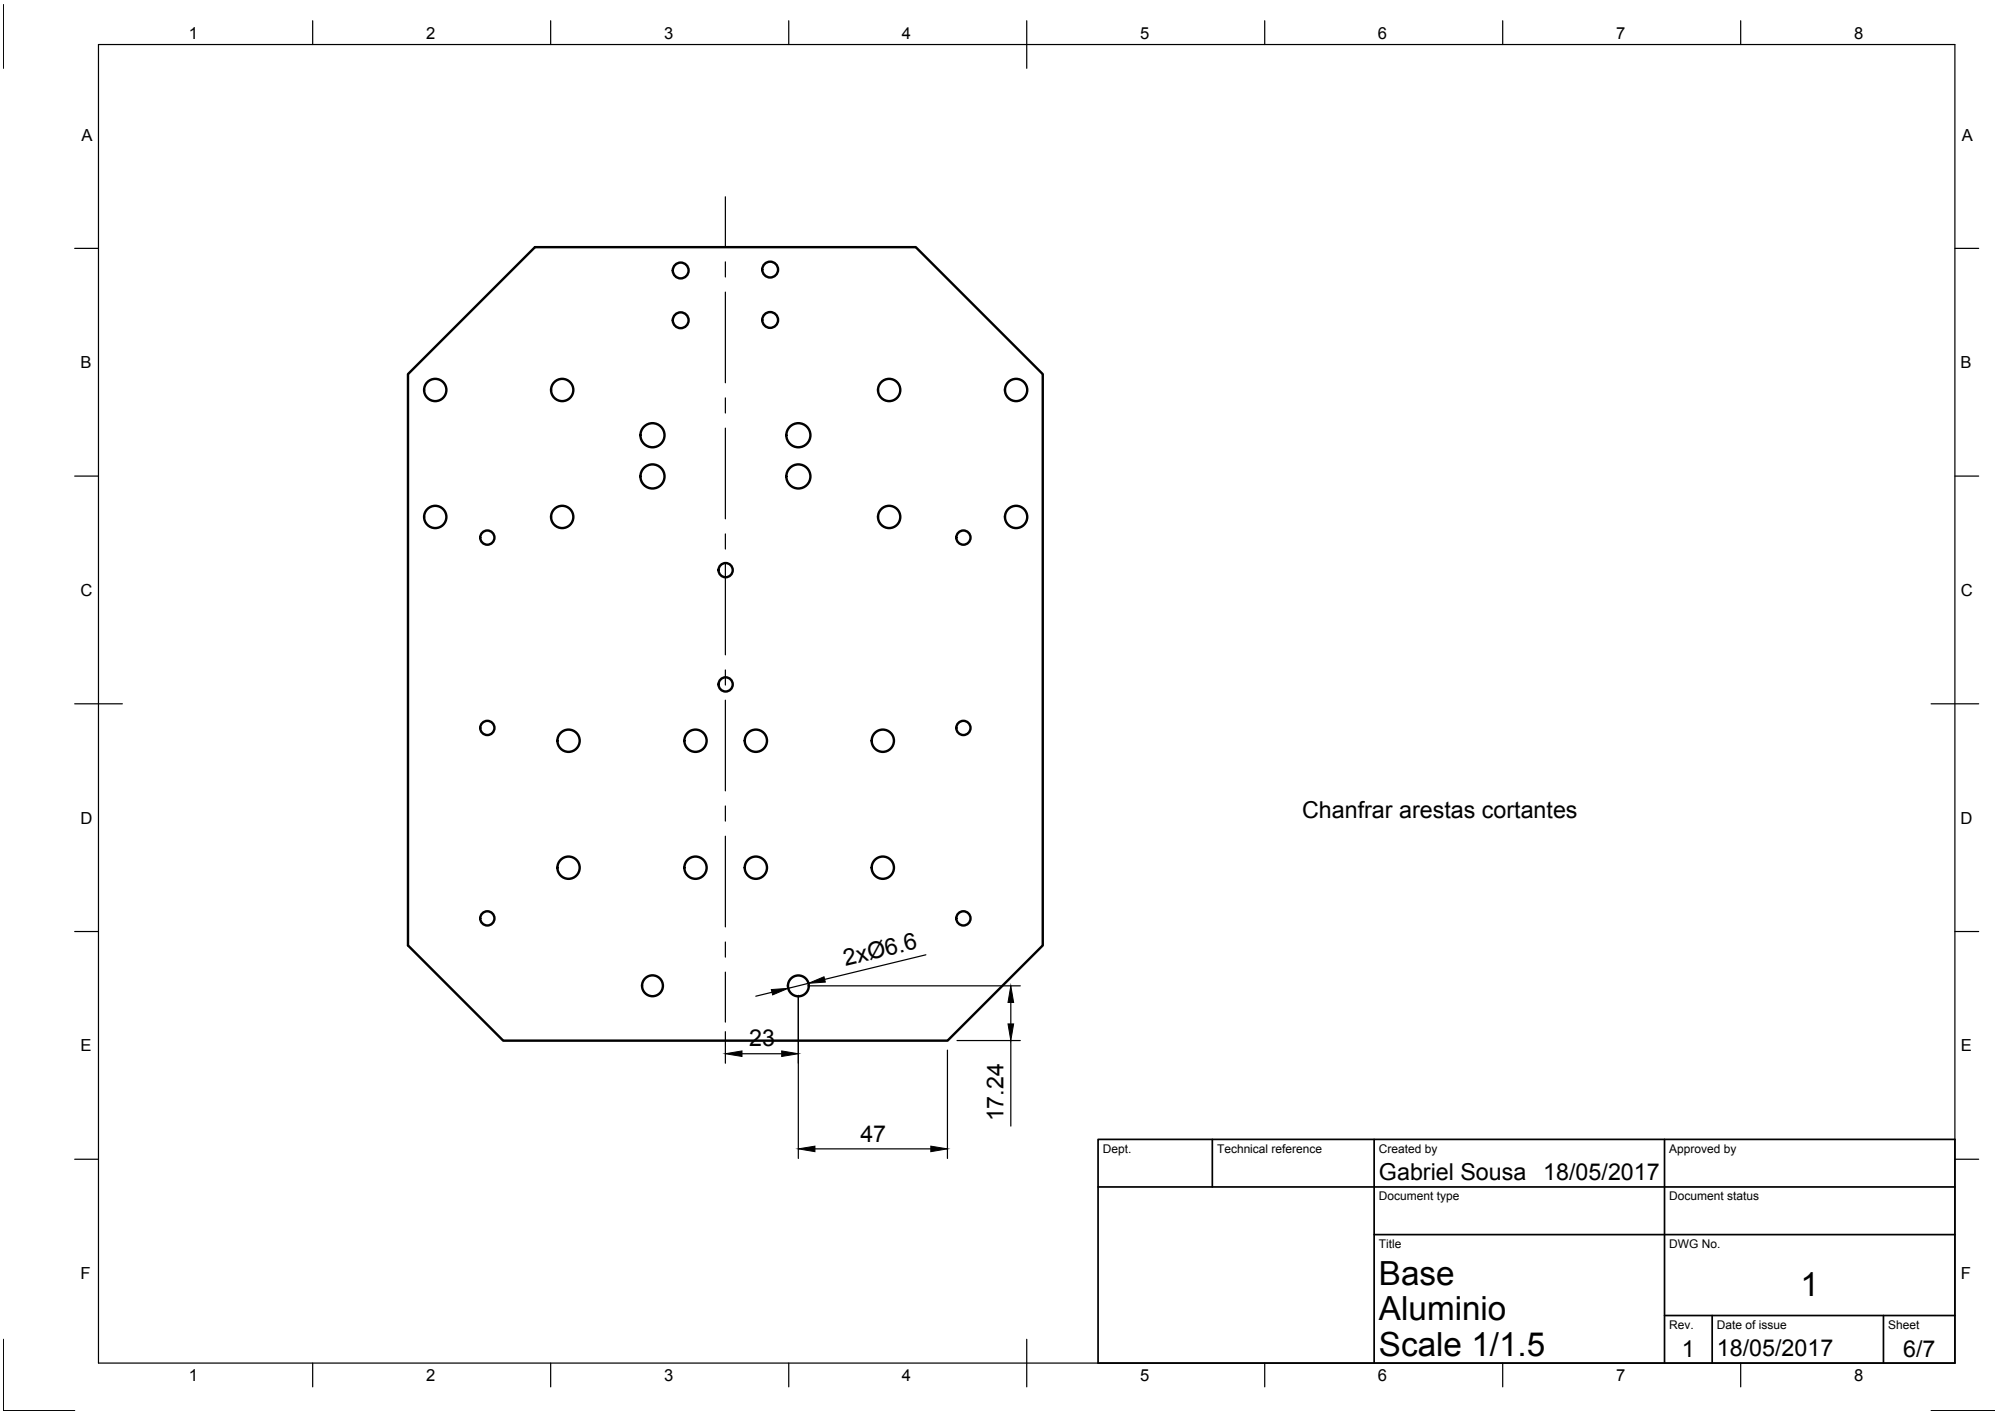
[picture p139: page 6]

Chanfrar arestas cortantes

Dept. | Technical reference | Created by Gabriel Sousa 18/05/2017 | Approved by

Document type | Document status

Title | DWG No. 1 Base

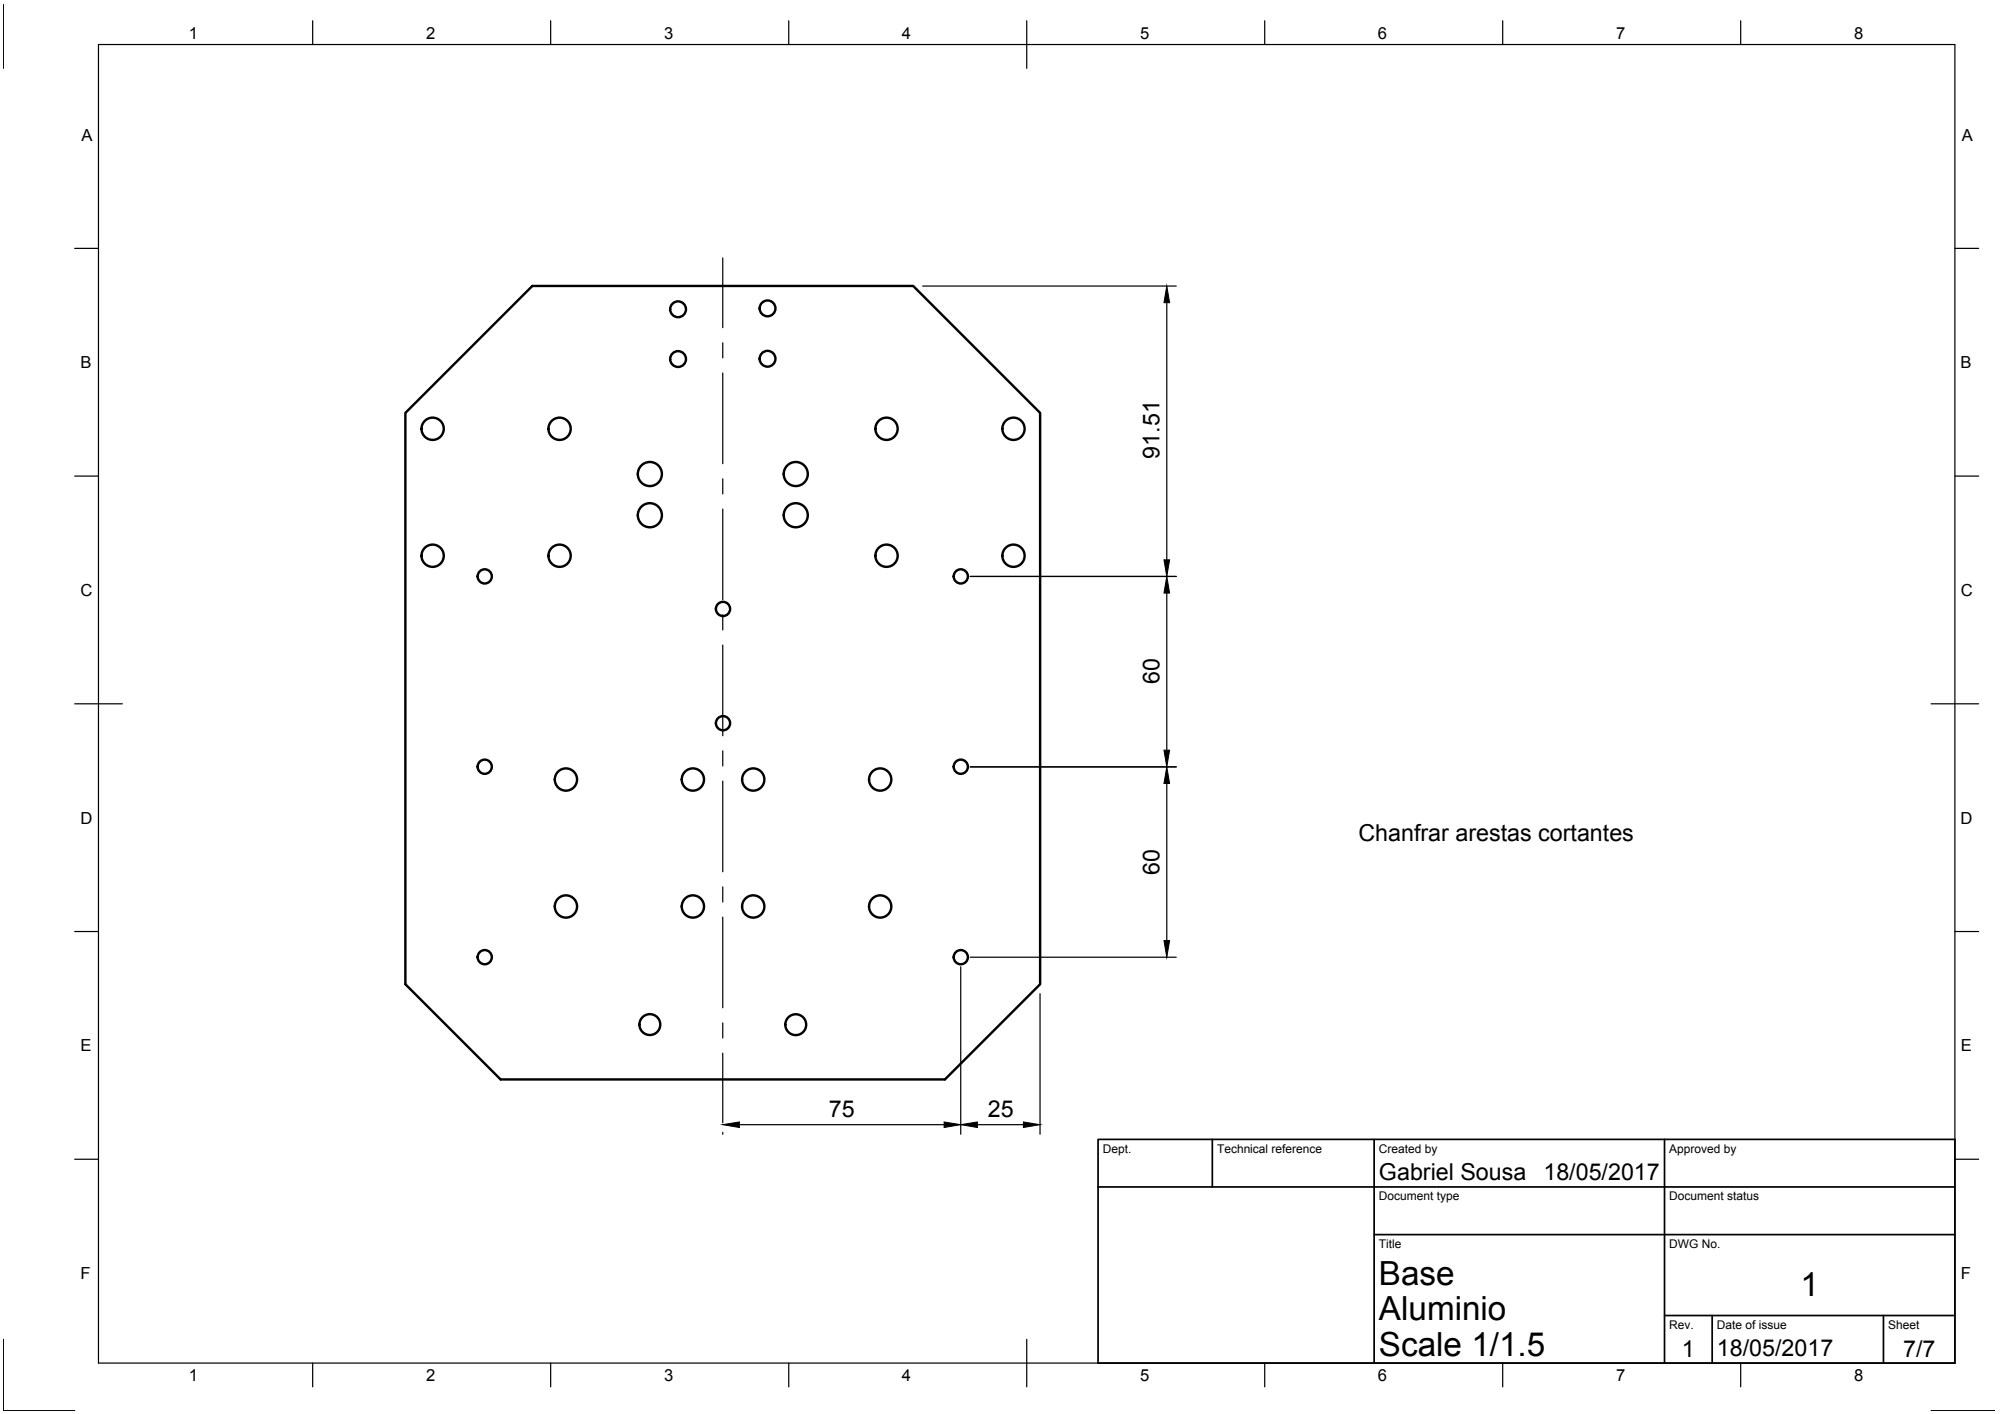
[picture p140: page 7]
Gabriel Sousa 91.51 60 60

Chanfrar arestas cortantes

Dept. | Technical reference | Created by 18/05/2017 | Approved by

Document type | Document status

Title | DWG No. 1 Base
