pepocasella/Projeto-Mecatronico/Mecânica/Desenhos Técnicos/Fuso.pdf

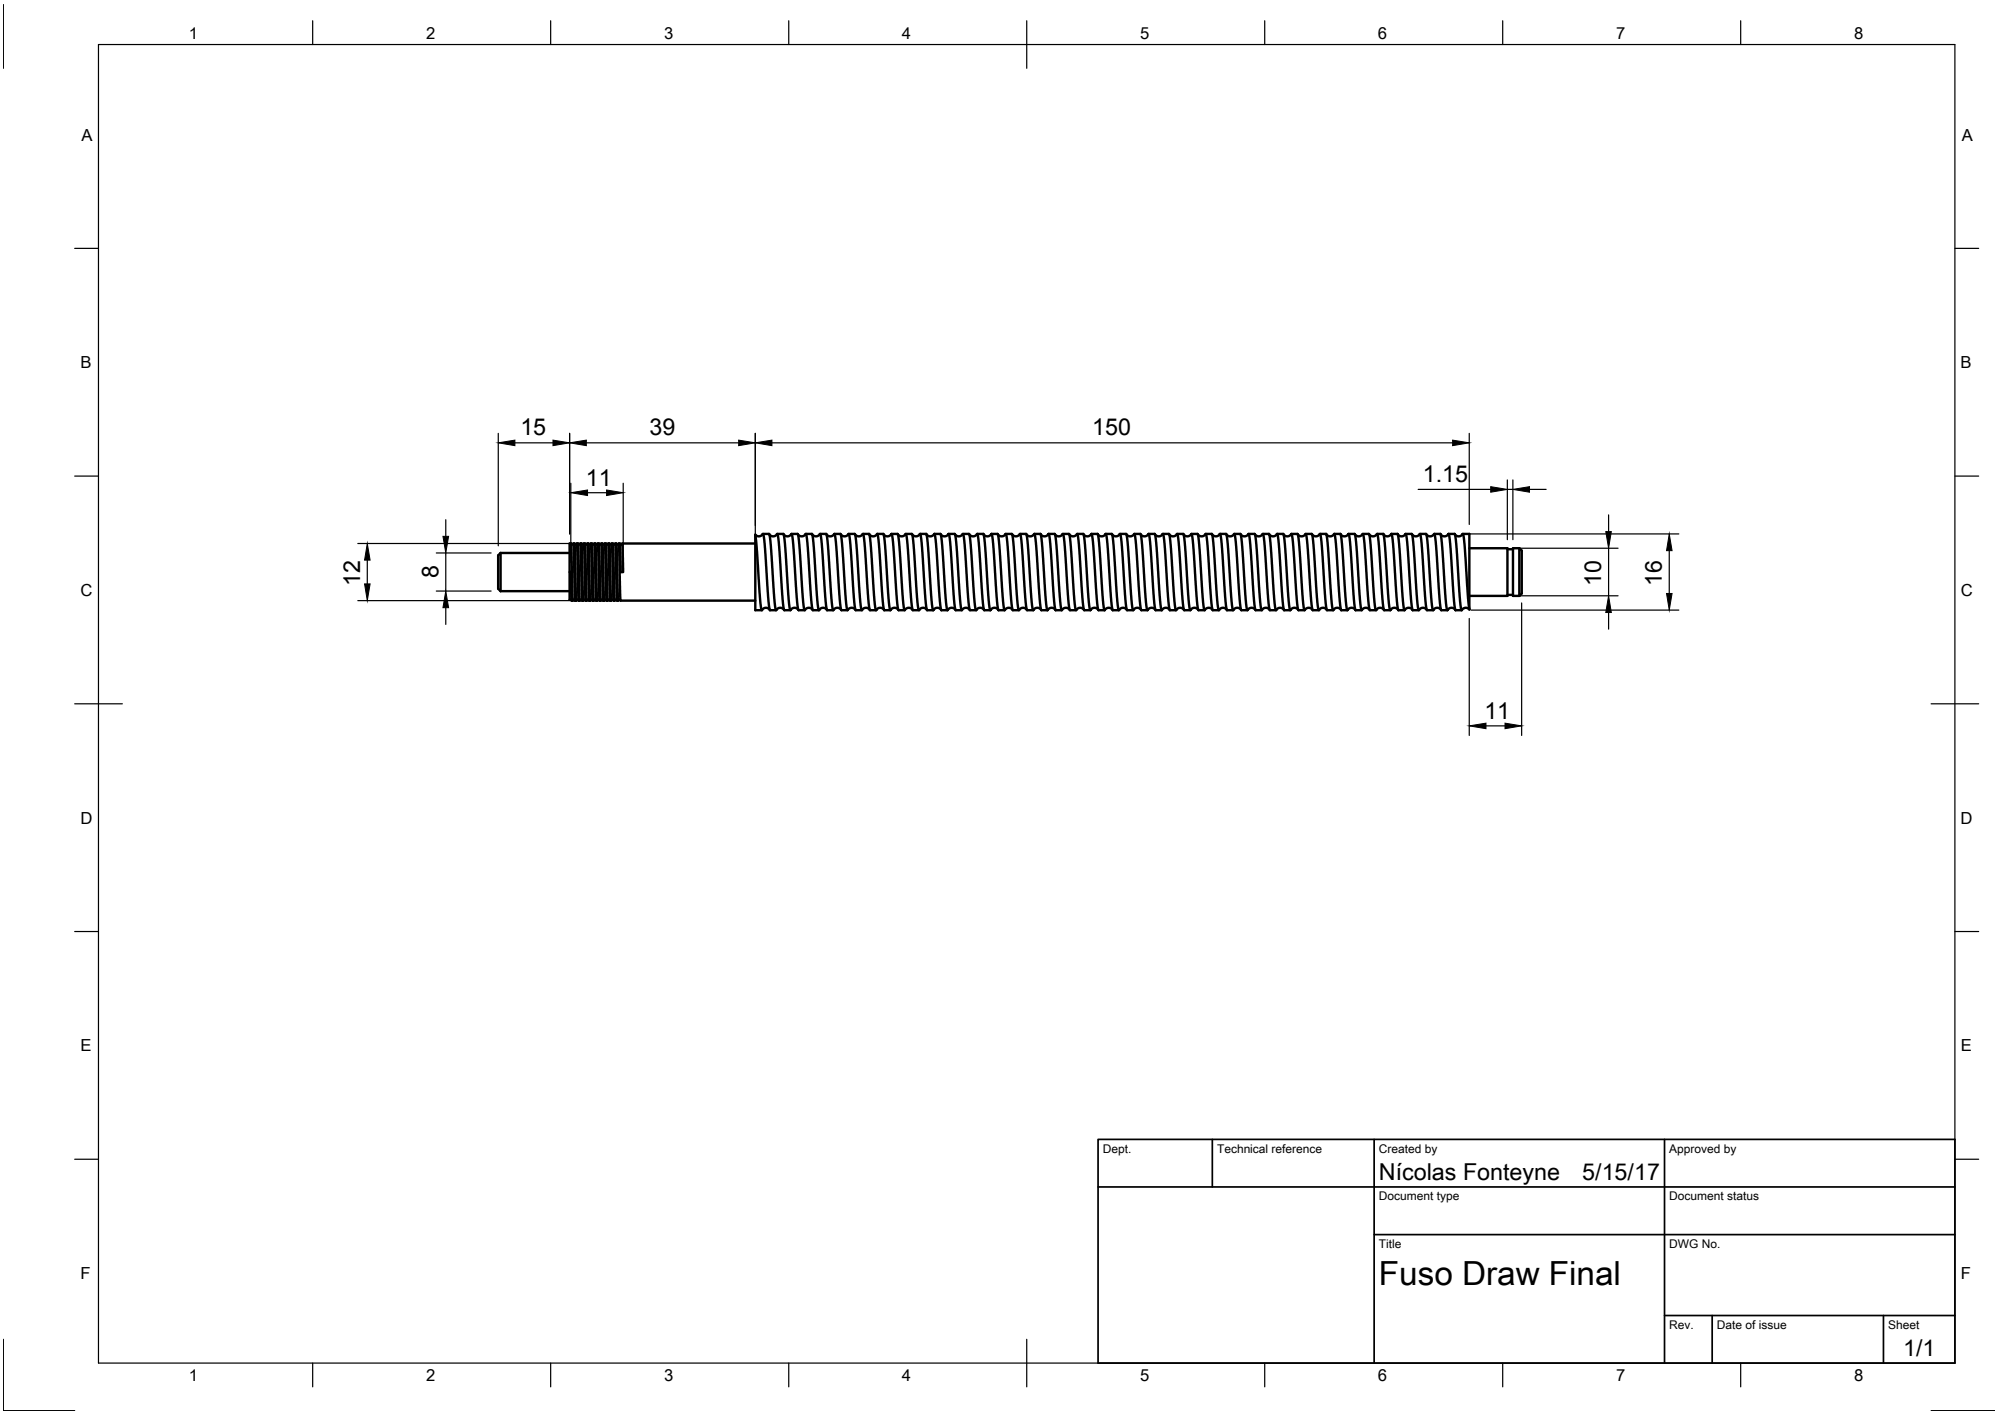
[picture p141: page 1]
Nícolas Fonteyne 12

Dept. | Technical reference | Created by 5/15/17 | Approved by

Document type | Document status

Title Fuso Draw Final | DWG No.

Rev. | Date of issue | Sheet 1/1
