pepocasella/Projeto-Mecatronico/Mecânica/Desenhos Técnicos/Mesa Final Drawing v3.pdf

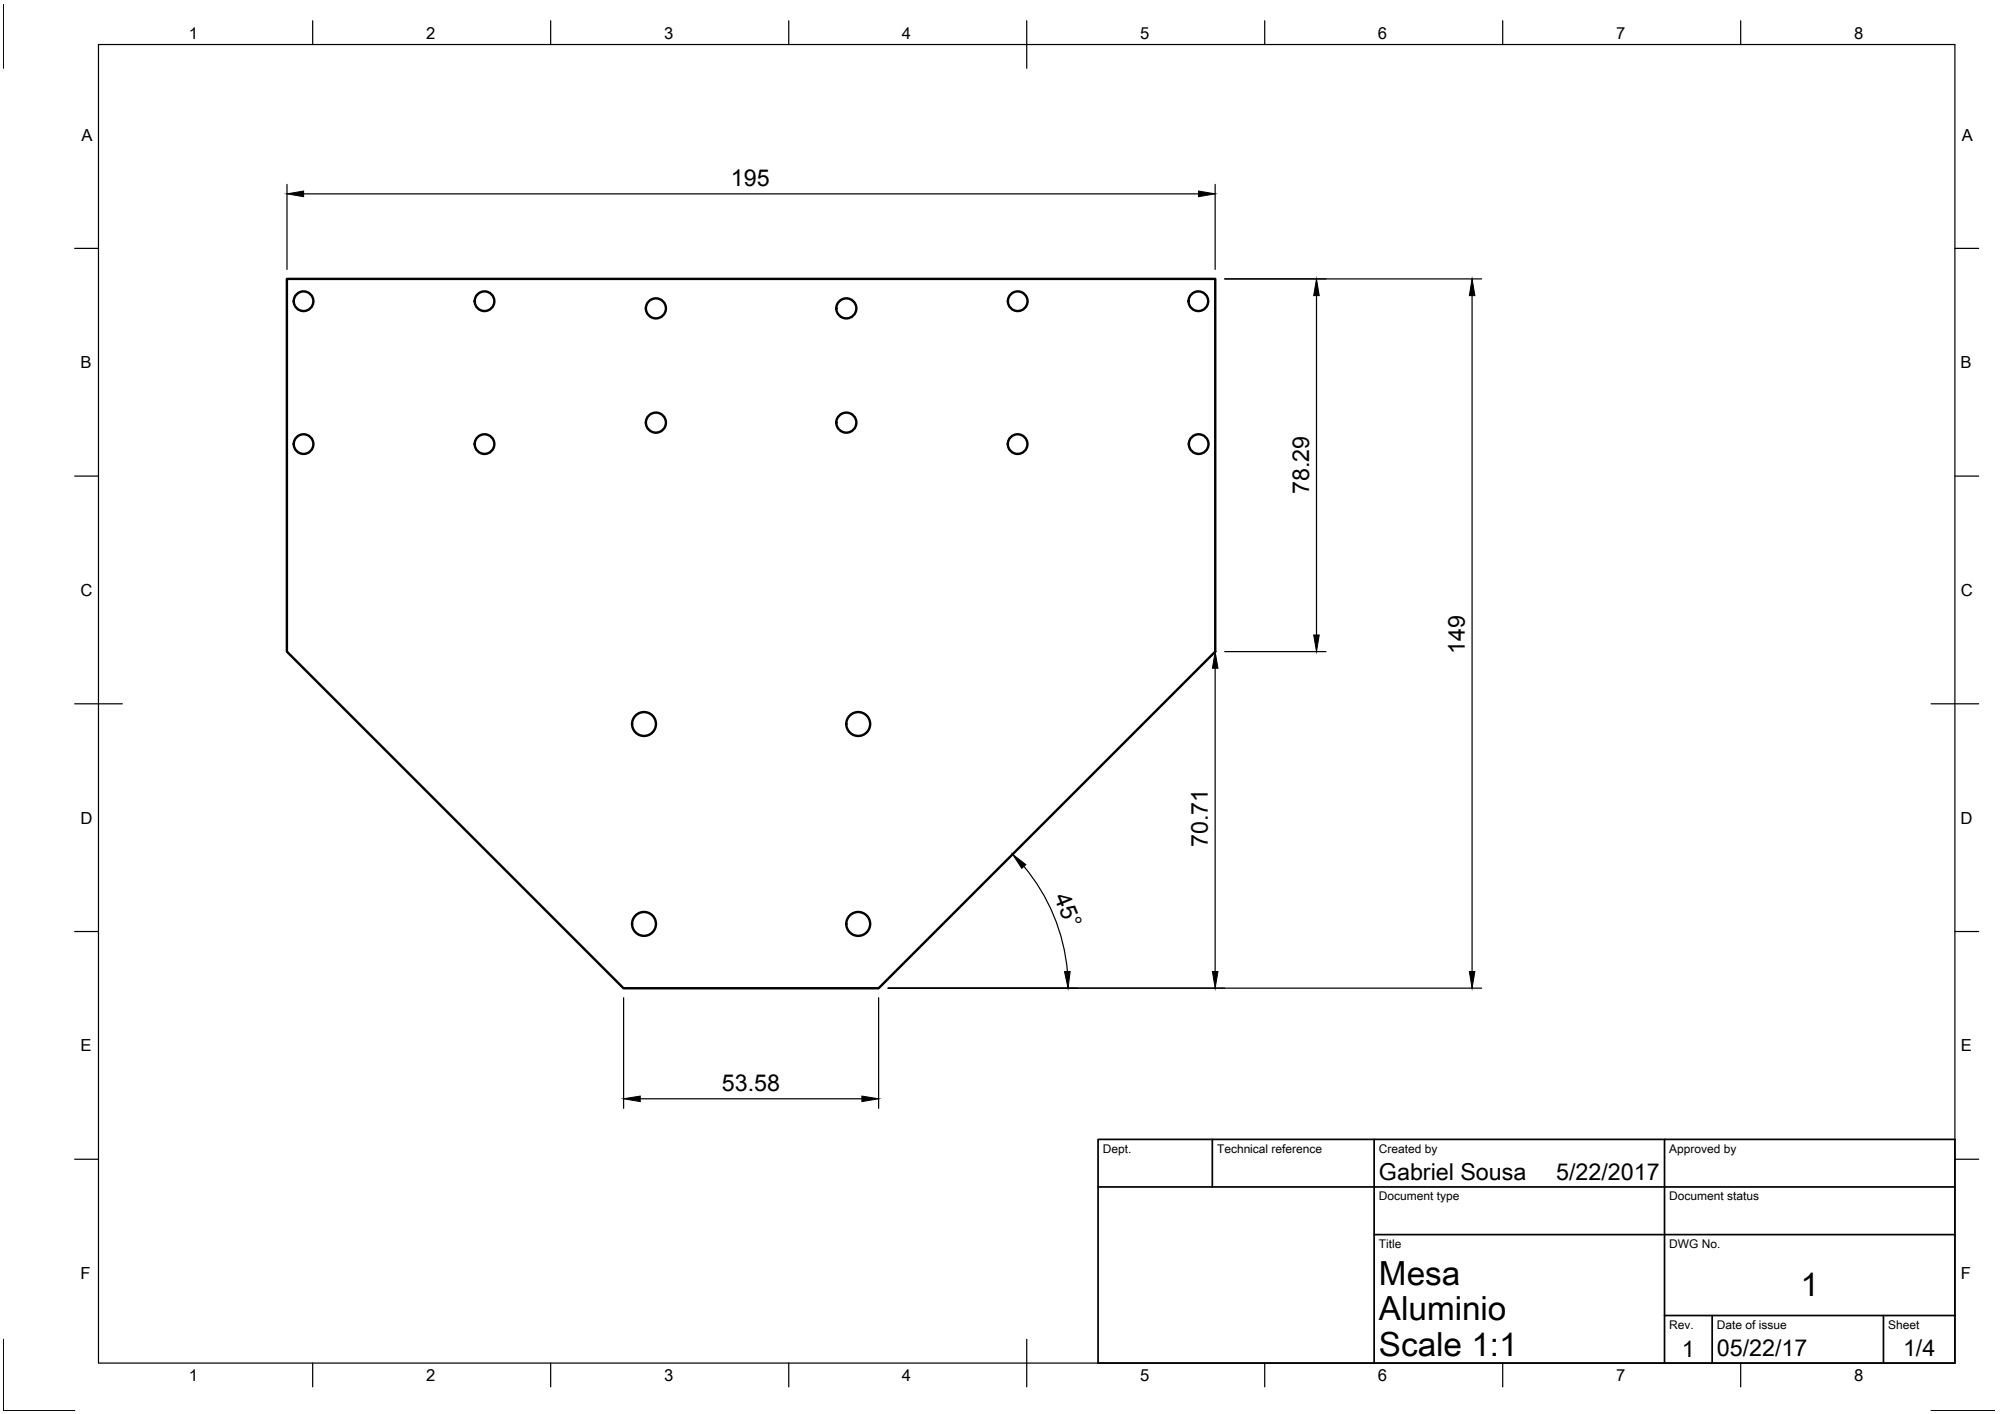
[picture p142: page 1]

Dept. | Technical reference | Created by Gabriel Sousa 5/22/2017 | Approved by

Document type | Document status

Title Mesa Aluminio Scale 1:1 | DWG No. 1

Rev. 1 | Date of issue 05/22/17 | Sheet

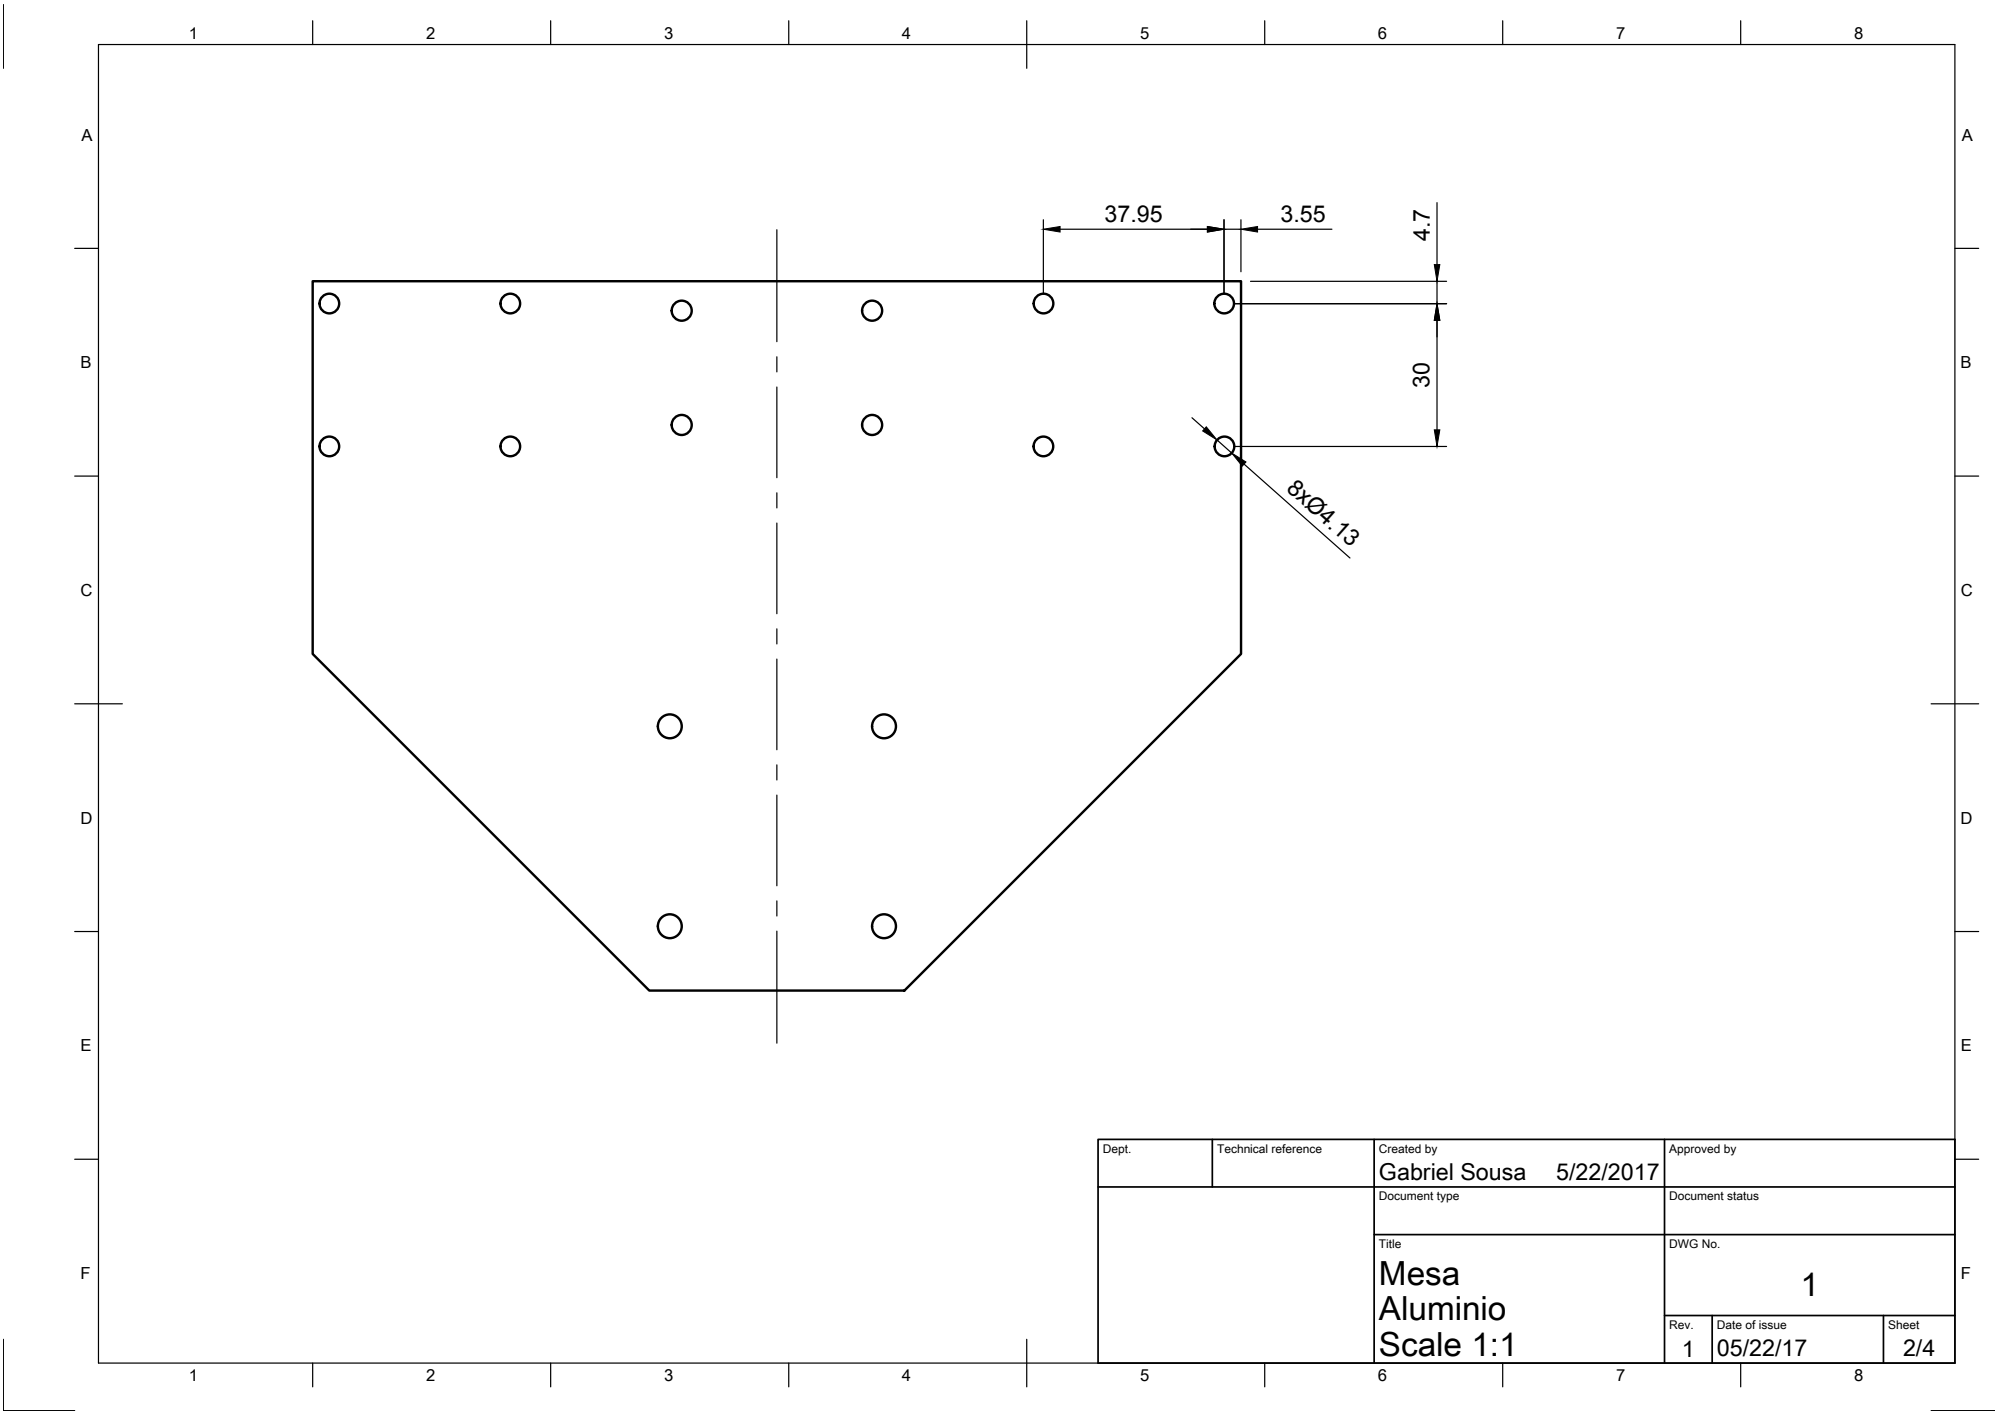
[picture p143: page 2]

Dept. | Technical reference | Created by Gabriel Sousa 5/22/2017 | Approved by

Document type | Document status

Title Mesa | DWG No. 1

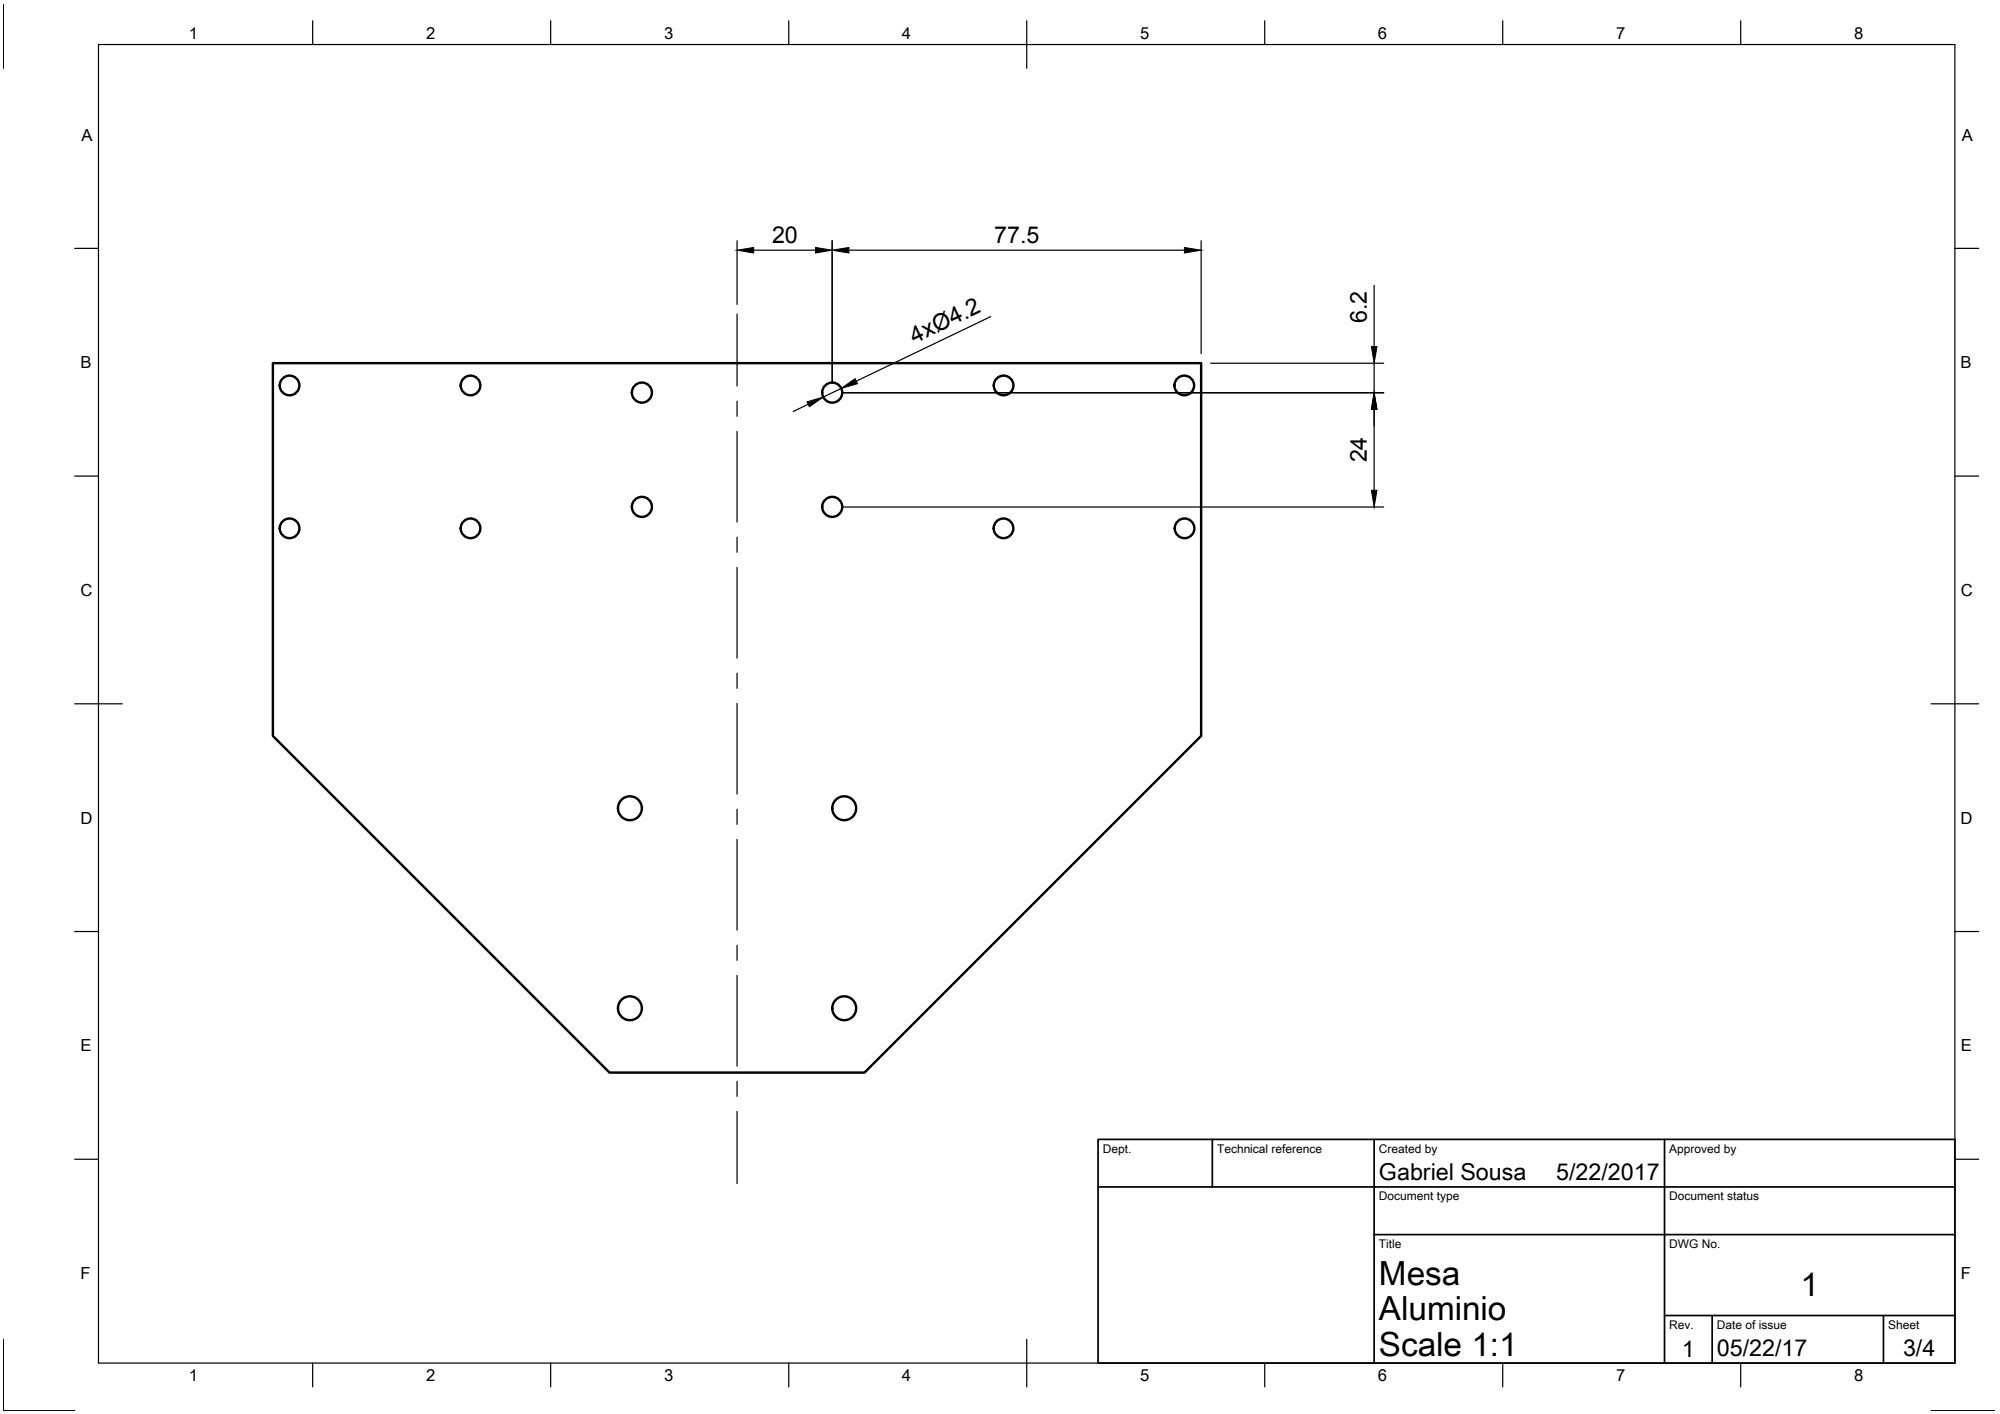
[picture p144: page 3]
Gabriel Sousa 24

Dept. | Technical reference | Created by 5/22/2017 | Approved by

Document type | Document status

Title Mesa | DWG No. 1

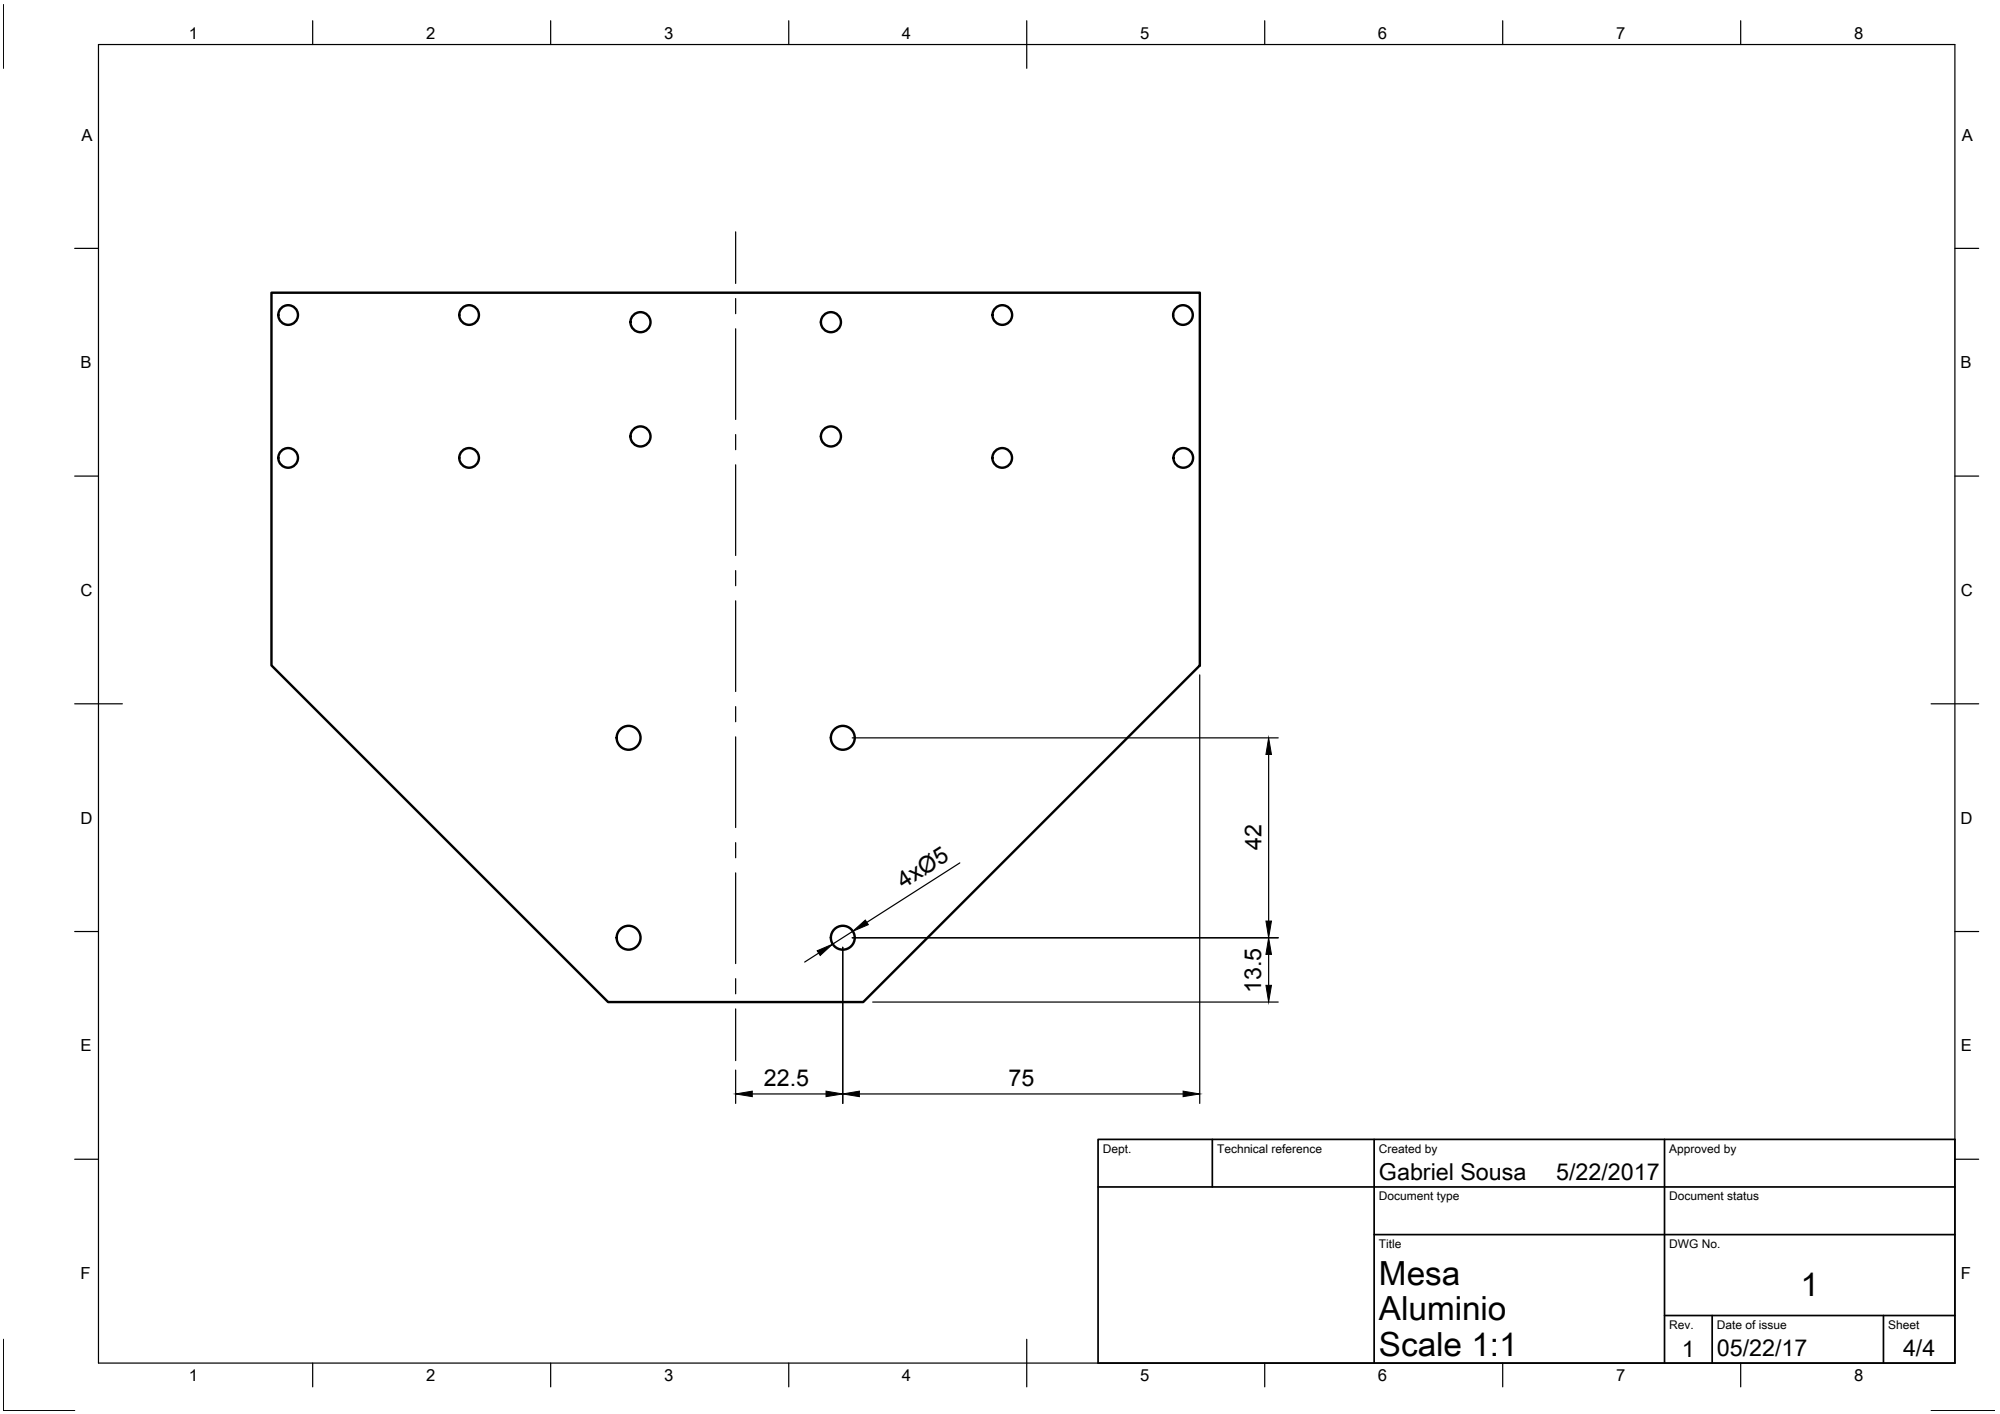
[picture p145: page 4]
Gabriel Sousa 42 13.5

Dept. | Technical reference | Created by 5/22/2017 | Approved by

Document type | Document status

Title Mesa | DWG No. 1
