pepocasella/Projeto-Mecatronico/Mecânica/Desenhos Técnicos/Pinça Drawing v1.pdf

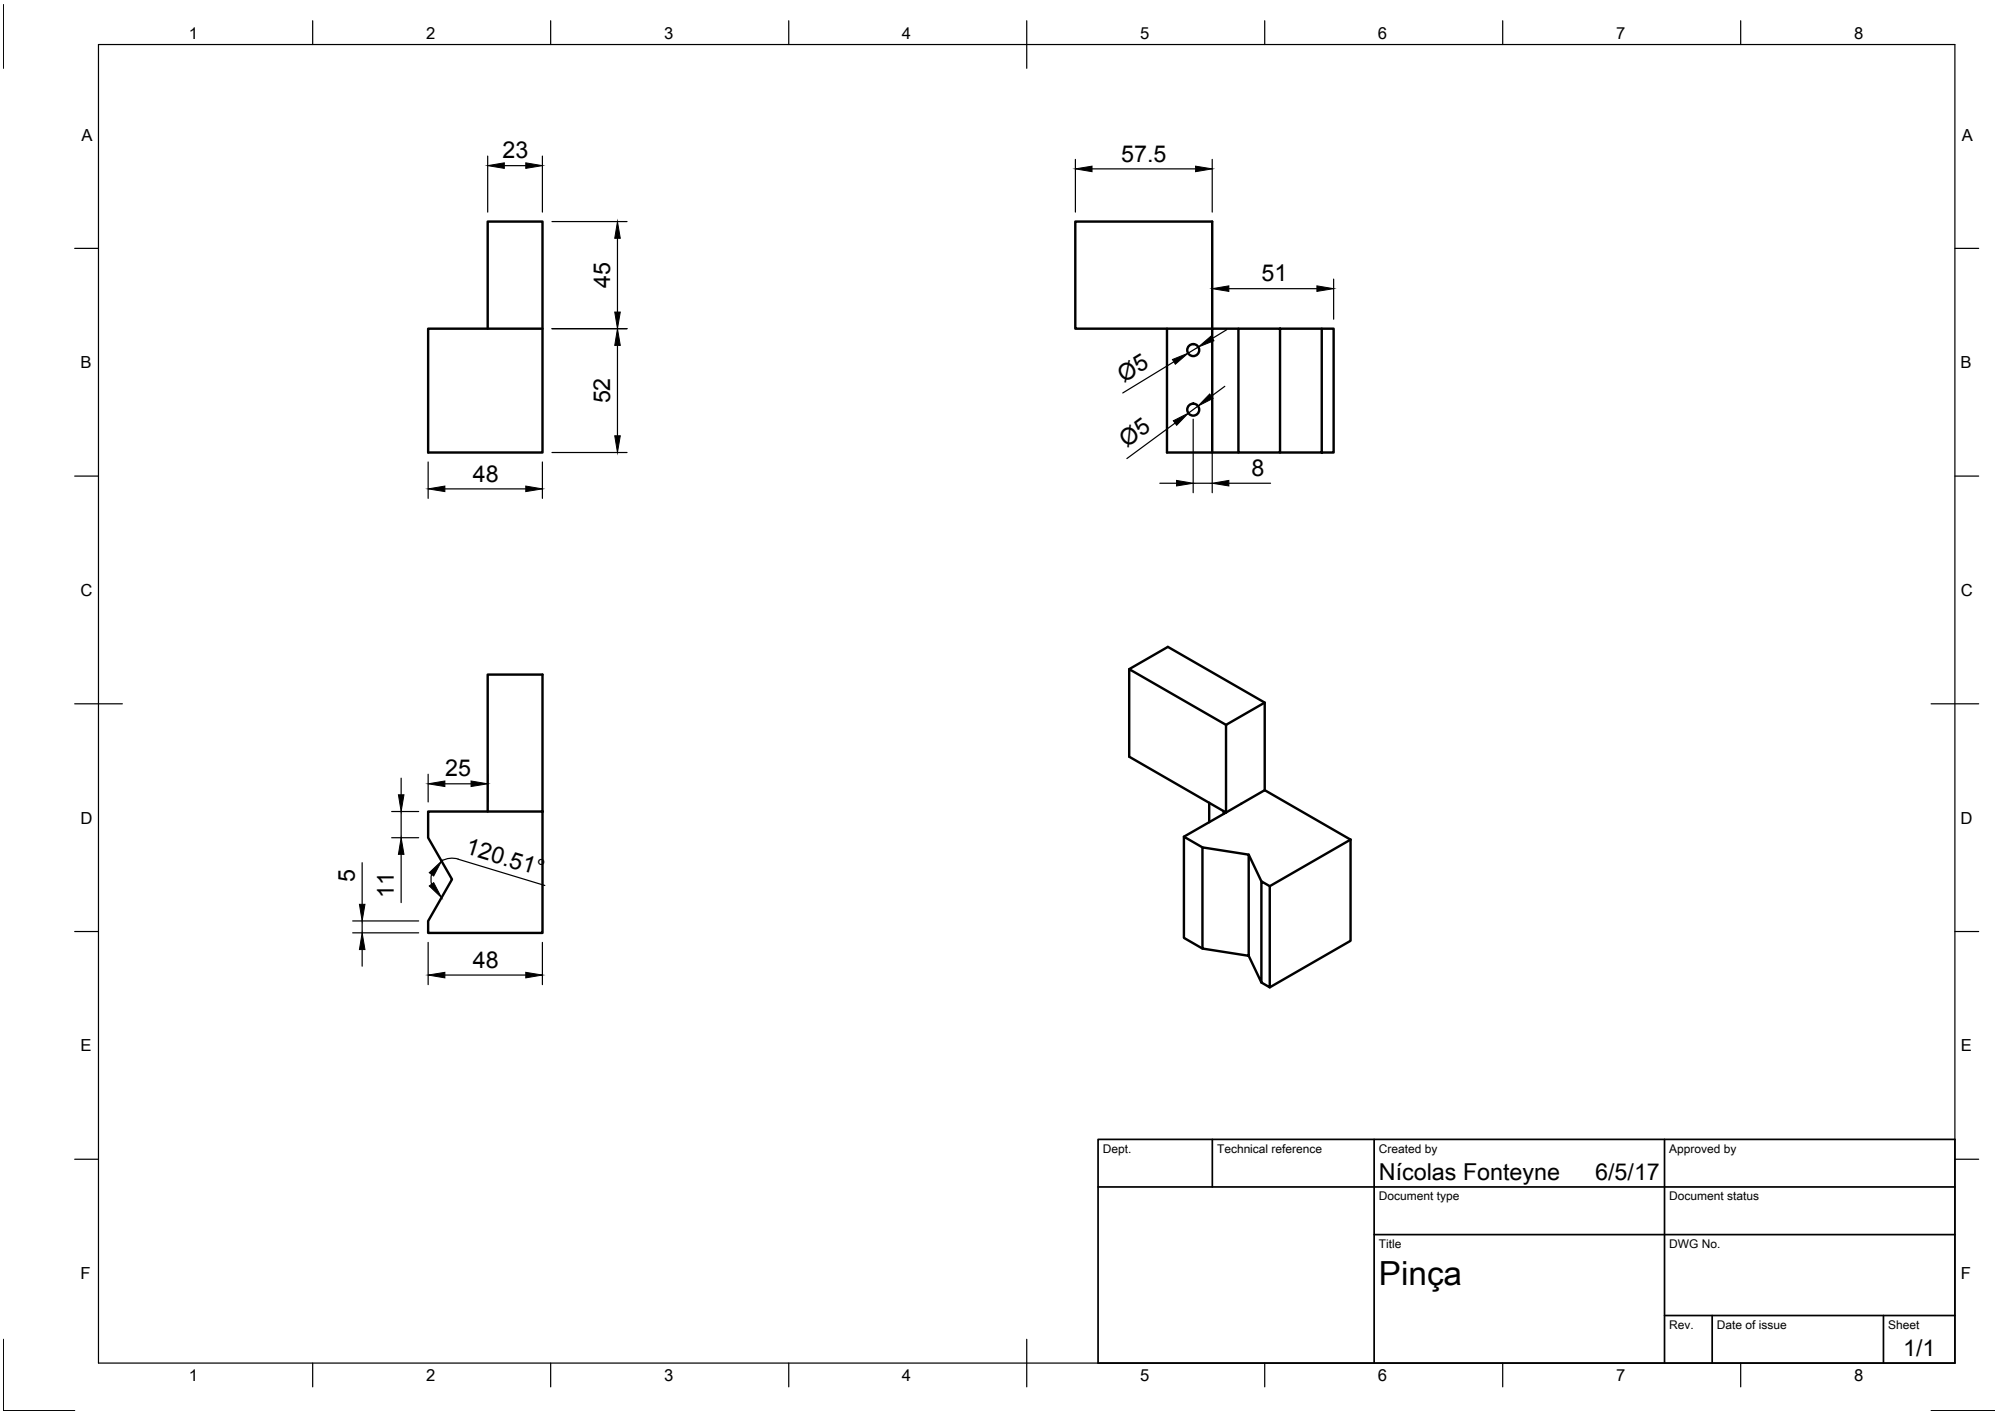
[picture p146: page 1]

Dept. | Technical reference | Created by Nícolas Fonteyne 6/5/17 | Approved by

Document type | Document status

Title Pinça | DWG No.

Rev. | Date of issue | Sheet 1/1
