pepocasella/Projeto-Mecatronico/Mecânica/Guia Linear/Desenho tecnico trilho guia linear.pdf

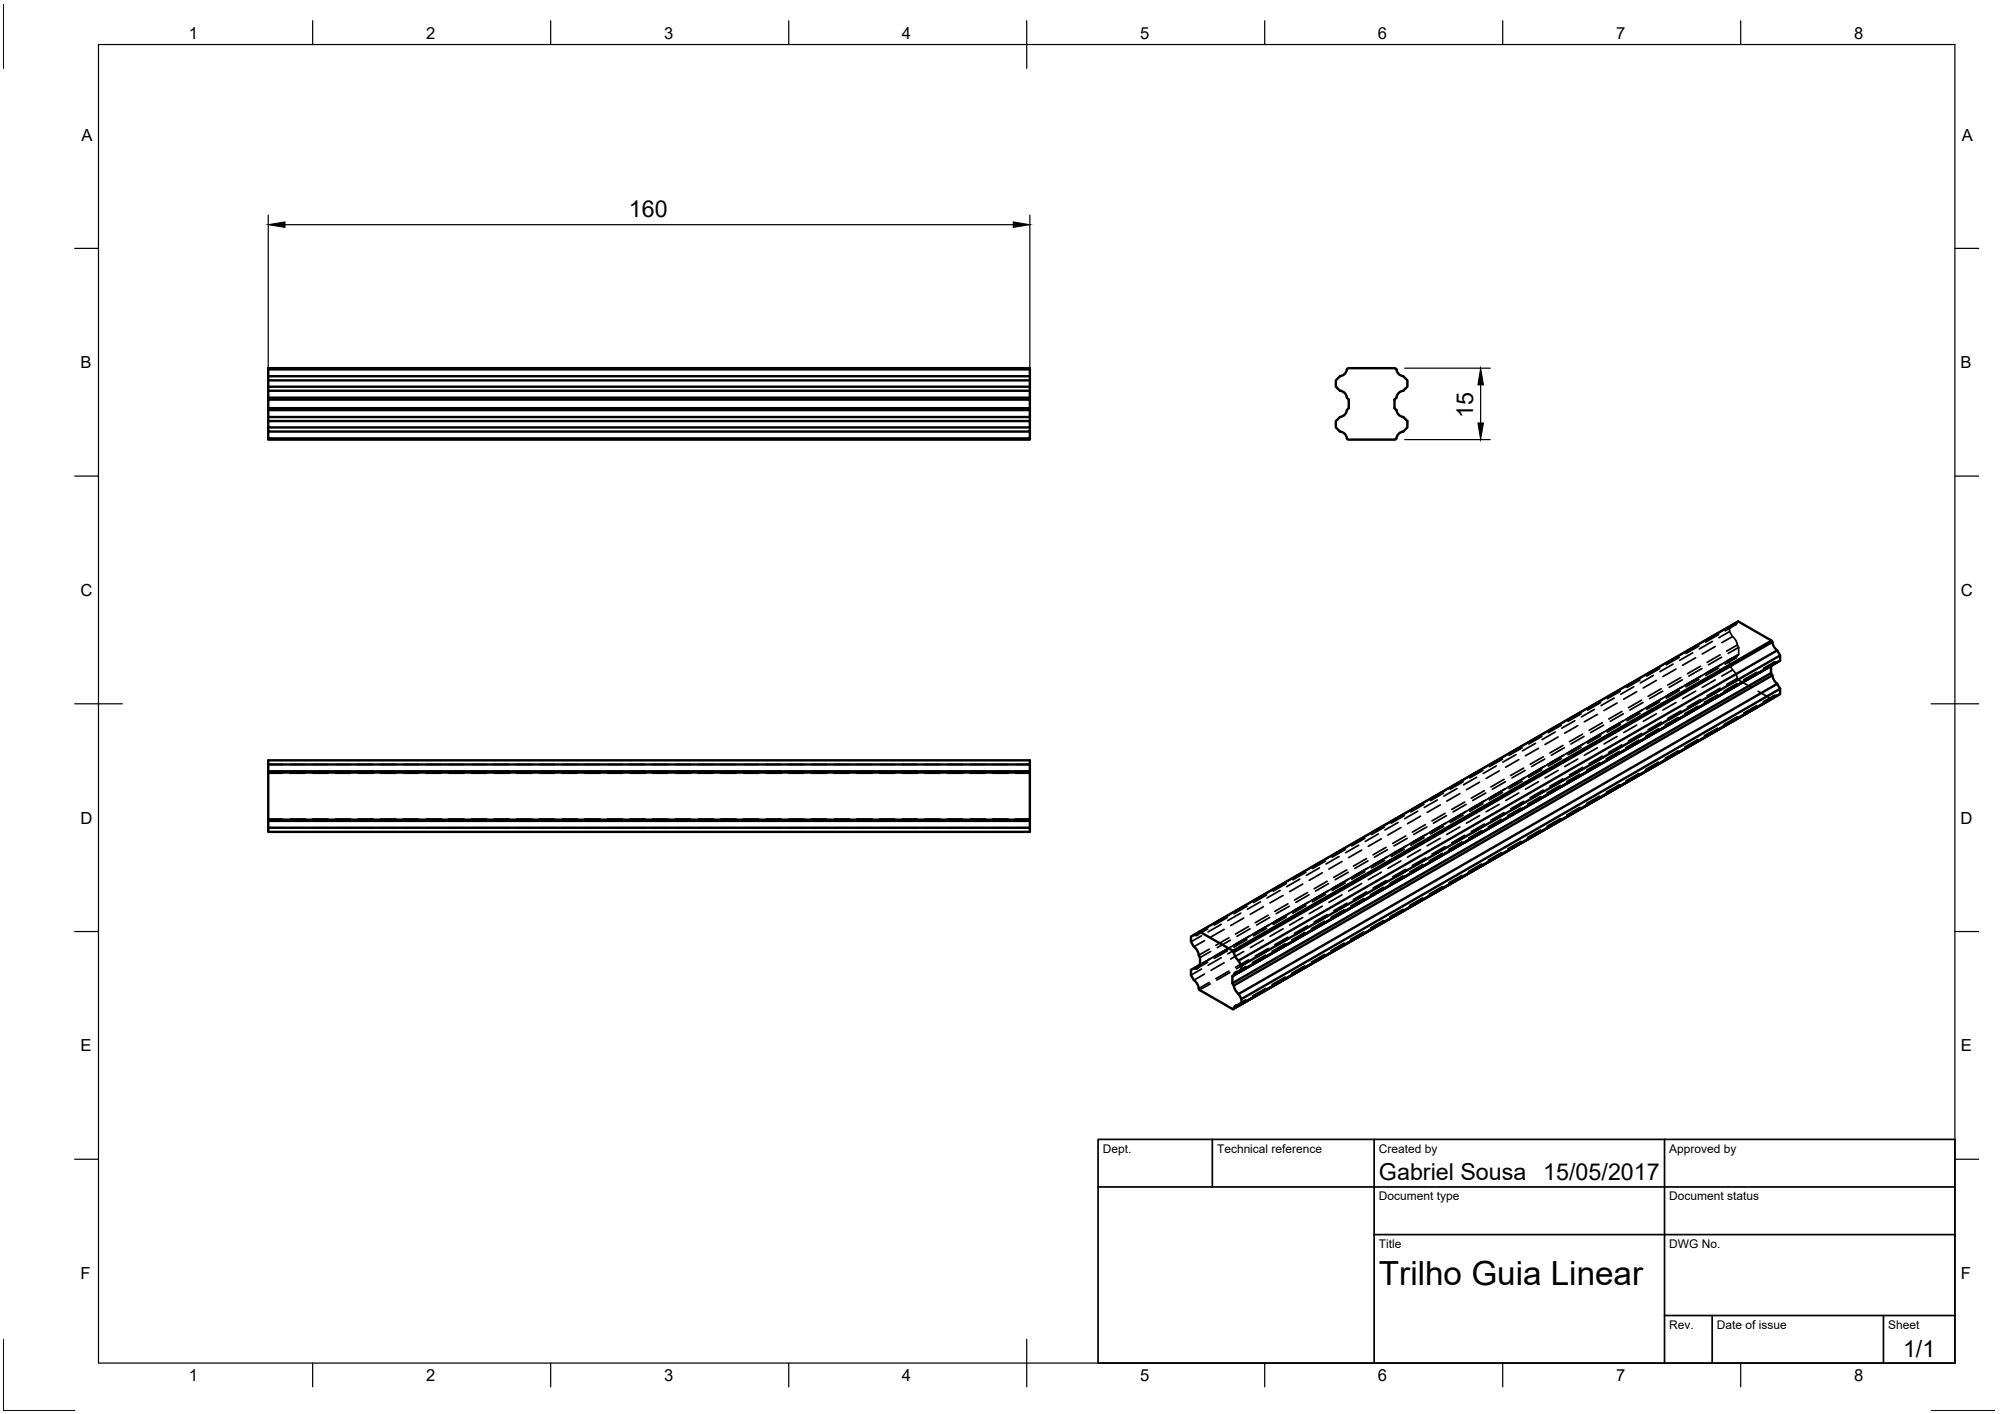
[picture p148: page 1]

Dept. | Technical reference | Created by Gabriel Sousa 15/05/2017 | Approved by

Document type | Document status

Title Trilho Guia Linear | DWG No.

Rev. | Date of issue | Sheet 1/1
