pepocasella/Projeto-Mecatronico/Code/mbed_config.h

/*
 * mbed SDK
 * Copyright (c) 2017 ARM Limited
 *
 * Licensed under the Apache License, Version 2.0 (the "License");
 * you may not use this file except in compliance with the License.
 * You may obtain a copy of the License at
 *
 * http://www.apache.org/licenses/LICENSE-2.0
 *
 * Unless required by applicable law or agreed to in writing, software
 * distributed under the License is distributed on an "AS IS" BASIS,
 * WITHOUT WARRANTIES OR CONDITIONS OF ANY KIND, either express or implied.
 * See the License for the specific language governing permissions and
 * limitations under the License.
 */

// Automatically generated configuration file.
// DO NOT EDIT, content will be overwritten.

#ifndef __MBED_CONFIG_DATA__
#define __MBED_CONFIG_DATA__

// Configuration parameters
#define CLOCK_SOURCE                             USE_PLL_HSE_EXTC|USE_PLL_HSI            // set by target:NUCLEO_F446ZE
#define LPTICKER_DELAY_TICKS                     1                                       // set by target:FAMILY_STM32
#define MBED_CONF_TARGET_BOOT_STACK_SIZE         0x1000                                  // set by target:Target
#define MBED_CONF_TARGET_CONSOLE_UART            1                                       // set by target:Target
#define MBED_CONF_TARGET_DEEP_SLEEP_LATENCY      3                                       // set by target:FAMILY_STM32
#define MBED_CONF_TARGET_LPTICKER_LPTIM_CLOCK    1                                       // set by target:FAMILY_STM32
#define MBED_CONF_TARGET_LPUART_CLOCK_SOURCE     USE_LPUART_CLK_LSE|USE_LPUART_CLK_PCLK1 // set by target:FAMILY_STM32
#define MBED_CONF_TARGET_LSE_AVAILABLE           1                                       // set by target:FAMILY_STM32
#define MBED_CONF_TARGET_MPU_ROM_END             0x0fffffff                              // set by target:Target
#define MBED_CONF_TARGET_TICKLESS_FROM_US_TICKER 1                                       // set by target:FAMILY_STM32

#endif
