pepocasella/Projeto-Mecatronico/FOTOS_PROJETO_MECAT/20170602_114706_001.jpg

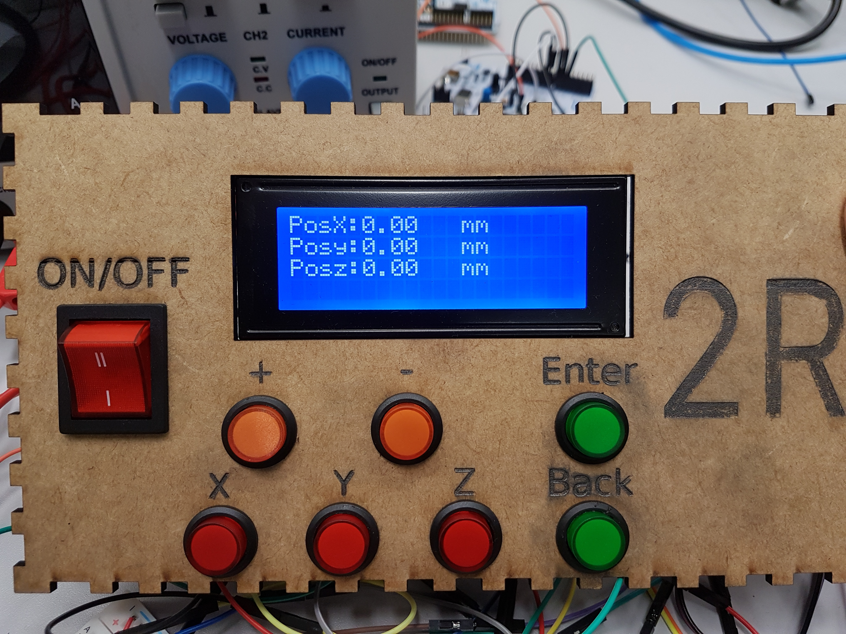
FOTOS_PROJETO_MECAT/20170602_114706_001.jpg
