pepocasella/Projeto-Mecatronico/FOTOS_PROJETO_MECAT/20170602_114750.jpg

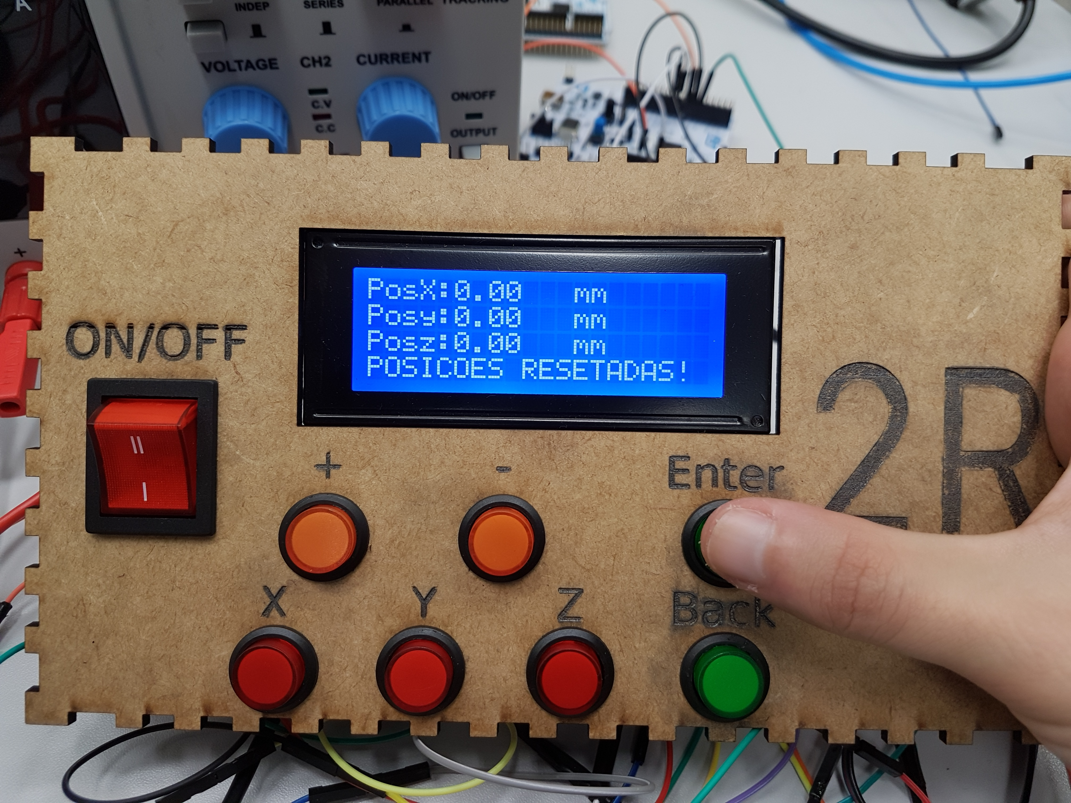
FOTOS_PROJETO_MECAT/20170602_114750.jpg
