pepocasella/Projeto-Mecatronico/FOTOS_PROJETO_MECAT/20170602_115355.jpg

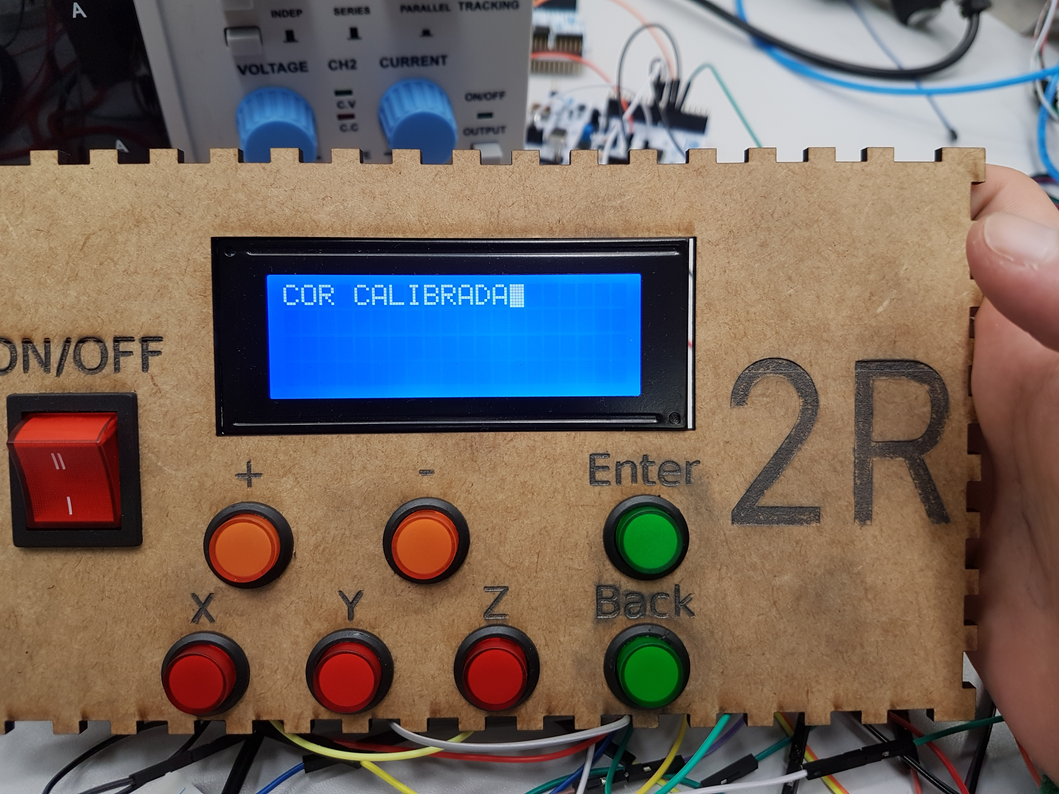
FOTOS_PROJETO_MECAT/20170602_115355.jpg
